OmarLopezCabrera/Tesis-SDR-LAPAC-Open-Source/Info Componentes/Power/ADP5054/PCB1.png

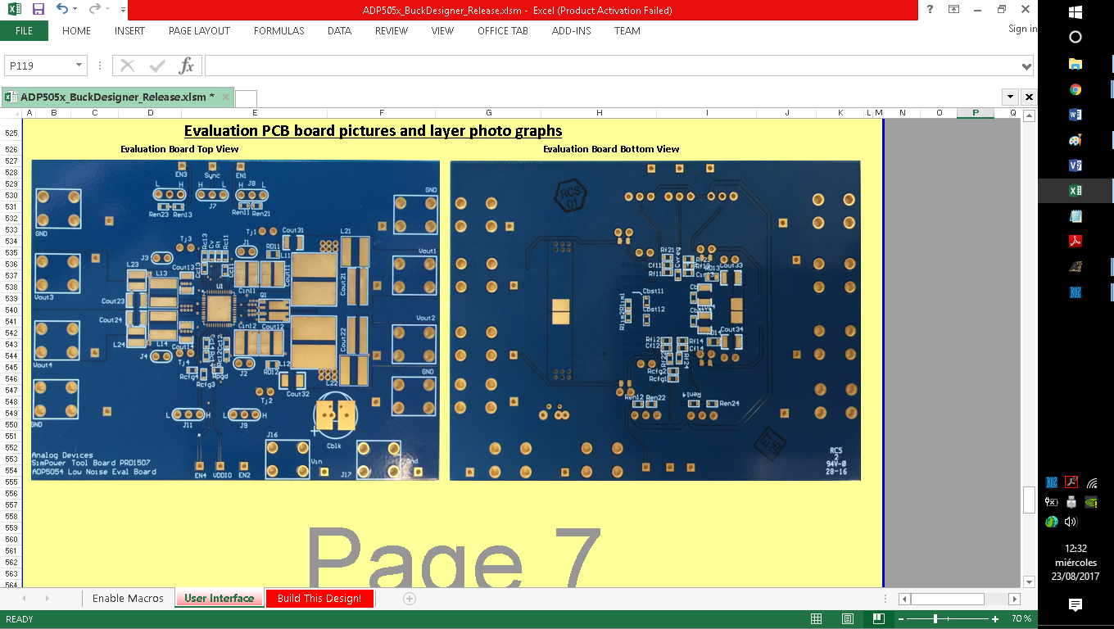
Info Componentes/Power/ADP5054/PCB1.png
