OmarLopezCabrera/Tesis-SDR-LAPAC-Open-Source/Info Componentes/Power/ADP5054/ADP505x_BuckDesigner_Release.pdf

and the security settings specified by you.

"User Interface" tab. A dialog box opens for you to enter your design

Excel 97-2003; Excel 2007

Disable all macros with notification), you will be prompted with a Security Warning: "Some

"Security Alert - Macros & ActiveX" or "Microsoft Office Excel Security Notice." or "Enable Macros", repsectively.

Microsoft Office button, Excel Options button, Trust Center category, Trust

Excel 2010
