OmarLopezCabrera/Tesis-SDR-LAPAC-Open-Source/Tesis(FaltaTerminar).pdf

## UNIVERSIDAD NACIONAL DE RÍO NEGRO

## PROYECTO FINAL INTEGRADOR

## Diseño e implementación de una

## Radio Definida por Software

Hecho por:

Omar López Cabrera

Director: Franco Alcaraz

Codirector: Federico Tula

Para el título de Ingeniería Electrónica

Índice

I

# Índice

Índice de figuras | IV
Índice de tablas | V
Lista de acrónimos | VI
Resumen | VIIII

## Tabla de contenido

Índice

II

Índice

III

Índice

IV

V

### Índice de Figuras

VI

### Índice de Tablas

VII

### Lista de Acrónimos

ADC: Analog to Digital Converter

ASICS: application specific integrated circuit

BB: Base Band

BBA: Base Band Amplifier

BBP: Base Band Processor

BGA: Ball Gate Array

BOM: Bill of Materials

CPU: Central Processing Unit.

CAD: Computer Assisted Design

DAC: Digital to Analog Converter

DDC: Digital Down Converter

DDR: Double Data Rate

DMA: Direct Memory Access

DUC: Digital Up Converter

DSP: Digital Signal Processor

EEPROM: Electrically Erasable Programmable Read-Only Memory

FAQ: Frequently Asked Questions

FDD: Frequency

FPGA: Field Programmable Gate Array

GPIO: General purpose input output

GPP: general purpose processor

IC: Integrated Circuit

JTAG: Joint Test Action Group

LPF: Low Pass Filter

LAPAC: Laboratorio de Procesamiento de Señales Aplicadas y Computación de Alto Rendimiento

MIMO: Multiple Input Multiple Output

VIII

PCB: Printed Circuit Board

RF: Radio Frequency

RFFE: Radio Frequency Front End

ROM: Read only memory

SDR Software Defined Radio

SPI: Serial Peripheral Interface

USB: Universal Serial Bus

XPE: Xilinx Power Estimator

IX

Resumen

Esta tesis describe el diseño del hardware para una Radio Definida por software (SDR). Partiendo de una arquitectura modular genérica, pasando a una arquitectura con componentes definidos, hasta el desarrollo del PCB de la misma.

Esta SDR cubre un rango de frecuencia de 70 MHz hasta 6 GHz, tiene una conexión USB 3.0 y una FPGA Artix-7. Dicha FPGA puede ser programable por USB; esta característica permite realizar experimentos en un rango de las siguientes señales: FM, TV brodcast, celular, Wi-Fi entre otros. El Front End de RF está compuesto por el transceiver AD9364 de Analog Devices el cual tiene 56 MHz de ancho de banda instantáneo. Este dispositivo puede ser alimentado por USB o por medio de un conector tipo Jack.

Esta placa puede utilizarse en los laboratorios de todos los cursos de comunicaciones de la carrera, además de los cursos de procesamiento de señales aleatorias y determinísticas. Solo requiere un par de antenas y contar con una computadora donde se programa el tipo de procesamiento que se desea hacer con los datos, utilizando software abierto (GNU Radio). Este tipo de equipos está presente en todas las carreras de Telecomunicaciones de las Universidades más prestigiosas del mundo, debido a la facilidad con que permiten realizar experimentos complejos y entender, rápidamente, el estado del arte. Al ser un desarrollo propio se pretende que el proyecto se pueda distribuir como hardware libre. De este modo, cualquier persona o institución que lo desee puede utilizarla si más que tener que mencionar el origen. Esto dará visibilidad a la UNRN y a la carrera de Ingeniería Electrónica en particular.

### 1. Introducción

## Capítulo 1

## 1. Introducción

1.1 Que es una radio definida por software

El termino radio definida por software fue utilizado por Joe Mitola en 1991 en referencia a las radios reprogramables o reconfigurables. En otras palabras, un mismo hardware puede realizar diferentes funciones en momentos diferentes. El foro de SDR las define como una radio en la cual se puede programar el tráfico y control de la información, soportando un amplio rango de frecuencias y aplicaciones de software. El usuario puede cambiar de un formato de comunicación a otro en cuestión de milisegundos, usar el GPS para localización o recibir una transmisión satelital.

1.2 Por qué utilizar radios definidas por software?

En el mundo de las comunicaciones inalámbricas, los estándares y protocolos avanzan a una velocidad tal que los equipos de comunicaciones quedan obsoletos poco después de su producción. Para remediar esto, las SDR representan un cambio en el paradigma comparado con las radios tradicionales, en donde gran parte de su funcionalidad es implementada mediante software en lugar de hardware. Este cambio, reduce la cantidad de componentes analógicos y de radio frecuencia (RF), haciendo énfasis en el procesamiento de señales y la programación, logrando una gran versatilidad en el receptor.

1.3 Aplicaciones y características de las SDR

Interoperabilidad: Una SDR puede operar como puente entre múltiples sistemas de radios incompatibles. Interoperabilidad es una de las principales razones por las cuales los militares estaban interesados en ellas. Diferentes ramas de los militares y los policías usan decenas de radios incompatibles, escondiendo comunicaciones durante operaciones conjuntas. Una SDR multicanal puede actuar como intérprete de las diferentes radios.

### 1. Introducción

Eficiencia en el uso de recursos ante condiciones variables: Una SDR puede adaptar la forma de onda para maximizar algún parámetro clave. Por ejemplo, una forma de onda de baja potencia puede ser seleccionada si la radio esta baja de batería. Una señal de alta tasa puede ser seleccionada si se requiere bajar un archivo rápido. Eligiendo la forma de onda más apropiada en cada escenario, las radios pueden proveer una mejor experiencia al usuario (por ejemplo, mayor durabilidad de la batería).

Uso conveniente de las frecuencias (Radio Cognitiva): Una SDR puede sacar ventaja del espectro de frecuencia que no está siendo utilizado. Si el dueño de la porción de espectro no está utilizando la misma, una SDR puede pedir prestado hasta que el dueño vuelva. Esta técnica tiene un gran potencial para incrementar la cantidad de espectro disponible.

Aumento de tiempo de vida útil: Una SDR puede actualizarse en el campo para soportar los últimos estándares de comunicaciones. Esta capacidad es de especial importancia para el ciclo de vida de las radios en aplicaciones militares, comunicaciones o aeroespaciales .Por ejemplo, un nuevo estándar de celular que sale al mercado puede ser cargado remotamente mediante un nuevo software en la estación base (SDR), ahorrando costos de un nuevo hardware y trabajo de instalación.

Bajo costo: Una SDR puede adaptarse para usarse en diferentes mercados y múltiples aplicaciones. Algunas radios pueden ser vendidas a compañías de celulares o automóviles, reduciendo costos de mantenimiento y entrenamiento.

Investigación y desarrollo: Las SDR puede ser utilizadas para implementar diferentes formas de ondas en tiempo real para análisis de performance.

1.4 Requerimientos/ objetivos de la tesis

La finalidad de este Proyecto Final integrador es el diseño e implementación de una Radio Definida por Software (SDR: Software Defined Radio). Además de este objetivo principal el plan de trabajo estipulaba los siguientes requerimientos:

- Poder escuchar las radios comerciales de FM mediante el hardware a desarrollar y una computadora utilizando el programa open source GNU-RADIO.

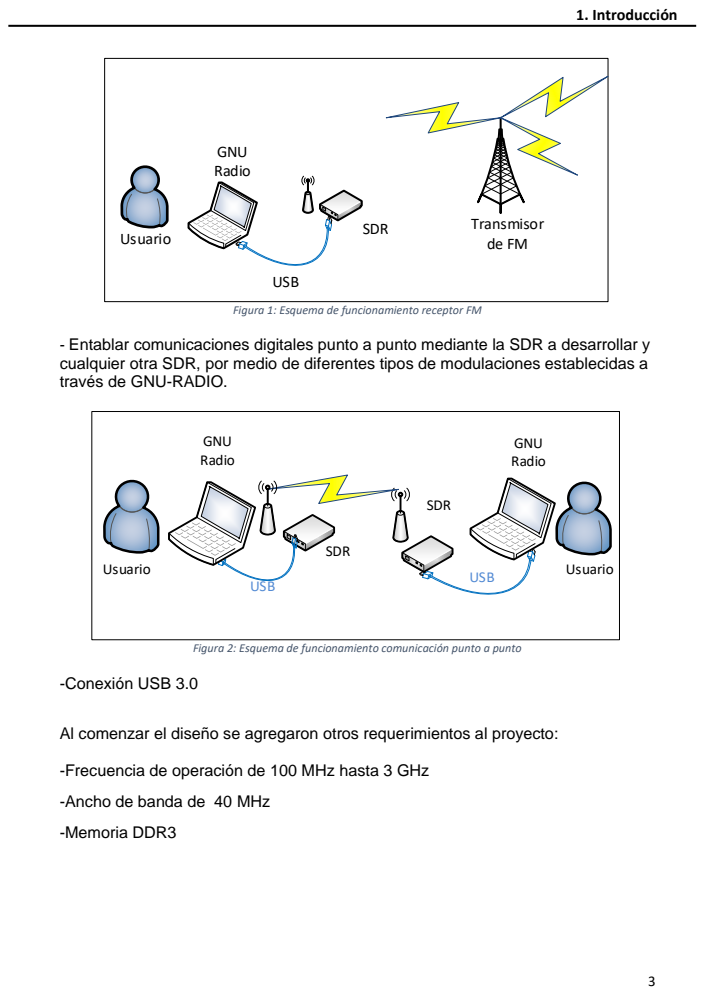
[picture p2: page 13]
1. Introducción; USB; SDR; Transmisor; Usuario; GNU Radio; USB USB; -Conexión USB 3.0; -Memoria DDR3

Figura 1: Esquema de funcionamiento receptor FM

- Entablar comunicaciones digitales punto a punto mediante la SDR a desarrollar y
cualquier otra SDR, por medio de diferentes tipos de modulaciones establecidas a
través de GNU-RADIO.

Figura 2: Esquema de funcionamiento comunicación punto a punto

Al comenzar el diseño se agregaron otros requerimientos al proyecto:

-Frecuencia de operación de 100 MHz hasta 3 GHz

-Ancho de banda de 40 MHz

### 1. Introducción

1.5 Metodología de diseño

Para realizar este proyecto se utilizó una metodología de diseño Top-Down. La cual consiste en capturar una idea con un alto nivel de abstracción, implementarla partiendo de la misma, e incrementar el nivel de detalle según sea necesario. El sistema inicial se va subdividiendo en módulos, estableciendo una jerarquía. Cada módulo se subdivide hasta llegar a los componentes primarios del diseño.

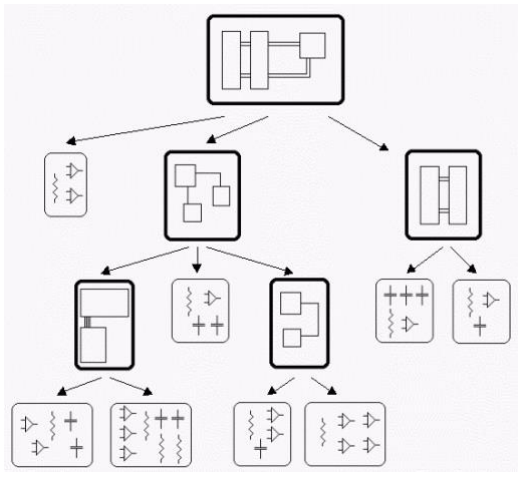
[picture p3: figure]

Figura 3: Diagrama metodología de diseño Top-Down

Utilizando la idea de este método se desarrolló el diseño de la SDR dividiendo al mismo en las siguientes etapas:

- Diseño Modular según funciones
- Diseño Modular especifico
- Selección de Componentes
- Diseño del esquemático
- Diseño del PCB
- Simulaciones
- Fabricación y ensamblado de la placa
- Puesta en marcha

### 1. Introducción

Debido a la envergadura del proyecto no se pudieron realizar las últimas tres etapas, quedando estas como trabajo a futuro.

### Agregar sección comparando radio tradicional con SDR. Gráficos de las dos y tabla de ventaja y desventaja ?

### 2. Diseño

## Capítulo 2

## 2. Diseño

2.1 Arquitectura general según funciones

La arquitectura de las SDR debe permitir que el funcionamiento del sistema sea definido por software, esto significa, que una porción del sistema se implementara mediante programación y/o reconfiguración del hardware. Permitiendo que el hardware del sistema pueda reutilizarse para distintas aplicaciones sin la necesidad de modificaciones físicas del mismo.

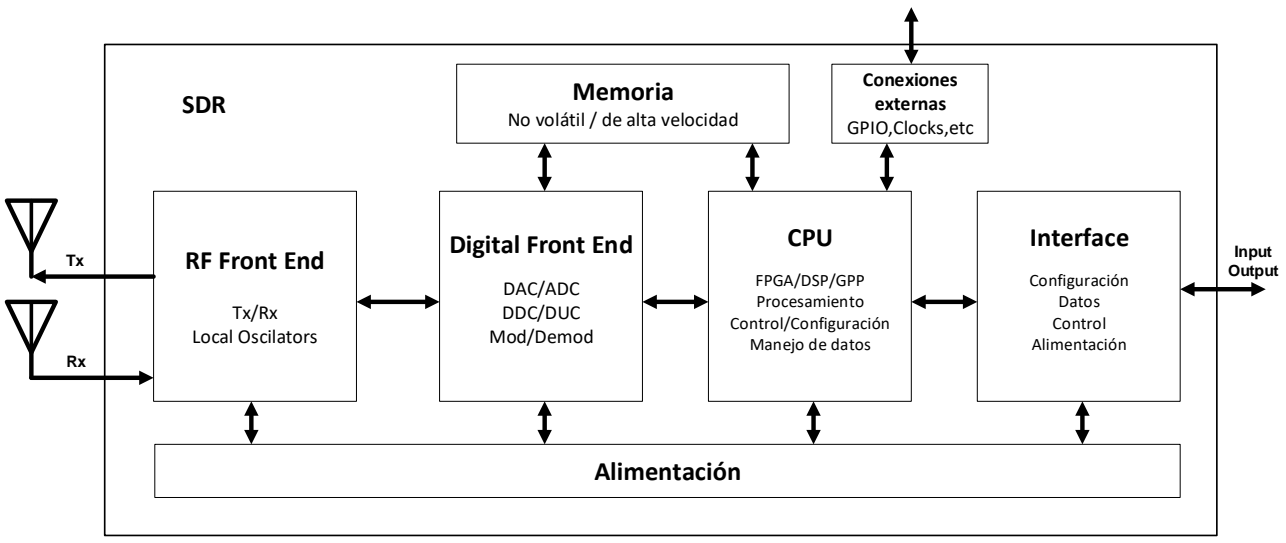
[picture p4: figure]
Digital Front End; DAC/ADC DDC/DUC Mod/Demod; RF Front End; Tx/Rx Local Oscilators; CPU; FPGA/DSP/GPP Procesamiento Control/Configuración Manejo de datos; Interface; Configuración Datos Control Alimentación; Memoria; No volátil / de alta velocidad; Alimentación; Conexiones externas GPIO,Clocks,etc; SDR; Input Output

Figura 4: Diagrama en bloques de la arquitectura general de la SDR

2.1.1 Antenas

Conjuntos de antenas de transmisión y recepción. Las mismas deben ser capaces de operar en el rango de frecuencia requerido.

2.1.2 RF Front-End

Su función es el acondicionamientos tanto de las señales recibidas como las transmitidas por las antenas correspondientes. En dicho acondicionamiento comprende: filtrado, amplificación, conversión de frecuencia etc.

### 2. Diseño

2.1.3 Digital Front-End

La función de este módulo es la conversión analógica-digital en la recepción y digital-analógica en la transmisión.

También es posible realizar procesamientos digitales sobre las señales como por ejemplo:

-Modulación

-Demodulación

-Diezmado

-Interpolación

2.1.4 CPU

Sus principales funciones son: control, configuración, manejo de datos e interconexión entre los diferentes módulos (memoria, gpio, external interface, digital front-end).

Además también se puede realizar procesamientos, algoritmos, encriptación/des encriptación etc.

2.1.5 Memoria

La memoria del sistema puede estar compuesta por memorias de alta velocidad y/o memorias no volátiles.

2.1.6 Conexiones externas

Este módulo contiene las conexiones físicas de la SDR con elementos externos, como por ejemplo: GPIO, alimentación, Clock externo, etc.

2.1.7 Interfaces

Es el bloque que encargado de las interconexiones de la SDR con el resto de sistema, para las líneas de datos, configuración, programación y control.

### 2. Diseño

2.1.8 Alimentación

Su función es proveer la alimentación a los módulos nombrados anteriormente. En el mismo se realizaran las diferentes conversiones de DC a DC que sean necesarias.

2.2 Arquitectura definida

En base a las funciones expuestas en la sección anterior, los requerimientos y los componentes disponibles en el mercado se decidió adoptar la siguiente arquitectura para la implementación de la SDR.

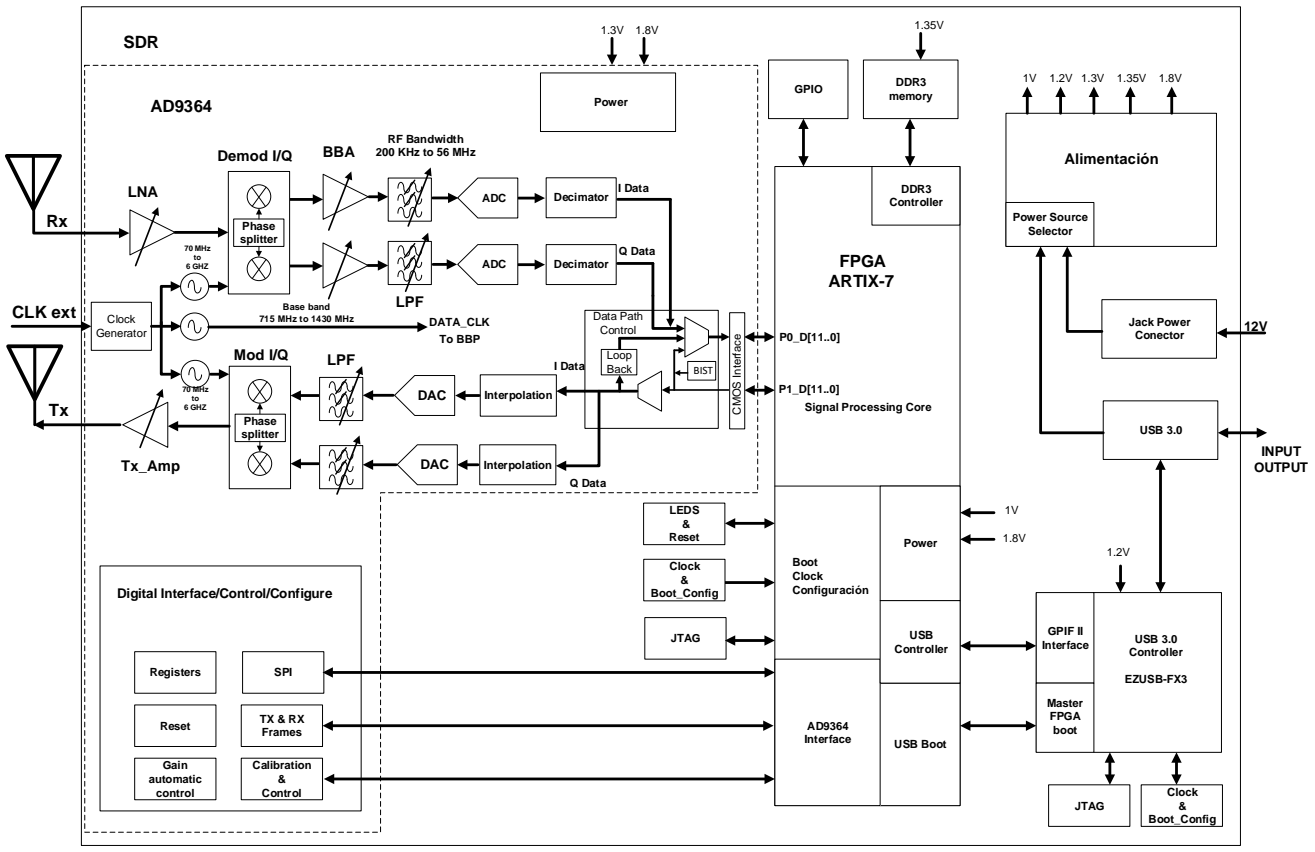
[picture p5: figure]
Digital Interface/Control/Configure; FPGA ARTIX-7; Signal Processing Core; Boot Clock Configuración; USB 3.0 Controller; EZUSB-FX3; USB 3.0; DDR3 memory GPIO; LEDS &; Reset; JTAG; USB Boot; Decimator; Interpolation; Phase splitter; DDR3 Controller; Alimentación; Jack Power Conector; Power Source Selector; Clock &; Boot_Config; Clock Generator; SPI; Calibration &; Control; Registers; Gain automatic control; Frames; Interface; Clock & Boot_Config; 70 MHz to 6 GHZ; Base band CLK ext; 715 MHz to 1430 MHz; GPIF II Interface USB Controller; Master FPGA; boot; I Data; Q Data; LNA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

Figura 5: Diagrama en bloques de la Arquitectura definida de la SDR

A continuación se detallara información sobre cada módulo de esta arquitectura.

### 2. Diseño

2.2.1 RF Front End & Digital Front End

Se decidió utilizar un transceiver integrando ambos Front End en un solo IC, lo que significa una menor cantidad de componentes y superficie. Este fue el primer componente seleccionado, ya que el mismo determinara las principales características de la SDR (ancho de banda, rango de frecuencia, etc.). Además el mismo fija requerimientos para las demás etapas del sistema (alimentación a utilizar, tasa de datos necesaria, etc.).

En base a los requerimientos estipulados los posibles transceiver encontrados en el mercado fueron los siguientes:

Tabla 1: Transceivers disponibles en mercado.

Se descartó el transceiver LMS6002 por los siguientes motivos:

- No cumple con el ancho de banda (requerimiento que podría ser flexible debido a su bajo precio).
- Ya existe una SDR open source que utiliza este transceiver (proporcionan: gerbers, esquemáticos y proyecto entero en Altium Designer).
- Escases de información en cuanto a funcionamiento y guías de diseño.

Se decidió utilizar el AD9364 y dejar al AD9361 para una posible mejora a futuro convirtiendo a la SDR en una MIMO. En particular ya existen SDRs open source con este transceiver (empresa Ettus) pero solo comparten información sobre el esquemático.

Este dispositivo combina un Front End de RF con un flexible mezclador de señales en banda base y un sintetizador de frecuencia integrado. Simplificando el diseño a una interface digital de configuración por medio de un procesador.

Por medio del bus SPI se tiene todo el control de toda la parte digital del AD9364.Cada registro SPI es de 8 bit de ancho y contienen: bits de control, monitores de estado y otras configuraciones que controla todas las funciones del dispositivo (filtrado, ganancia, etc.).
En la siguiente figura exponemos que porción de la arquitectura de la SDR será cubierta por este IC:
Integrado | fabricante | Ancho de banda | Rango de Frecuencia | Costo($USD)
AD9361 | Analog Devices | 56 MHz | 70 MHz-6GHz | 214.31
AD9364 | Analog Devices | 56 MHz | 70 MHz-6GHz | 159.20
LMS6002DFN | Lime MicroSystems | 28MHz | 0.3-3.8GHz | 35.00

### 2. Diseño

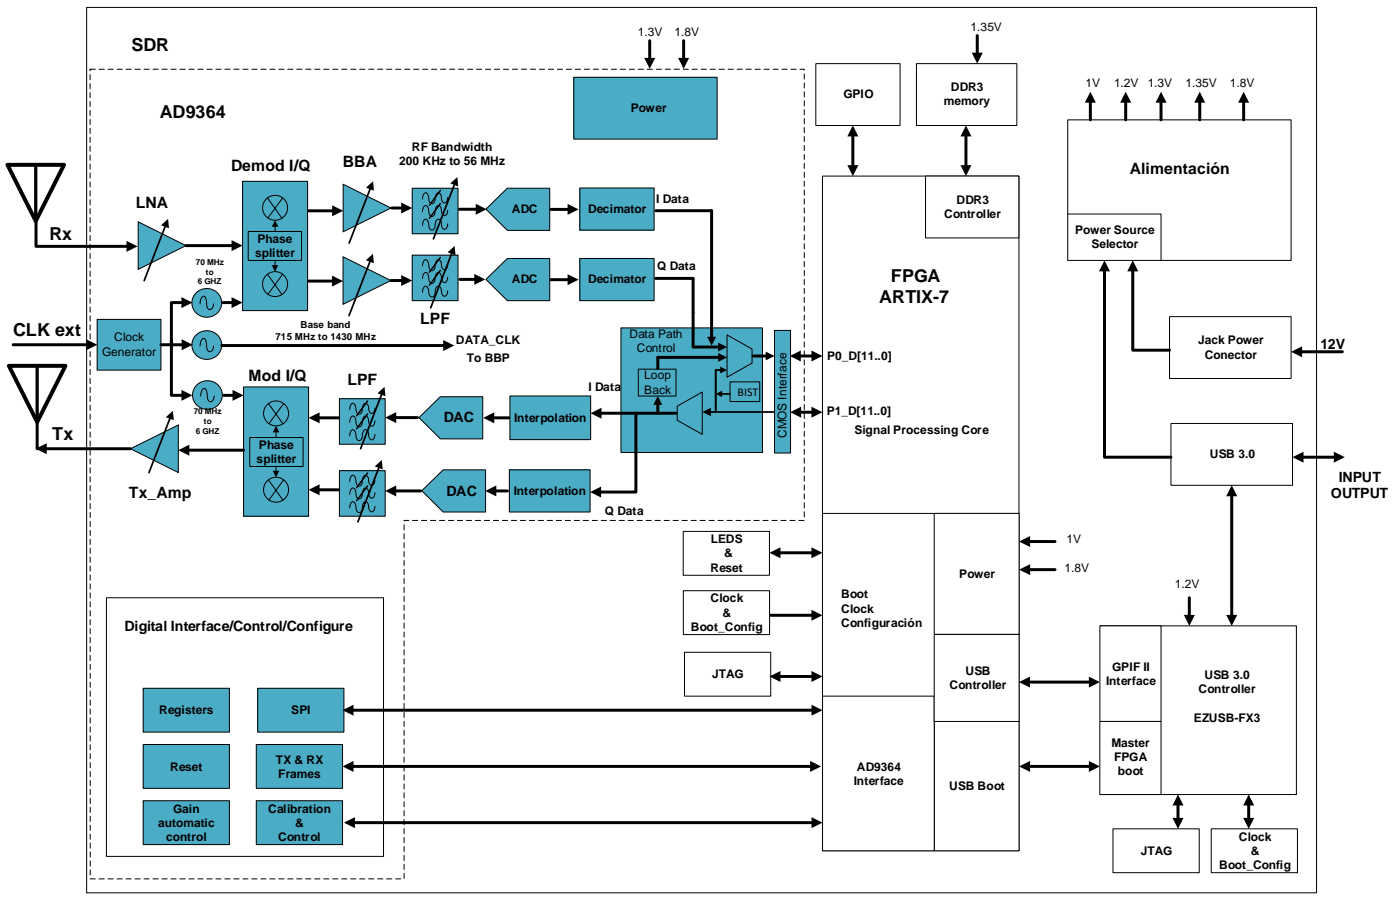
[picture p6: figure]
Digital Interface/Control/Configure; FPGA ARTIX-7; Signal Processing Core; Boot Clock Configuración; USB 3.0 Controller; EZUSB-FX3; USB 3.0; DDR3 memory GPIO; LEDS &; Reset; JTAG; USB Boot; Decimator; Interpolation; Phase splitter; DDR3 Controller; Alimentación; Jack Power Conector; Power Source Selector; Clock &; Boot_Config; Clock Generator; SPI; Calibration &; Control; Registers; Gain automatic control; Frames; Interface; Clock & Boot_Config; 70 MHz to 6 GHZ; Base band CLK ext; 715 MHz to 1430 MHz; GPIF II Interface USB Controller; Master FPGA boot; I Data; Q Data; LNA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

Figura 6: Diagrama de arquitectura definida, sección transceiver

Este conjunto de módulos tendrá las siguientes funciones:

- Convertir las señales de RF a BB para la recepción
- Convertir las señales BB a RF para la transmisión
- Acondicionamiento de las señales

A continuación se explicara la función que cumple cada uno de los módulos que componen al transceiver:

Analog to Digital conversión (ADC).

Convierte al dominio digital de las señales en banda base entregadas por todo el camino de recepción. El mismo es de 12 bits.

Digital to Analog conversión (DAC).

Conversión al dominio analógico de las señales en banda base a ser entregadas al camino de transmisión (up-conversión) por la antena de la SDR. El mismo es de 12 bits.

### 2. Diseño

Demod I/Q

Convierte la señal de RF que entrega la cadena de recepción del RFFE a banda base para su posterior digitalización y procesamiento.

Mod I/Q

Convierte la señal en banda base a transmitir a RF para ser luego amplificadas por el RFFE en su cadena de transmisión.

Diezmado

El proceso de diezmado consiste en quedarse con una de cada n muestras, siempre dentro de los límites de Nyquist. Este límite es determinado por el ancho de banda de los filtros pasa bajo.
Este proceso es útil ya que baja la tasa de datos hacia procesador y demanda menos almacenamiento.

Interpolación

El proceso de interpolación consiste en aumentar la tasa de muestreo en n. Este proceso no cambia la frecuencia de la señal solo su tasa de muestreo.

Low noise amplifier (LNA)

Los amplificadores de bajo ruido amplifican señales de bajo poder sin degradar su relación señal a ruido. Este es un componente clave en el Front-End de RF para reducir el ruido, ya que la figura de ruido es dominada por las primeras etapas del receptor.

Low Pass Filter (LPF)

Los filtros pasa bajo dejan pasar las señales con una frecuencia menor a la frecuencia corte y atenúa las señales mayores a la misma. En particular estos filtros son de tercer orden Butterworth y su frecuencia de corte es programable en el rango de 200 kHz a 39.2 Mhz.

Generador de señales BITS

### 2. Diseño

Este integrado dispone en un generador de señales interno con el cual se puede inyectar señales tanto en el puerto de salida de datos de Tx como en el de entrada de Rx. Este es útil como herramienta de debugging a la hora de probar la conectividad de los puertos de Tx y Rx.

Digital Interface

Por medio este módulo se realiza la interface con el BBP, pudiendo configurar completamente el transceiver. Cada uno de los módulos nombrados anteriormente (ADC, filtros, etc.) esta mapeado a una dirección memoria (registros), los cuales se van modificando por comandos a través de SPI. Mediante estas modificaciones se puede configurar entre otras cosas:

- Ganancia de los amplificadores.
- Frecuencia de corte filtros.
- Frecuencia de los osciladores locales.
- Modo de operación.
- Calibración.

2.2.1.1 Modos de funcionamiento del transceiver

Este transceiver puede ser utilizado en los siguientes modos de operación:

Dual port full duplex mode.

El modo de operación Dual Port Full Duplex es usado en aplicaciones que requieren operar en FDD (frequency-division duplex) y tasas de dato menores a 61.44 MHz. En este modo ambos puertos de datos son utilizados, P0 es asignado a los datos recibidos y P1 es asignado a los datos transmitidos. Cada bus de datos opera simultáneamente, permitiendo una transferencia full dúplex para los datos de transmisión y recepción entre el BBP y el AD9364.
La siguiente figura muestra las conexiones entre el transceiver AD9364 y el BBP (FPGA) para este modo de operación.

### 2. Diseño

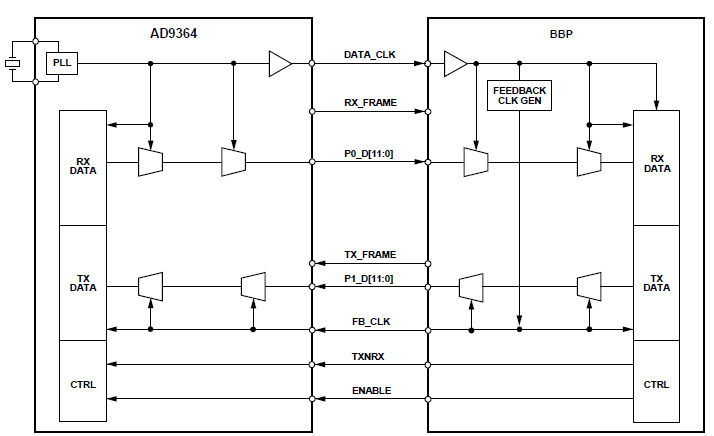
[picture p7: figure]

Figura 7: Diagrama de conexión transceiver-FPGA modo de operación full dúplex

Los datos transmitidos en P1_D[11:0] que van desde el BBP hacia el AD9364 son capturados por medio del FB_CLK. Mientras que los datos recibidos en P0_D[11:0] que van desde el AD9364 hacia el BPP son capturados por medio de DATA_CLK.

Un pulso en el pin de ENABLE (un flanco ascendente) dispara el comienzo de transferencia de datos y otro pulso (un flanco descendente) da fin a la transferencia de datos.

Las señales Rx_FRAME y Tx_FRAME (con un flanco ascendente) indican el comienzo de un conjunto de muestras (frames).

Para los datos de Tx, P1_D[11] es el bit más significativo y P1_D[0] es el bit menos significativo. Para los datos de Rx, P0_D[11] es el bit más significativo y P0_D[0] es el bit menos significativo.

Los datos I/Q son transportados en el mismo bus en cada dirección. Para un solo camino de RF en cada dirección los datos son transportados de la siguiente manera:

Datos de Tx o Rx : I, Q, I, Q, …..

A continuación se mostraran unos diagramas de tiempos de las distintas señales tanto para la transmisión como la recepción, en el modo de operación full dúplex.

Figura 8: Diagrama tiempo, recepción en modo full dúplex

### 2. Diseño

Falta comentar imagen

Figura 9: Diagrama de tiempo, transmisión en modo full dúplex

Falta comentar imagen

Dual port half duplex mode.

El modo de operación dual port half dúplex es utilizado en aplicaciones que requieren operaciones TDD (time-division dúplex) y una tasa de datos hasta 61.44 MHz. En este modo ambos puertos son utilizados, el puerto P0 es asignado a los datos I y el puerto P1 es asignado a los datos Q. En este modo los puertos operan de forma bidireccional, la dirección es determinado por el canal que está activo: transmisión o recepción. La siguiente figura ilustra las conexiones entre el AD9364 y el BBP en este modo de operación.

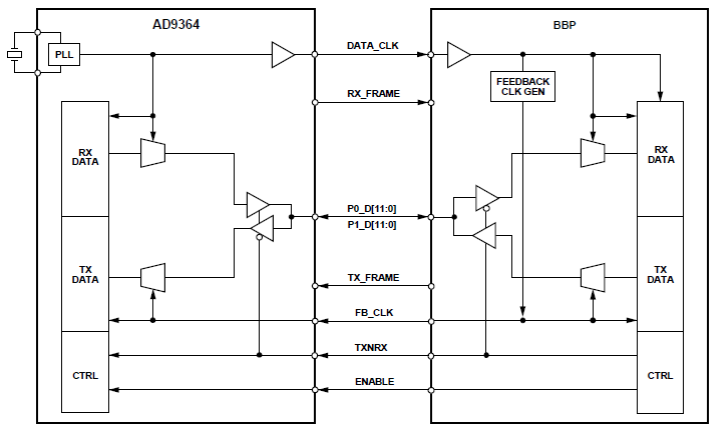
[picture p8: figure]

Figura 10: Diagrama de conexión transceiver-FPGA modo de operación half dúplex

Durante una ráfaga de recepción, los datos suministrados por el AD9364 hacia el BBP son capturados por medio del DATA_CLK. La transferencia de datos empieza cuando una señal de pulso alto aparece en el pin de ENABLE y la misma termina cuando el pulso vuelve a bajo.

La dirección de la transferencia de datos es determinada por la señal TXNRX. Cuando esta señal es baja el AD9364 está en modo de recepción, configurándose el bus en la dirección de recibir, los datos son transferidos desde el AD9364 hacia el BBP. Cuando la señal de TXNRX es alta, la dirección de transmisión del bus es cambiada, los datos son transferidos desde el BBP hacia el AD9364.Durante una ráfaga de transmisión los datos suministrados

### 2. Diseño

desde el BBP hacia el AD9364 son capturados por medio de FB_CLK. Las señales Rx_FRAME y Tx_FRAME indican el comienzo de un conjunto de muestras.

Para las líneas de datos D[11] es el bit más significativo mientras que D[0] es el bit menos significativo. Las muestras son separadas de la siguiente manera: los datos I en el puerto P0_D[11:0] y los datos Q en el puerto P1_D[11:0].

A continuación se mostraran unos diagramas de tiempos de las distintas señales tanto para la transmisión como la recepción para el modo de operación half dúplex.

Figura 11: Diagrama de tiempo, recepción en modo de operación half dúplex

Falta comentar imagen

Figura 12: Diagrama de tiempo, transmisión en modo de operación half dúplex

Falta comentar imagen

2.2.2 USB 3.0

La mayor tasa de datos del sistema está determinado por el transceiver, el cual tiene una tasa máxima de aproximadamente 188 MB/seg (66.44 Mhz de clock máximo y 24 líneas de dato).Para este proyecto una conexión USB 2.0 (60 MB/seg idealmente) no es suficiente para operar a la máxima tasa de datos por la tanto se decidió utilizar una conexión USB 3.0 (625 MB/seg).

2.2.2.1 Información general USB 3.0

Las especificaciones del USB 3.0 permite una tasa de transferencia máxima de 5 Gbps (SuperSpeed), la cual es 10 veces más que la tasa del USB 2.0

### 2. Diseño

(High Speed).La arquitectura del USB 3.0 contiene tres capas: physical layer, link layer y protocol layer.

Physical Layer

La capa física hace referencia al puerto de conexión y al cable de conexión, mediante el cual se realiza el upstream y downtream. Los cables diferenciales de transmisión y recepción de datos del USB 3.0 esta mallados y separados. Los cables USB 3.0 incluyen a los utilizados en el USB 2.0 como se muestra en la siguiente figura.

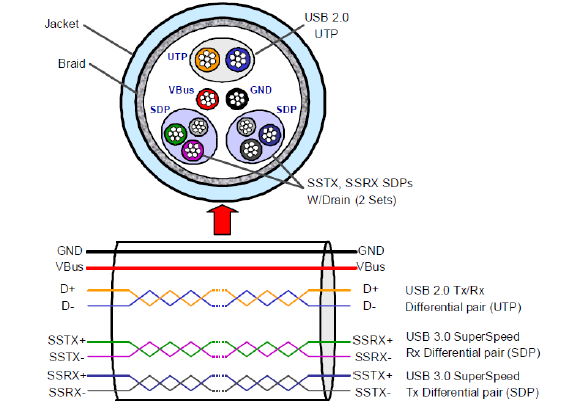
[picture p9: figure]

Figura 13: Cables USB 3.0

El bus SuperSpeed emplea un enfoque dual y simple, el cual permite transmitir y recibir paquetes simultáneamente. Por ejemplo durante una ráfaga de transacciones, el dispositivo puede recibir datos desde el host y devolver una confirmación asociada con los datos recibidos.

Link Layer

La link layer es la responsable de mantener una comunicación confiable y robusta entre el host y el dispositivo. Este mantenimiento lo realiza utilizando una máquina de estados llamada “Link Training and Status State Machine” (LTSSM).

Protocol Layer

La capa de protocolo maneja las reglas de comunicación entre el host y el dispositivo.

2.2.2.2 Controlador USB 3.0 CYUSB3014

### 2. Diseño

El dispositivo que se decidió utilizar como controlador del USB3.0 es el CYUSB3014 de la compañía Cypress. Este es un controlador de periféricos de SuperSpeed que provee características integradas y flexibles.

Este controlador es totalmente configurable, paralelo y posee una interface programable llamada GPIF II, mediante la cual se puede conectar a cualquier tipo de procesador, ASIC o FPGA.

A continuación se mostrara una vista general de este dispositivo:

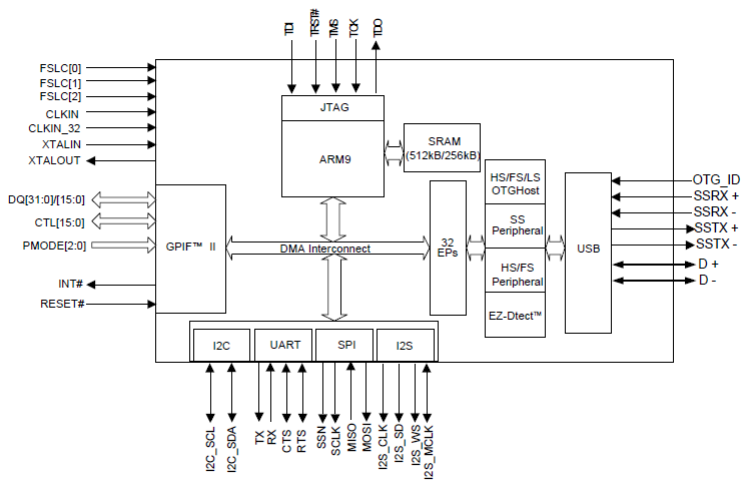
[picture p10: figure]

Figura 14: Diagrama en bloques controlador USB 3.0

CPU

El dispositivo cuenta con un CPU de 32 bits, un ARM92EJ-S de 200 MHz. Este core tiene acceso directo a una memoria de instrucciones de 16 KB y una de 8 KB para datos. Además tiene dos memorias cache (una para instrucciones y otra para datos) de 8KB cada una.
DMA

El dispositivo habilita eficientes y flexibles transferencias del DMA entre varios periféricos (USB, GPIF II, SPI, I2S y UART).

JTAG Interface

### 2. Diseño

Es una interface estándar de 5 pines para conectar el JTGA con el debug firmware a través del CPU. Cualquier herramienta estándar de debugging para ARM926EJ-S puede ser utilizada para este dispositivo.

Boot Options

El dispositivo tiene integrado una ROM de 32 KB, la cual contiene el bootloader, permitiendo que se baje la imagen desde diferentes fuentes. El modo de boot se selecciona mediante los pines PMODE, la siguiente tabla muestra las diferentes configuraciones de boot.

Tabla 2: Opciones de Booting USB 3.0
Z = Pin is floating; left unconnected.

En este caso se decidió que el boot sea por medio de una memoria EEPROM y en caso de fallo por medio del USB (PMODE [2:0] = 000).

CLOCKING

Este dispositivo permite conectar un cristal entre los pines XTALIN y XTALOUT o conectar un clock externo en pin CLKIN. Estos pines pueden dejarse sin conectar de no ser usados. La frecuencia de cristal soportada es de 19.2 MHz.

Mediante los pines FSLC [2:0] se determina que opción fue seleccionada: cristal o clock externo. La siguiente tabla muestra las diferentes opciones de cristal o clock externo:

FSLC[2] | FSLC[1] | FSLC[0] | Crystal/Clock Frequency
0 | 0 | 0 | 19.2-MHz Crystal
1 | 0 | 0 | 19.2-MHz Input CLK
1 | 0 | 1 | 26-MHz Input CLK
1 | 1 | 0 | 38.4-MHz Input CLK
1 | 1 | 1 | 52-MHz input CLK
Tabla 3: Selección de clock USB 3.0
PMODE[2:0] | Boot Option
PMODE[2] | PMODE[1] | PMODE[0]
Z | 0 | 0 | Sync ADMUX (16-bit)
Z | 0 | 1 | Async ADMUX (16-bit)
Z | 0 | Z | Async SRAM (16-bit)
Z | 1 | 1 | USB Boot
1 | Z | Z | I2C
Z | 1 | Z | I2C; on failure, USB Boot is enabled
0 | Z | 1 | SPI; on failure, USB Boot is enabled
0 | 0 | 0 | S0-port (eMMC); On Failure, USB Boot is enabled

### 2. Diseño

Como fuente de clock se utilizó un cristal de 19.2 MHz (FSCL[2:0] = 000).

GPIF II

La interface GPIF II es una máquina de estado programable la cual permite una interface flexible con la CPU, esta puede funcionar como master o slave.

GPIF II tiene las siguientes características:

-Funciona como master o slave.

-Ofrece 256 estados de firmware programables.

-Soporta 8-bit, 16-bit, and 32-bit de bus de datos paralelo

-Frecuencia de interface hasta 100 MHz

-Soporta 14 pines de control configurables cuando se utiliza un bus de datos de 32-bits; todos los pines de control pueden ser entrada, salida o bidireccionales

-Soporta 16 pines de control configurables cuando se utiliza un bus de datos de 16 o 8 bits; todos los pines de control pueden ser entrada, salida o bidireccionales

Una de las implementaciones más populares de GPIF II es la interface sincrónica: Slave FIFO. Esta interface es utilizada en aplicaciones en donde el dispositivo externo que está conectado a este controlador lee o escribí datos desde el.

Faltaria hablar sobre el modo de funcionamiento “FIFO SLAVE”??
2.2.3 Memoria DDR3 (Falta completar)

La inclusión de una memoria externa no estuvo en las consideraciones iniciales, se decidió agregarla ya que dota al sistema con la posibilidad de almacenar los datos, ya sean procesados por la FPGA o directamente los datos crudos capturados por el transceiver. El costo de esta inclusión fue de un incremento de en la complejidad del sistema en: una mayor densidad de ruteo de señales en la placa, una ramificación extra de tensión de alimentación y un pequeño coste económico extra.

Se utilizó una de memoria DDR3L con una capacidad total de 256MB .El modelo de la memoria es el MT41J128M16JT-125 fabricado por Micrón. El mismo cuenta con 14 líneas de dirección (A[13..0]), 3 líneas para selección de banco (BA[2..0]), 16 líneas de datos [15..0]. Al utilizar una sola memoria no es necesaria utilizar terminaciones (on die terminations).

### 2. Diseño

Además para esta memoria, la herramienta de programación Vivado, provee controladores para la misma. Disminuyendo el tiempo de programación en el futuro.

For proper operation of the memory, a memory controller and physical layer (PHY) interface needs to be included in the FPGA design. The easiest way to accomplish this on the Arty is to use the Xilinx 7-series memory interface solutions core generated by the MIG (Memory Interface Generator) Wizard. Depending on the tool used (ISE, EDK or Vivado), the MIG Wizard can generate a native FIFO-style or an AXI4 interface to connect to user logic.

Hablar sobre velocidad de clock máxima, mínima, código del modelo

Encapsulado y pines?

2.2.4 CPU

A la hora de elegir la CPU algunas de las opciones pueden ser las siguientes:

ASIC: Es un circuito integrado (https://es.wikipedia.org/wiki/Circuito_integrado) hecho a la medida para un uso en particular, en vez de ser concebido para propósitos de uso general. Son utilizados cuando se necesita una alta tasa de datos a un consumo de energía razonable.

FPGA: Son integrados capaces de ser reprogramados al contener una matriz de bloques lógicos reprogramables. Pueden soportar altas tasas y altos niveles de consumo de energía.

GPP: Son procesadores de propósito general los cuales pueden procesar tasas bajas/medias de señales en tiempo real. Estos son ideales cuando el consumo de energía no es de gran importancia.

DSP: Un procesador digital de señales, es un sistema basado en un procesador o microprocesador (https://es.wikipedia.org/wiki/Microprocesador) que posee un conjunto de instrucciones, (https://es.wikipedia.org/wiki/Conjunto_de_instrucciones) un hardware (https://es.wikipedia.org/wiki/Hardware) y un software (https://es.wikipedia.org/wiki/Software) optimizados para aplicaciones que requieran operaciones numéricas a muy alta velocidad. Por lo general no ofrecen suficiente tasa o bajo consumo como las demás opciones. Son utilizados cuando los GPP no son lo suficientemente rápidos, el consumo es demasiado o los desarrolladores no tienen experiencia en FPGA.

### 2. Diseño

En la siguiente figura se mostrara una comparativa entre las diferentes soluciones para la CPU:

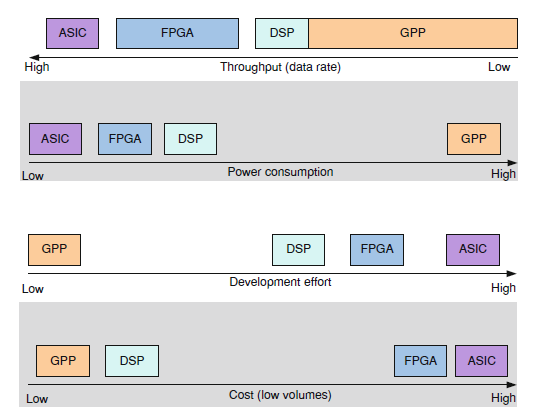
[picture p11: figure]

Figura 15: Comparativa entre los posibles CPUs

Se decidió utilizar una FPGA como CPU por las siguientes razones:

- Gran tasa de datos,
- Gran ancho de banda
- Flexibilidad.
- Paralelismo.
- Reconfigurable

2.2.4.1 Selección de FPGA (Falta completar)

Primero se debe seleccionar que proveedor utilizar, en el mercado de las FPGAs existen 2 grandes empresas Xilinx y Altera. Debido a previo conocimiento de las FPGAs de Xilinx se decidió utilizar este proveedor.

Una vez seleccionado el proveedor, se decidió utilizar la serie 7 de Xilinx ya que es la más actual y utilizan el entorno Vivado para ser programadas. Esta serie tiene las siguientes gamas:

- Spartan-7
- Artix-7
- Kintex-7
- Virtex-7

Se decidió utilizar la Artix-7 ya que su costo era mucho menor que las de gama alta (Kintex-7 y Virtex-7).La Spartan-7 se descartó debido a que la Artix-7

### 2. Diseño

poseía mayor número de DSP slices a un precio similar. Para ver las diferentes características de estas FPGAs ver [1].

Luego para seleccionar el modelo adecuado de FPGA Artix-7 se tuvo en cuenta las siguientes características:

Recursos FPGA: En principio, lo ideal es tener muy bien definido lo que se va a programar en ella, tener implementado todo el código en VHDL. Además, se debe disponer de recursos extras para darle la libertad al usuario de implementar otros procesamientos en la FPGA.

Sin embargo, en el contexto de este proyecto esto no es aplicable, principalmente por falta de: tiempo y dispositivos con características a fines a lo propuesto.

Por lo tanto, para estimar los recursos necesarios de la FPGA se realizó un estudio de las capacidades de las SDR comerciales:

Modelo | FPGA | Programmable Logic Gates
USRP B200mini | Xilinx Spartan-6 XC6SLX75 | 75k
LimeSDR | Altera Cyclone IV EP4CE40F23 | 40k
BladeRF xA4 | Altera Cyclone V | 49K
Tabla 4: Estimación de recursos FPGA

Temperatura de operación: Comercial industrial (0º a 85 ºC), extended (0º a 100 ºC), industrial (-40º a 100 ºC) o expanded (-40º a 125 ºC)

Cantidad de I/0: la cantidad de pines debe ser suficiente para poder interconectar todos los módulos.

Grado de velocidad: Representa el tiempo que tardan los circuitos lógicos en atravesar el dispositivo, es decir determina la frecuencia máxima que soporta la FPGA. Se seleccionó el grado -1 (gama baja, frecuencia máxima = 464 MHz), ya que a medida que se mejora este grado de velocidad el precio de la FPGA aumenta.

Pitch: El mismo determina la separación entre cada bola del encapsulado BGA, esta puede ser de; 1mm, 0.8mm y 0.5mm. Se decidió utilizar un pitch de 1.mm para tener más espacio entra las vías a la hora de realizar el ruteo del PCB y además es más sencilla de soldar en comparación a las de pitch más chico.

### 2. Diseño

Teniendo en cuenta todas estas características se decidió utilizar el modelo de FPGA XC7A100T-1FTG256C.La siguiente figura muestra el significado de cada letra y numero del modelo seleccionado.

## Xilinx XC7A100T-1FTG256C

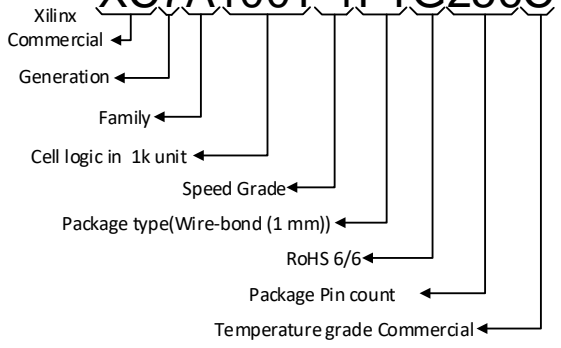
[picture p12: figure]
Commercial; Generation; Family; Cell logic in 1k unit; Speed Grade; Package type(Wire-bond (1 mm)); RoHS 6/6; Package Pin count; Temperature grade Commercial

Figura 16: Modelo de FPGA seleccionado

2.2.4.2 Pin Out y encapsulado

El modelo de FPGA seleccionado está compuesto por un encapsulado Wire-Bond Fine-Pitch thin BGA de alta densidad con un total de 256 pines, que se encuentran distribuidos en forma de rejilla cuadrada de 16 filas por 16 columnas. El pitch o separación entre los pines es de 1mm. Este tipo de encapsulado es apropiado cuando se dispone de un gran número de I/O, en este caso el modelo dispone de un total de 170. El total de pines de I/O está distribuido en bancos. La figura 8 muestra el mapa de pines de I/0 de la FPGA. Se pueden distinguir los diferentes bancos por su color y por su numeración.

### 2. Diseño

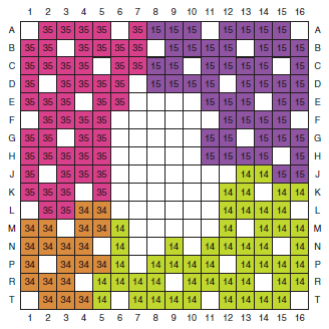
[picture p13: figure]

Figura 17: Pin Out I/O FPGA

2.2.4.3 Función

Procesamiento de aplicación.

Esta tarea se refiere a la implementación de la lógica y máquinas de estados necesarios que definen la o las aplicaciones de la SDR. Definiéndose como la unidad central de control que implementa los modos de operación de la SDR. A través de esta unidad, se brindaran las interfaces lógicas para el control, configuración y monitoreo externo de la SDR.

Procesamiento de señal

Compuesto principalmente por una FPGA con una gran capacidad para el procesamiento digital de señales, memoria rápida y de gran volumen, gran cantidad de pines, interfaces de alta velocidad y capacidad para ser reprogramada.
Estará orientado, como su nombre lo indica, al procesamiento digital que demande la aplicación que quiera embeberse en la SDR. Algunas de estas aplicaciones pueden ser:
- Procesamiento en banda base
- Manejo de datos
- Encriptar/Des encriptar
- Aplicar diferentes tipos de modulación a los datos I/Q

### 2. Diseño

2.2.4.4 Configuración FPGA

Las FPGA son configuradas cargando las aplicaciones en su memoria interna. En este caso la configuración de esta memoria puede ser cargada por medio de otro procesador (ubicado en el controlador del USB 3.0) de forma serial. Este modo de configuración se lo conoce como “Slave-serial configuration mode”.

También se dispone de un JTAG, el cual es una interfaz de 4 pines usada frecuentemente con finalidades de testeo y depuración. La conexión JTAG no sólo sirve para configurar la FPGA sino que es totalmente compatible con el protocolo de testeo de dispositivos definido en el estándar IEEE 1149.1.

Las configuraciones de las FPGA de Xilinx son almacenadas en “CMOS configuration latches “(CCLs).Por lo tanto deben ser reconfigurada después de cada apagado.

2.2.4.5 Alimentación FPGA

Para determinar la alimentación necesaria de la FPGA artix-7 se utilizó la herramienta “Xilinx Power Estimator”, de estimación de consumo que provee Xilinx (para más información ir al Anexo A-Alimentación). Otorgando como datos de salida la corriente necesaria en cada banco para su correcto funcionamiento.

También se debe tener en cuenta la secuencia de encendido recomendada:

VCCINT-> VCCBRAM ->VCCAUX ->VCCO

2.2.5 Alimentación SDR

La función que se define en este módulo es la de proveer las tensiones secundarias que serán utilizadas por los demás módulos de la SDR.
Dado que el principal elemento de la SDR, el transceiver AD9364, recomienda utilizar convertidores de DC a DC de Analog Devices, se decidió que la mayoría de los integrados de alimentación sean de la misma empresa. Permitiendo así una futura simulación casi completa de la sección de alimentación.
Para alimentar la mayor parte del sistema se utilizó una de las soluciones que ofrece Analog Devices para la alimentación de FPGAs. Dicha solución utiliza el integrado ADP5054, el cual combina 4 buck regulators en un solo integrado.

Además se estimaron los consumos de los principales integrados, como se indica en la siguiente tabla:

### 2. Diseño

Tabla 5: Estimación del consumo por etapa

En donde:

- La estimación de consumo de energía de la FPGA se realizó utilizando la herramienta XPE de Xilinx. Para esta estimación se consideraron casos extremos, como el 100% del uso de los recursos y alta tasa de cambio en las señales (Toggle rate).Para más información ir al Anexo A.
- Para la estimación del transceiver se utilizó el peor caso de consumo provisto por la hoja de datos del mismo. En este caso la trasferencia de datos entre el BBP y el transceiver se realizan con un clock de 30.72 MHz (1.8V@ 8mA).La transmisión/ recepción es en modo FDD a 5 Ghz, con un ancho de banda de 5 MHz y 7 dBm de potencia (1.3V@550 mA).
- Para el USB3.0 se utilizó una tabla de consumos típicos que provee cypress (ver referencia [2]).
- Para obtener el consumo de la memoria DDR3 se utilizó una hoja de cálculo que provee micrón y se tomaron las corrientes máximas de la misma (ver referencia [3]).

La siguiente tabla indica la corriente necesaria por cada tensión:

Tension | Corriente
1.0 V | 2.919 A
1.8 V | 0.2885 A
1.35 V | 0.734 A
1.3 V | 0.55 A
1.2 V | 0.127 A
Tabla 6: Corriente necesaria por tensión

A partir de todas las estimaciones y consideraciones enunciadas anteriormente se diseñó la siguiente distribución de tensiones:

Integrado | Tension | Corriente | Potencia
FPGA | 1.0 V | 2.919 A | 2.919 W
| 1.8 V | 0.274 A | 0.493 W
| 1.35 V | 0.125 A | 0.168 W
Transceiver | 1.8 V | 0.008 A | 0.014 W
| 1.3 V | 0.55 A | 0.715 W
USB 3.0 | 1.2 V | 0.127 A | 0.1524 W
| 1.8 V | 0.065 A | 0.117 W
DDR3 | 1.35 V | 0.609 A | 0.822 W

### 2. Diseño

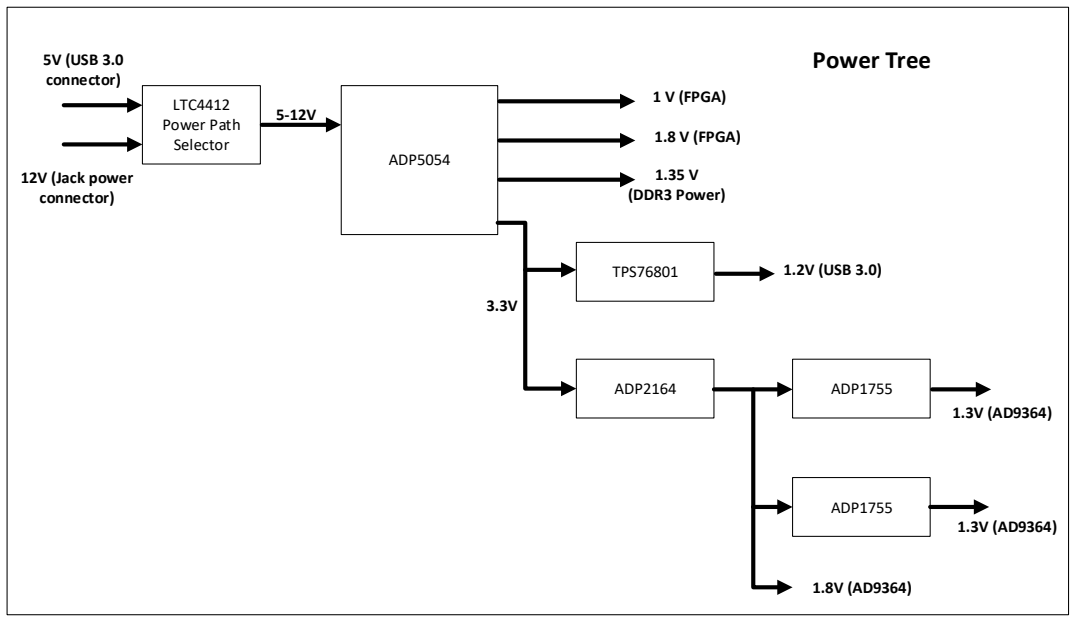
[picture p14: figure]
LTC4412 Power Path Selector; ADP5054; TPS76801; ADP2164; ADP1755; 5V (USB 3.0 connector); 12V (Jack power connector); 1 V (FPGA); 1.8 V (FPGA); 1.35 V (DDR3 Power); 1.2V (USB 3.0); Power Tree

Figura 18: Diagrama distribución de power

Como se puede apreciar en el diagrama, la SDR puede ser alimentada tanto por USB 3.0 como por medio un jack externo. La selección entre ambas tensiones es realizada automáticamente por el selector de camino LTC4412, el cual prioriza el de mayor tensión. Ante la presencia de ambas conexiones el sistema será alimentado por el Jack.

La potencia total del sistema, con consideraciones extremas, es de 5.4W con lo cual es posible que la potencia entregada por el USB3.0 (5W) no sea suficiente. Este posible problema con la potencia necesaria y la posibilidad de funcionamiento por medio de un puerto USB 2.0, son los principales motivos por los cuales se agregó la opción de alimentación por Jack.

2.2.6 GPIO y Leds

Para aprovechar los pines sin uso en la FPGA se utilizaron los mismos para armar un GPIO como muestra la siguiente figura:

### 2. Diseño

{

{1.8V 6 {

signals

GND

Figura 19: Pines de propósito general

Además también se agregaron 8 leds a la placa, los cuales van a ser de futura ayuda a la hora del debugging, para poder visualizar cualquier registró en forma de byte.

2.2.7 SDR Características

Resumiendo la SDR LAPAC tendrá las siguientes características:

Capacidades RF:

- 1xTX & 1xRX Half o Full Duplex
- 70 MHz a 6 GHz de rango de frecuencia
- Hasta 56 MHz de ancho de banda

Interface y alimentación:

- USB 3.0
- Alimentación por USB o Jack

Hardware:

- FPGA Artix-7 XC7A100T
- DDR3 Memory 256 MB
- GPIO
- JTAG & USB boot

Que tan lejos?:

Por lo general tanto en esta SDR como en la mayoría, no es posible determinar que tal lejos puede transmitir. Ya que la distancia depende de muchos factores:

### 2. Diseño

carrier frequency, tipo de modulación, ancho de banda, antenas, medio ambiente local (topografía, vegetación, clima), etc.

Por ejemplo la siguiente figura muestra como varia la potencia de salida del transceiver AD9364 en función de la frecuencia y la temperatura.

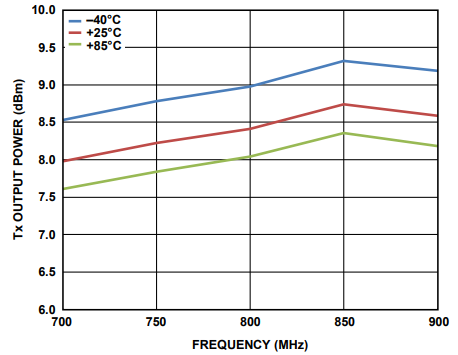
[picture p15: figure]

Figura 20: Potencia salida transceiver

Faltaría comentar algo sobre rango de frecuencias, como por ejemplo:

3. Implementación del Diseño

## Capítulo 3

## 3. Implementación del Diseño

3.1 Diseño herramienta CAD

La herramienta imprescindible para llevar a cabo un buen diseño electrónico es un programa informático CAD. Existen muchas alternativas a gusto del diseñador, aunque las mejores opciones son alguna de las desarrolladas por las principales compañías que llevan desarrollando este tipo de software: Cadence, Altium Designer, Eagle o MentorGraphics están entre las más usadas.

En este proyecto se decidió usar Altium Designer debido a previo conocimiento de esta herramienta.

3.1.1 Esquemático

Este programa permite realizar el diseño del esquemático en forma jerárquica, pudiendo dividir el proyecto en módulos funcionales. Cada uno de estos módulos será desarrollado en sheets (con sus correspondientes circuitos), logrando un mejor seguimiento, orden según funcionalidad y facilidad a la hora de diseñar.

Las conexiones entre estos sheets son indicadas en un primer archivo en el cual se muestran todas las conexiones entre las diferentes sheets. Estas conexiones se realizan por medio de puertos los cuales pueden ser unidireccionales o bidireccionales.

Por otra parte, tanto a los componentes como a las conexiones se les pueden asignar diferentes clases o directivas, las cuales pueden estar sujetas a determinadas reglas de diseño que el programa tendrá en cuenta en la etapa del ruteo del PCB y serán aplicadas automáticamente. Por ejemplo, se pueden seleccionar un conjunto de líneas de datos y asignarles una netclass para luego aplicarle reglas de ruteo a la misma (impedancia, separación entre líneas, largo máximo, .etc.)

3. Implementación del Diseño

3.1.2 Componentes (falta completar)

Para una mejor organización del proyecto a cada componente se le agrego información extra en sus propiedades dentro del esquemático. La siguiente figura muestras dichas propiedades:

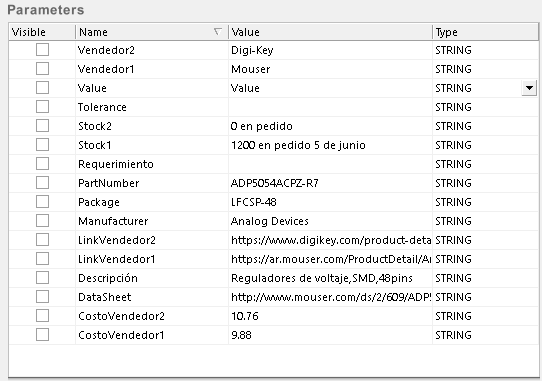
[picture p16: figure]

Figura 21: Información componentes del esquemático

Además este agregado de información ayuda a la futura construcción de la lista de materiales (BOM), el pedido y compra de los diferentes componentes.

Hablar sobre la unificación de librerías de todos los componentes en una sola

3.2 Conexiones

Las conexiones de cada dispositivo fue realizada según la indicación de diferentes data sheets y guías de diseño, las cuales se encuentran en el anexo [Conexiones componentes]

Además se tuvo en cuenta los “absolute máximum ratings” de todos los dispositivos, para no superar ninguna tensión máxima en los pines de cada integrado. Por ejemplo en un enabel del ADP5054 se agregó un divisor resistivo en su entrada para no superar su tensión máxima de entrada (+6.5V) cuando es alimentado por medio del Jack.

En las siguientes secciones se comentaran algunas otras particularidades que se tuvieron en cuenta a la hora de realizar las conexiones.

3. Implementación del Diseño

3.2.1 FPGA

3.2.1.1 Bancos I/O

Para realizar las conexiones entre los diferentes bancos del FPGA y los componentes principales (transceiver, controlador USB 3.0 y memoria), se tuvo en cuenta los niveles de tensión e impedancia en cada una de las interfaces. En la siguiente figura se indica la asignación de pines, tensión e impedancia de las diferentes conexiones:

BANK 34 20 I/O VCCO = 1.8V Z0=50 ohms | Bank 35 VCC0=1.35V { Z0=50 ohms 50 I/0 VCC0=1.8V Z0=50 ohms
BANK 14 50 I/O VCCO=1.8V Z0=50 ohms | BANK 15 50 I/O

DDR3
Memory

Tranceiver
AD9364

USB 3.0
Interface,
LEDS,
GPIO

Figura 22: Interface de los bancos de la FPGA

Además cada uno de estos bancos tiene pines que sirven para determinadas funciones, como por ejemplo los pines MRCC. En estos pines se conectaran la mayoría de las señales de clock, ya que por medio de estos pines se puede distribuir dichas señales a múltiples regiones de clock dentro de la FPGA.

La FPGA también tiene un banco 0, este es un banco especifico que contiene los pines necesarios para configuración, programación y reseteo. Además este banco puede ser alimentado con diferentes tensiones, en este caso 1.8V para tener los mismo niveles de tensión que su programador, el controlador de USB 3.0 (el JTAG tendrá la misma tensión también).

3. Implementación del Diseño

3.2.1.2 Booting

La configuración de la FPGA se realiza por medio controlador de USB 3.0, lo cual elimina la necesidad de una memoria para programar la FPGA. Actuando como master este controlador configura la FPGA en modo Slave Serial.

Para poder realizar esta configuración, es necesario realizar las siguientes conexiones entre el controlador de USB 3.0 y la FPGA:

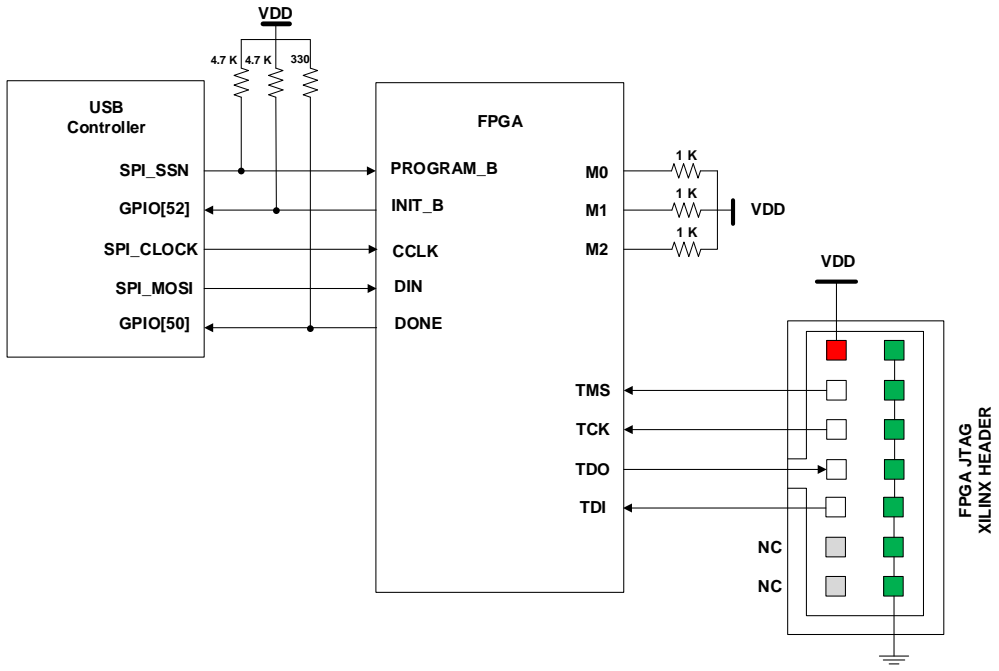
[picture p17: figure]
USB; Controller; FPGA; SPI_SSN; GPIO[52]; SPI_CLOCK; SPI_MOSI; GPIO[50]; INIT_B; PROGRAM_B; CCLK; DIN; DONE; VDD; FPGA JTAG XILINX HEADER; TMS; TCK; TDO; TDI

Figura 23: Diagrama en bloques configuración FPGA
En donde:
- Program_B: Cuando esta LOW por 500 ns o más, fuerza a la FPGA a reiniciar el proceso de configuración, limpiando la memoria de configuración.
- INIT_B: Low después de power on reset (POR) o cuando la FPGA está limpiando la memoria de configuración.
- CCLK: Clock de configuración.
- DIN: Entrada de datos serial para la configuración de la FPGA. Estos datos son capturados en los flancos ascendentes de CCLK
- DONE: Low durante la configuración y HIGH cuando la configuración es terminada exitosamente.
- M [2:0]: Determinan la forma de configuración que tendrá la FPGA, dependiendo de los pull-down / pull-up que se conecten a estos pines.

Tablita de los diferentes valores de M[2:0] y algo sobre el JTAG

3. Implementación del Diseño

Tabla 7: Selección del modo de booting FPGA

El controlador de USB comienza a configurar la FPGA pulsando PROGRAM_B (t1) y monitoreando el pin INIT_B. Cuando el pin INIT_B está en HIGH (t2) la FPGA está lista para recibir los datos de configuración. El master empieza a suministrar los datos de configuración y la señal de clock hasta (t3):

- Que el pin DONE este en HIGH indicando una configuración exitosa (t4).
- Que el pin INIT_B este en LOW indicando un error en la configuración.

La siguiente figura muestra un diagrama de tiempo de las señales involucradas en la configuración de la FPGA.

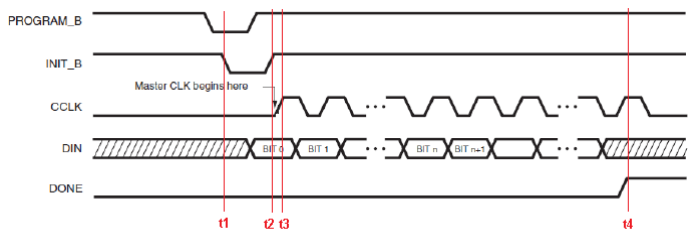
[picture p18: figure]

Figura 24: Diagrama de tiempos, configuración FPGA

3.2.2 Power

Para realizar las conexiones en la sección de alimentación se tuvieron en cuenta las siguientes consideraciones:

- Se agregaron headers para separar por la alimentación por etapas.
- Se realizaron cálculos de para obtener la tensión de salida de algunos reguladores.
Configuration Mode | M [2:0] | Bus Width | CCLK Direction
Master Serial | 000 | x1 | Output
Master SPI | 001 | x1,x2,x4 | Output
Master BPI | 010 | x8,x16 | Output
Master SelectMap | 100 | x8,x16 | Output
JTAG | 101 | x1 | Not Applicable
Slave SelectMAP | 110 | x8,x16,x32 | Input
Slave Serial | 111 | x1 | Input

3. Implementación del Diseño
- Se realizaron simulación del funcionamiento de la mayoría de los reguladores y el selector de camino de alimentación.
- Utilización de la aplicación “ADP505x BuckDesigner” tanto para las conexiones como para la selección de los componentes del regulador ADP5054.

La mayoría de estos ítems están detallados en el Anexo A- Alimentación.

3.2.3 Transceiver AD9364

Para realizar la mayoría de las conexiones del transceiver se utilizó: la placa de evaluación del AD9364 “AD-FMCOMMS4-EBZ” (por recomendación del fabricante) y la guía de diseño de hardware que provee el fabricante.

3.2.4 USB 3.0

Para realizar la mayoría de las conexiones del controlador de USB 3.0 se utilizó: la placa de desarrollo “SUPERSPEED EXPLORER KIT” (por recomendación del fabricante) y la guía de diseño de hardware que provee el fabricante.

3.3 PCB información básica

3.3.1 PCB definición

Un PCB es usado para crear conexiones entre componentes, tales como resistencias, circuitos integrados y conectores. Los mismos están compuesto de una capa de dieléctrico y delgadas hojas de cobre añadidas en ambos lados de una placa. Esta placa (dieléctrico) puede ser flexibles o rígidas.

Un PCB multicapa (una placa con dos o más capas de cobre) puede estar compuesto por:

- Core
- Prepreg
- Láminas de Cobre

El Prepreg es una placa dieléctrica con pegamento en ambas caras.

El Core es una placa de material dieléctrico con una lámina de cobre en cada cara.

3. Implementación del Diseño

El laminado de cobre (copper foil), es una delgada hoja de cobre la cual se coloca en/o entre el material de prepreg y es unido por el adhesivo que forma parte del prepreg. Los grosores más comunes de estas láminas son los siguientes:

- 1/2 oz (0.0007”[.01778mm])
- 1 oz (.0014”[0.03556mm])
- 2 oz(.0028”[0.07112mm])

La siguiente figura muestra cómo puede estar compuesto un PCB multicapa

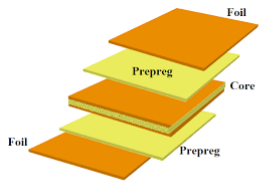
[picture p19: figure]

Figura 25: Capas de un PCB multicapa

3.3.2 Mascara de soldadura (Solder Mask)

La máscara de soldadura es un material que se utiliza para proteger a la placa de:

- Los alrededores del ambiente
- Aislar eléctricamente la misma
- Proteger los puntos de soldadura

3.3.3 Mascara de Leyendas (Silk Mask)

La silk mask es una capa de pintura que se utiliza para indicar referencias, como por ejemplo: polaridad, posición y datos de los componentes.Por lo general se utiliza el color blanco, amarillo, negro y rojo.

3.3.4 Pistas

3. Implementación del Diseño

La función de estas es conectar eléctricamente un punto con otro. Estas son formadas removiendo el cobre no necesario y dejando solamente los trazos y pads requeridos.

Las características que definen a una pista son el ancho, el largo y el grosor de la misma. Con estas características se pueden determinar la corriente que puede circular por la misma. Además el grosor y el ancho son parámetros que determinara la impedancia de la misma (también depende del stack-up y las constantes dieléctricas como se mostrara más adelante).

3.3.5 Pads

El pad es una región de cobre encargada de hacer contacto entre el PCB y el componente

3.3.6 Perforación Platinada (Plated Hole)

Una perforación platinada, como se muestra en la siguiente figura, consiste en un pad con una perforación en el centro. Las paredes de esta perforación son platinadas con cobre. El platinado del agujero comprende desde la superficie del pad y continúa a través de la perforación hasta llegar al otro extremo de la placa.

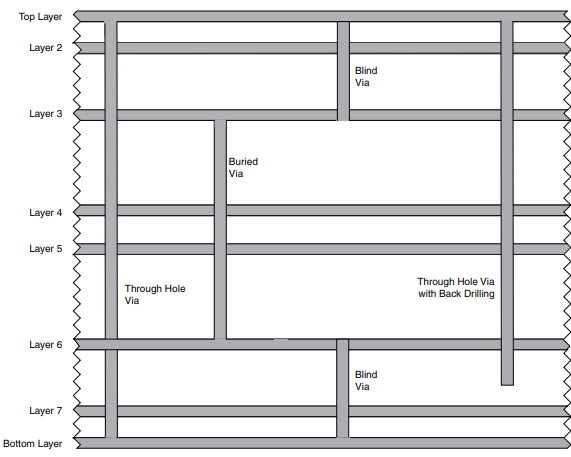
[picture p20: figure]

Figura 26: Tipo de vías en un PCB

Este tipo de agujeros son las vías más comunes ya que son simples de fabricar y tienen un costo bajo en comparación con las “Blind Via” o “Buried Via”. Son utilizadas para conectar las diferentes capas en un PCB multicapa.

3. Implementación del Diseño

3.4 Capacidades del fabricante PCB

El diseño del PCB se adecuo a las capacidades de fabricación de la compañía “PCB Prototype”. Estas capacidades establecen algunos requerimientos principales para el diseño PCB:

- Mínimo ancho de pista y espaciado

Estos requerimientos estipulan la distancia mínima entre dos pistas y el ancho de las mismas. Dicha distancia mínima es de 3 mil (0.076 mm) para ambos requerimientos.

Distancia min.

Min ancho
de pista

Figura 27: Restricción distancia mínima en PCB

- Mínimo tamaño de agujero y annular ring

El mínimo tamaño de agujero es de 0.15 mm, mientras que el annular ring es de 0.1 mm.

Min Hole
Size

Min annular
ring

Figura 28: Restricciones tamaño agujero en PCB

Estos requerimientos son esenciales para poder determinar si va ser posible realizar el “Fanout” (llevar cada uno de pines de un componente BGA hacia fuera del integrado) de los componentes BGA. Ya que a partir de estos

3. Implementación del Diseño

requerimientos se podrá determinar si el espacio entre las vías es suficiente para que pasen pistas a través del mismo.

La siguiente figura muestra cómo queda restringido el espacio entre los pad de los componentes BGA con un pitch de 0.8mm para el ruteo de las señales:

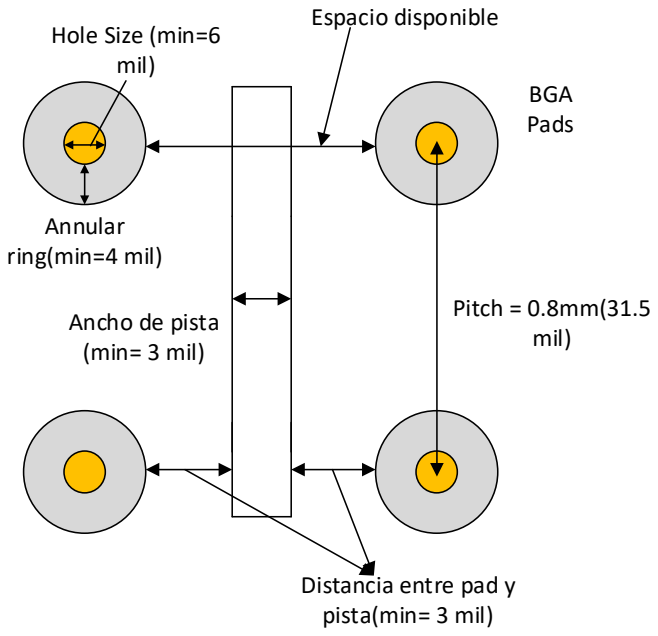
[picture p21: figure]
Pitch = 0.8mm(31.5 mil); Distancia entre pad y pista(min= 3 mil); Ancho de pista (min= 3 mil); BGA Pads; Hole Size (min=6 mil); Annular ring(min=4 mil); Espacio disponible

Figura 29: Espacio disponible en componentes BGA

En la siguiente figura se puede apreciar una parte del ruteo de uno de los componentes BGA con pitch 0.8mm (USB 3.0 controller):

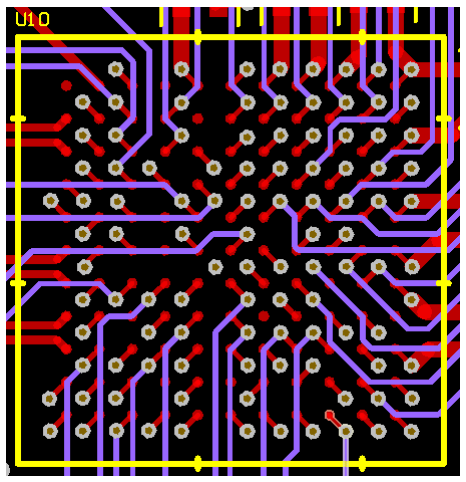
[picture p22: figure]

Figura 30: Ejemplo de ruteo, componente BGA

Para más información sobre todos las capacidades del fabricante ir al anexo..

3. Implementación del Diseño

3.5 Distribución de componentes y características físicas

Antes de comenzar con el ruteo de la placa, hay que estimar si las dimensiones de la misma son suficiente para dar cabida a todos los componentes y permitir su interconexión. Así como mantener a cierta distancia aquellos que tiendan a generar más calor.

La Figura Nº 30 muestra una de las capas mecánicas donde se puede distinguir la colocación de los diferentes componentes. La posición ideal para la FPGA es en el centro, ya que las líneas que salen de ella se distribuyen radialmente hacia los componentes que la rodean

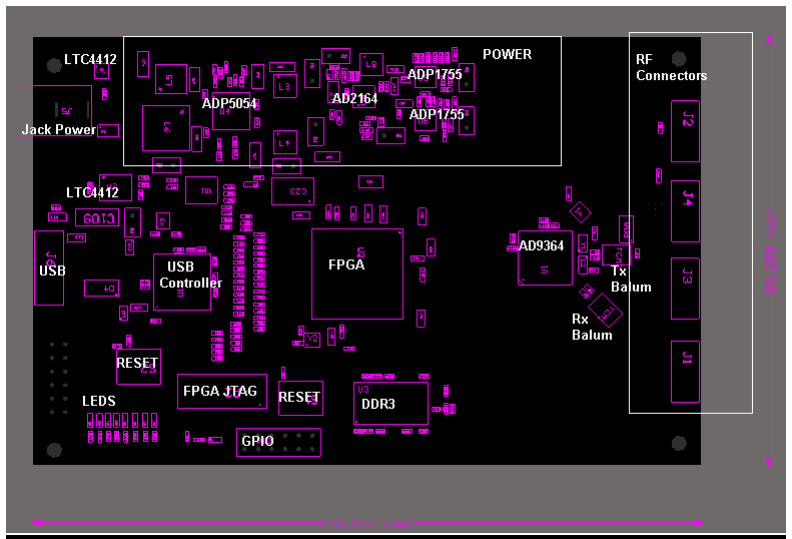
[picture p23: figure]

Figura 31: Distribución de los componentes en la placa

En el extremo izquierdo de la placa se encuentra la conexión USB y el conector Jack para alimentación externa. Mientras que en el extremo derecho se encuentran las conexiones de RF para transmisión y recepción.

Las interfaces de usuario se han colocado en lugares accesibles para tener buena operatividad y además lejos de la FPGA ya que las líneas no se consideran críticas.

Las dimensiones de la placa son de aproximadamente 12.5x8 centímetros y tiene un grosor de 1.6mm. Además tiene 4 agujeros de montaje los cuales están conectados a GND.

3. Implementación del Diseño

3.6 Stackup

Como se mencionó en la sección 3.3.1, la estructura de una PCB está constituida por un conjunto de láminas de cobre apiladas y separadas por un material aislante. La manera en la que se distribuyen estas capas, junto con sus respectivos grosores y materiales utilizados se conoce como el stack-up de la placa.

Cuando se va a diseñar una placa con varias capas y con líneas de alta velocidad el primer paso a dar es definir el stack-up o una buena aproximación de él. Para ello se deben tener en cuenta factores como presupuesto, integridad de la señal, impedancias y distribución de la energía.

Para definir el stackup se tuvo en cuenta:

- Por recomendación del transceiver AD9364 la segunda capa y la ante ultima deben ser GND (plano de cobre sin ninguna división) .Esto es crucial para mantener integridad de señal de RF y performance del AD9364.Ademas también estipula que las señales digitales deben ser ruteadas por las capas internas.
- Debido a la cantidad de tensiones diferentes, un solo plano no basta para distribuir todas las tensiones a los módulos pertinentes, por lo que se decidió utilizar 2 planos de tensión.
- La cantidad de capas de señal deben ser las suficientes para poder realizar el ruteo de todos los componentes .En este caso el componente con mayor densidad de señales es la FPGA, por lo tanto esta determinara la cantidad de capas necesarias para el ruteo de todas las señales.
Para determinar la cantidad de capas necesarias Xilinx provee una fórmula para estimar la misma:

Layers =

Signals
Routing Cℎannels × Routes per Cℎannel

En donde:

Routing Channels: son el número de caminos de salida disponibles hacia fuera del BGA. Es decir el número de pines de un lado del BGA menos uno, cuatro veces (debido a los cuatro lados del componente). En este caso el encapsulado es de 16x16, obteniendo un total de 60 Routing Channels (15x4).

Router per Channel: Puede ser uno o dos dependiendo si uno o dos señales son ruteadas entre los pads del BGA. En este caso solo se realizara el ruteo de una señal entre los pads.

3. Implementación del Diseño

Señales: La siguiente tabla indica la cantidad de señales que corresponden a la FPGA:

Sección | Nº Señales
FPGA-USB | 53
FPGA-AD9364 | 48
FPGA-DDR3 | 46
FPGA-GPIO | 16
FPGA Misc. | 13
Total | 176

Tabla 8: Cantidad de señales por sección

Layers =

176
60 × 1

= 3 (redondeado)

Debido a que el número de capas de un PCB deben ser par se decidió utilizar 4 capaz de señales.

- Las impedancias necesarias para cada sección:

Tabla 9: Impedancias de cada sección

Sección | Tipo | Impedancia | Layer | Medidas
AD9364 | Diferencial | 100 Ω | Top | W=0.229mm,S=0.152mm
| | | Bot | W=0.229mm,S=0.152mm
| Individual | 50 Ω | Top | W=0.236mm
| | | Bot | W=0.128mm
| | | Signal 1 | W=0.14mm
| | | Signal2 | W=0.236mm
USB 3.0 | Diferencial | 90 Ω | Top | W=0.203mm, S=0.152mm
| Individual | 50 Ω | Top | W=0.236mm
| | | Bot | W=0.128mm
| | | Signal 1 | W=0.14mm
| | | Signal 2 | W=0.236mm
FPGA | Diferencial | 100 Ω | Top | W=0.229mm,S=0.152mm
| | | Bot | W=0.229mm,S=0.152mm
| Individual | 50 Ω | Top | W=0.236mm
| | | Bot | W=0.128mm
| | | Signal 1 | W=0.14mm
| | | Signal 2 | W=0.236mm
Memory | Diferencial | 100 Ω | Top | W=0.229mm,S=0.152mm
| | | Bot | W=0.229mm,S=0.152mm
| Individual | 50 Ω | Top | W=0.236mm
| | | Bot | W=0.128mm
| | | Signal 1 | W=0.14mm
| | | Signal 2 | W=0.236mm

3. Implementación del Diseño

Teniendo en cuanta toda las cuestiones mencionadas anterior mente se diseñó el siguiente stackup:

TOP (1 OZ)

GND(1 OZ)

Signal 1(1 OZ)

Power 1(1 OZ)

Power 2(1 OZ)

Signal 2(1 OZ)

GND(1 OZ)

BOT(1 OZ)

### 14 mils

### 6.7 mils

### 6.7 mils

### 5 mils

### 6.7 mils

### 6.7 mils

### 6 mils

Er=3.6

Er=3.6

Er=3.6

Er=3.6

Er=3.6

Er=3.6

Er=3.6

Espesor total = 1.62 mm

{

Stackup | Impedancias

50
100 Diff

### 90 Diff

{
50

100 Diff

{50

{⁵⁰

FR-4

FR-4

FR-4

FR-4

FR-4

FR-4

FR-4

Prepreg

Prepreg

Prepreg

Prepreg

Core

Core

Core

Figura 32: Stack up del PCB

Para obtener la constante dieléctrica del material se contactó vía mail con el fabricante del PCB “PCB Prototypes”, los cuales suministraron la información necesaria para realizar el stackup.

3.7 Líneas de transmisión

Cuando las señales son del orden de las decenas de los MHz estas pueden ser tratadas como señales de alta velocidad.

Una señal puede ser considerad a de alta velocidad cuando la relación entre su frecuencia o longitud de onda y la distancia que esta señal recorre son de magnitudes similares. Cuando en una pista de cobre o cable por donde viaje una señal si cumple con dicha relación se consideran como una línea de transmisión.

3. Implementación del Diseño

3.8 Impedancia característica, reflexión y terminación

Una de las propiedades de una línea de transmisión es su impedancia característica, Z0. Cuando se diseña una línea de transmisión entre un emisor y un receptor, las impedancias: de salida del receptor, de la línea y de entrada del receptor deben estar adaptadas. Si no se ajusta bien esta adaptación de impedancias se producen reflexiones y oscilaciones dentro de la misma línea provocando una degradación de la señal o incluso el fallo completo de la comunicación.

La impedancia característica es una propiedad de la línea de transmisión que depende únicamente de su geometría (alto, ancho y forma) y de las propiedades del material dieléctrico que la componen (aire, FR4, etc.) siendo independiente de la longitud de la línea. Por tanto es importante que la línea de transmisión preserve su forma y geometría durante todo el recorrido de la señal para mantener una continuidad en su impedancia característica.

En un PCB los parámetros de fabricación como el grosor del laminado de cobre, el tamaño del material dieléctrico (distancia al próximo plano solido) y constante dieléctrica, son los parámetros que van a permitir calcular la geometría de la línea para conseguir la impedancia característica deseada.

A continuación se muestran los dos casos que podemos encontrar en el diseño de esta SDR.

Figura 33: Microstrip

Fórmula utilizada por Altium Designer para el cálculo de impedancia en Microstrip:

Z0 =

87
√er + 1.41

× ln(

5.98 × H
0.8 × W + T

)

En donde:

H = Distancia entre pista y plano

W = Ancho de pista

3. Implementación del Diseño

T= Grosor de pista

Er= Constante dieléctrica del material dieléctrico.

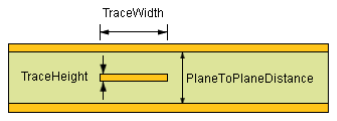
[picture p24: figure]

Figura 34: Strip line

Fórmula utilizada por Altium Designer para el cálculo de impedancia en Stripline:

Z0 =

60
√er

× ln(

1.9 × B
0.8 × W + T

)

En donde:

B = Distancia entre planos

3.9 Líneas diferenciales

Las señales que se transmiten de modo diferencial viajan a través de dos líneas acopladas, presentando la misma magnitud en ambas y signo opuesto.

Una de las principales ventajas de las señales diferenciales es su superior inmunidad al ruido frente a las señales individuales. Cuando una interferencia electromagnética afecta a la señal diferencial, afecta a las dos líneas por igual y, puesto que en el receptor se mide la diferencia entre ambas, se suprime el efecto del ruido y se puede recuperar fácilmente la señal original

3. Implementación del Diseño

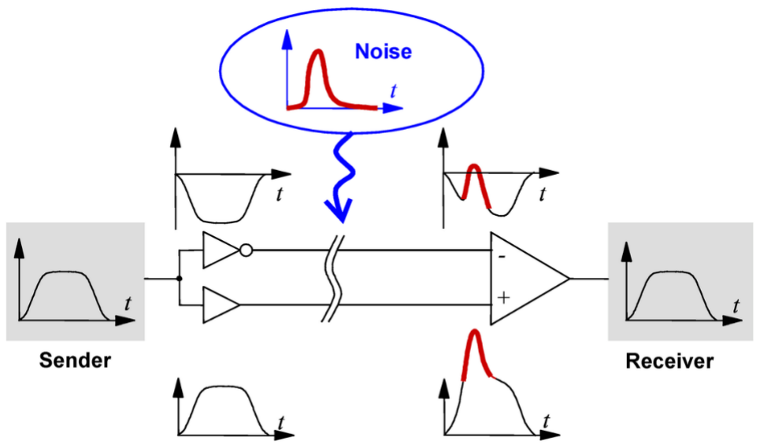
[picture p25: figure]

Figura 35: Propiedad de las líneas diferenciales

En la SDR la mayoría de las señales de alta velocidad se transmiten en modo diferencial. Al igual que las líneas individuales, las líneas diferenciales también presentan una impedancia característica, Z0. En este caso también se calcula en función de la geometría del par diferencial y de las propiedades del stackup, interviniendo además la separación entre las líneas como muestra la siguiente figura:

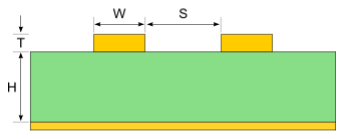
[picture p26: figure]

Figura 36: Líneas diferenciales en PCB

La herramienta Altium Designer no hace cálculos de impedancias diferenciales, por lo que se utilizó un programa realizar dicho calculo. Los cálculos realizados con este programa auxiliar se encuentran en el anexo [tatatata]

3.10 Ajuste de longitudes

Cuando varias señales de alta velocidad pertenecen a un mismo grupo o bus de datos que funcionan de forma síncrona, es importante que todas tengan la misma distancia eléctrica, es decir, que todas las señales eléctricas lleguen

3. Implementación del Diseño

dentro de un pequeño intervalo de tiempo que garantice el correcto funcionamiento circuito (lo ideal sería que todas lleguen al mismo tiempo).

A menudo, estas señales se encuentran, en línea recta, a diferentes distancias cada una de su destino. Por ello es preciso forzar a que las líneas más cortas realicen un recorrido extra para igualar al recorrido de la línea más larga del grupo.

Este criterio se tuvo en cuenta en varias secciones del diseño de la SDR:

- Interface GPIF II entre el controlador de USB3.0 y la FPGA
- Líneas de dato, addres y control en la memoria DD3
- Líneas de datos y clocks entre la FPGA y el transceiver AD9364

La siguiente figura muestra como mediante la utilización de serpentinas o ruteo en forma de laberinto se equiparan los largos de las líneas de interface entre la memoria DDR3 y la FPGA.

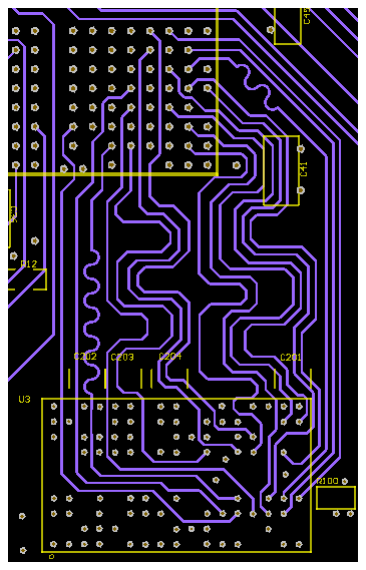
[picture p27: figure]
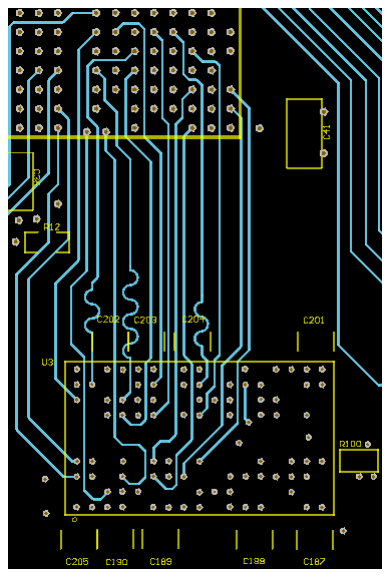
[picture p28: figure]

Figura 37: Ejemplo ruteo memoria DDR3

Tabla 10: Longitud de líneas en la interfaz DDR3

Nombre | Largo (mil) | Nombre | Largo (mil)
DDR3_DQ0 | 894,669 | DDR3_A1 | 1310,066
DDR3_DQ15 | 898,977 | DDR3_A0 | 1312,581
DDR3_DQ8 | 899,062 | DDR3_A6 | 1318,087
DDR3_DQ6 | 901,442 | DDR3_A7 | 1320,843
DDR3_DQ5 | 901,852 | DDR3_A10 | 1321,725
DDR3_DQ9 | 902,812 | DDR3_A9 | 1321,832
DDR3_DQ1 | 903,108 | DDR3_A2 | 1323,624
DDR3_DQ10 | 903,831 | DDR3_A11 | 1323,735
DDR3_DQ13 | 904,941 | DDR3_A12 | 1324,045
DDR3_DQ2 | 907,448 | DDR3_A5 | 1333,306
DDR3_DQ4 | 908,487 | DDR3_A4 | 1343,608
DDR3_DQ11 | 909,391 | DDR3_A8 | 1344,844
DDR3_DQ3 | 913,043 | DDR3_A13 | 1353,309
DDR3_DQ14 | 916,676 | DDR3_A3 | 1361,219
DDR3_DQ12 | 919,22
DDR3_DQ7 | 939,541

3. Implementación del Diseño

Comentar los requerimientos por parte del fabricante de la memoria Micro en cuanto long etc

3.11 Algunas Consideraciones

3.11.1 FPGA

- Todas las pistas tienen impedancia de 50 Ω.
- El plano de power de mayor necesidad se encuentra más cerca de la FPGA (1V FPGA)
- Cristal lo más cercano a la FPGA posible

3.11.2 Power

- Se calculó de tamaño de vías para determinar si pueden suministrar la corriente necesaria.
- Uso de vías de escape térmico

3.11.3 USB 3.0

- Ajuste de largo de pista utilizando la herramienta xSignals.
- Utilización de protección ESD
- Calculo impedancia Diferenciales

3.11.4 AD9364

- Criterio de cero diferencia de longitud entre las líneas de interface digital con la FPGA.
- Coplanar Waveguide y ajuste de impedancia 50 Ω para lograr un ancho similar al conector de RF y no tener desadaptación de impedancia
- Conexiones de Tx y Rx
- Pista en el top para posible shielding

3.12 Planos de alimentación y tierra

Como se ha explicado en la Sección 3.6, de las 8 capas con que cuenta el PCB, 2 son planos de tierra y 2 son para planos de alimentación. Las siguientes figuras mostraran como están distribuidas las diferentes tensiones y la solidez de los planos de GND.

3. Implementación del Diseño

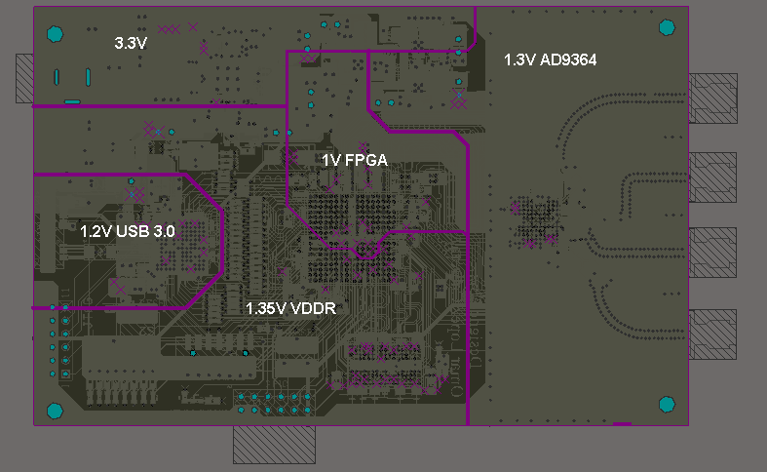
[picture p29: figure]

Figura 38: Plano1 de power

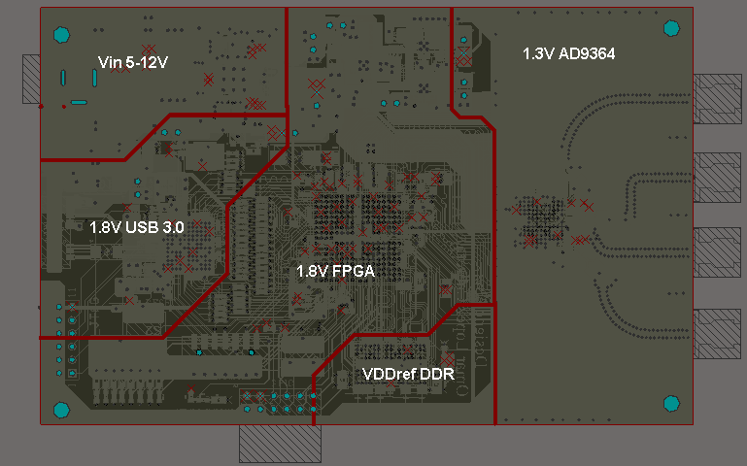
[picture p30: figure]

Figura 39: Plano2 de power

Una de las recomendaciones principales para los planos de tierra es que sean superficies de cobre ininterrumpidas que cubran toda la placa. En las siguientes figuras se muestran dichos planos sólidos.

Falta figura planos solidos GND

3.13 Capacitores desacople

Los capacitores de desacople funciona como un fuente de poder local muy chica para los circuitos integrados. Si el suministro de poder cae

3. Implementación del Diseño

temporalmente en voltaje, estos capacitores pueden entregar voltaje durante un breve periodo de tiempo. Es por esto que estos capacitores también son llamados capacitores de bypass, ya que pueden temporalmente actuar como fuente de poder haciendo un bypass la fuente suministradora.

Todos los componentes cuentan con sus condensadores de desacoplo. En particular tanto en el controlador del USB 3.0 y el transceiver AD9364 los capacitores de desacople fueron seleccionados y colocado como en sus placas de desarrollo (por recomendación del fabricante).

Por otra parte, en el caso de la FPGA, Xilinx directamente recomienda la cantidad de condensadores de desacoplo que se deben proveer, incluso sugiere los fabricantes y modelos, ya que cumplen con requisitos de calidad en cuanto a ESR, ESL y degradación de la capacidad con el tiempo y la temperatura.

Lo más importante es que cada uno rango de valores de capacitancia son útiles en unos márgenes de frecuencia, influyendo a la distancia a la que se deben colocar de la FPGA. Por ejemplo los capacitores grandes actúan cuando el regulador de voltaje deja de funcionar en el rango de frecuencia baja.

Los capacitores grandes pueden ser ubicados en cualquier parte en los alrededores de la FPGA en cambio los pequeños deben ser colocados lo más cerca posible de los pines de alimentación. Esto es complicado para los integrados que tienen capsulado BGA pues hay una gran cantidad de vías justo debajo del chip y cuesta mucho ubicar todos los condensadores en sus lugares óptimos.

En la siguiente figura se muestra la parte posterior de la FPGA en donde se puede observar que los capacitores más pequeños ocupan el centro mientras que los más grandes los alrededores.

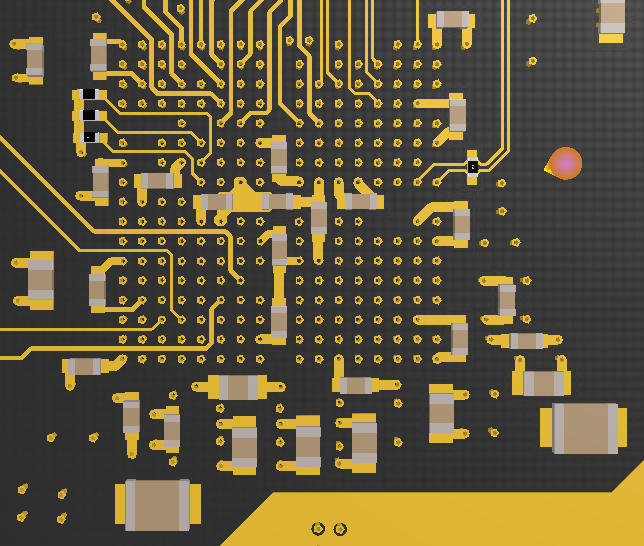
[picture p31: figure]

Figura 40: Ubicación capacitores desacople FPGA

3. Implementación del Diseño

3.14 Modelo 3d

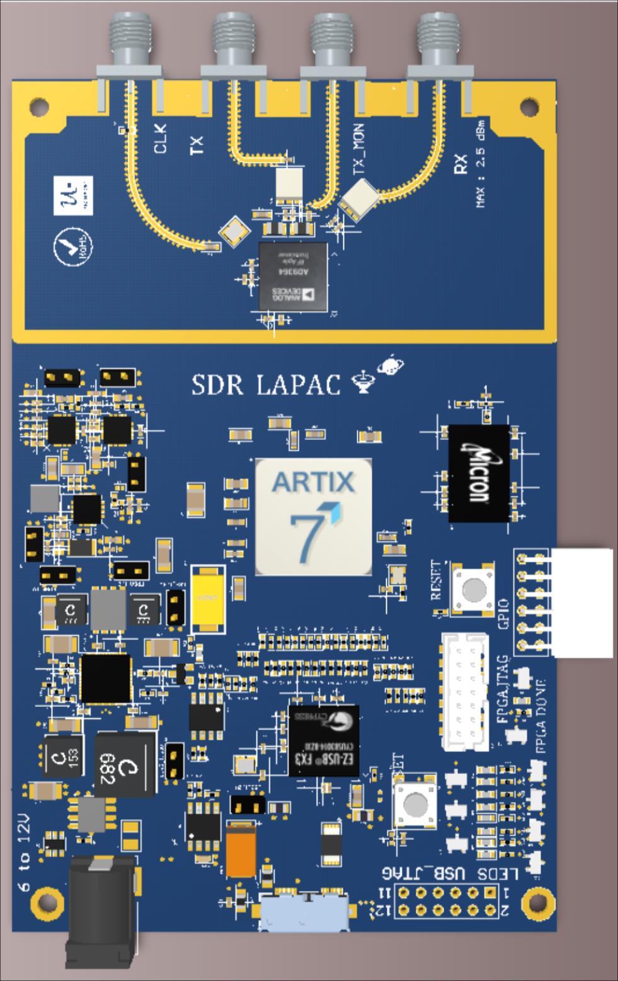
[picture p32: figure]

Figura 41: Modelo 3D placa, vista superior

3. Implementación del Diseño

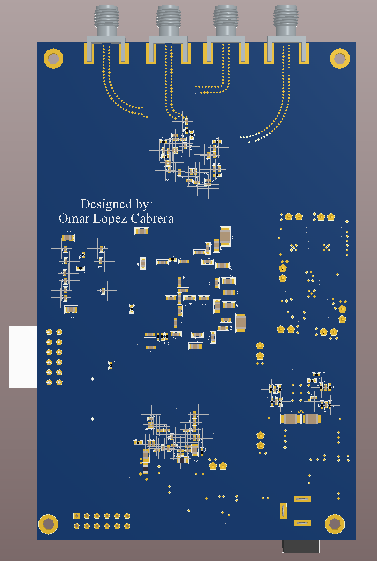
[picture p33: figure]

Figura 42: Modelo 3D placa, vista inferior

4. Sumario

## Capítulo 4

## 4. Sumario (Falta completar)

4.1 Simulación de integridad de la señal

Por otra parte, también sería muy interesante realizar simulaciones de integridad de la señal. Este tipo de simulaciones no son de carácter funcional sino de carácter físico. Actualmente los fabricantes proporcionan modelos de simulación de sus circuitos integrados en unos archivos llamados IBIS. Estos archivos contienen información de niveles de tensión y corriente en los pines de entrada y salida del chip, obtenidas de mediciones o de simulaciones del circuito.

Para realizar este tipo de simulaciones se pueden utilizar los siguientes programas:

- Mentor Graphics
- HyperLynx
- Cadence Design System

Dichos simuladores con estos archivos son capaz de simular cómo aparece un impulso eléctrico en un pin de salida, qué alteraciones sufre durante su recorrido por la placa y cómo es recibido en el pin del receptor.

4.2 Fabricación y ensamblado del PCB

Una vez que terminado las simulación y los requerimientos por parte del fabricante son cumplidos es momento de enviar el diseño a fabricación. Al tratarse de un primer prototipo por lo general se realizan una tirada pequeña de placas, lo cual aumenta el costo por placa.

Durante el desarrollo del proyecto se contactó con el fabricante “PCB Prototype” para pedir los datos necesarios para el diseño (datos sobre el stack up, costos y requerimientos de fabricación), por lo cual es recomendable realizar la fabricación con dicho proveedor.

La segunda operación a realizar es la compra de componentes. Si bien todos los componentes discretos y la mayoría de circuitos integrados están en permanente disponibilidad, algunos componentes más exclusivos como la

4. Sumario

FPGA o el transceiver pueden estar sujetos a fabricación bajo pedido o sin stock por lo tanto puede llevar a una demora en la recepción de varias semanas. Al tratarse de una gran cantidad de componentes se debió utilizar tres proveedores (Digikey, Mouser y Mini-Circuits) para cubrir la totalidad de los mismos.

La última operación es el ensamblado de la placa. El cual consiste en montar y soldar todos los componentes de la placa. El proceso más común consiste en utilizar un stensil (plantilla de metal con perforaciones, provisto por PCB Prototype) como mascara sobre el PCB para depositar la pasta de soldado. Luego los componentes se sueltan en su sitio de la placa donde quedan sujetos por esta pasta aún semilíquida. Finalmente, el PCB se introduce en un horno especial con curvas de temperaturas controladas, produciéndose la soldadura dentro del mismo.

Debido a la gran cantidad de componentes y el uso de circuitos integrados en encapsulados BGA es recomendable que se contrate un servicio de ensamblado.

4.3 Implementación en VHDL y drivers

Un primer paso importante sería poder contar con algunos de los algoritmos implementados en VHDL, para así poder estimar con más precisión los requisitos que la FPGA debe cumplir en cuanto a recursos lógicos.

Falta comentar drivers, librerías , gnu radio etc

4.4 Posibles Mejoras

- Transceiver 2x2: Para transformar esta SDR a una Multi Input Multi Output (MIMO), solo hay que cambiar el transceiver AD9364 por el AD9361. El AD9361 tiene el mismo encapsulado, pin out e interface digital que el AD9364 por lo que solo habría que modificar la parte de RF. Los sistemas MIMO son una parte importante de los estándares de comunicación Wireless modernos como por ejemplo: IEEE 802.11(Wi-Fi), 4G, 3GPP Long Term Evolution, WiMAX and HSPA+.
- Posibilidad de boot dual de la FPGA: Se puede agregar el hardware necesario para poder seleccionar el modo de boot de la FPGA (memoria Flash o via USB) y selección del camino de datos adecuado. Realizando esta mejora la SDR puede llegar a operar de forma autónoma sin la necesidad de una PC para ciertas aplicaciones.
- Amplificador en la parte de tx rf

4. Sumario
- Baluns según rango de frecuencia: La impedancia de los puertos de RF del transceiver varían según la frecuencia. Por este motivo es difícil obtener un ajuste óptimo de impedancia y performance para un amplio rango de frecuencia (70Mhz to 6Ghz).En particular el transceiver utilizado en este proyecto tienen 3 pares de puertos diferenciales para Rx (Rxa, Rxb, Rxc) y 2 pares para Tx (Txa, Txb).Se puede aprovechar esta cantidad de puertos para dividir el rango de frecuencia en varios más acotados, utilizando un mejor balun para cada rango de frecuencia. Luego la salida de cada balun iría conectada a un selector de camino de RF, el cual a su vez se conectaría a la antena.

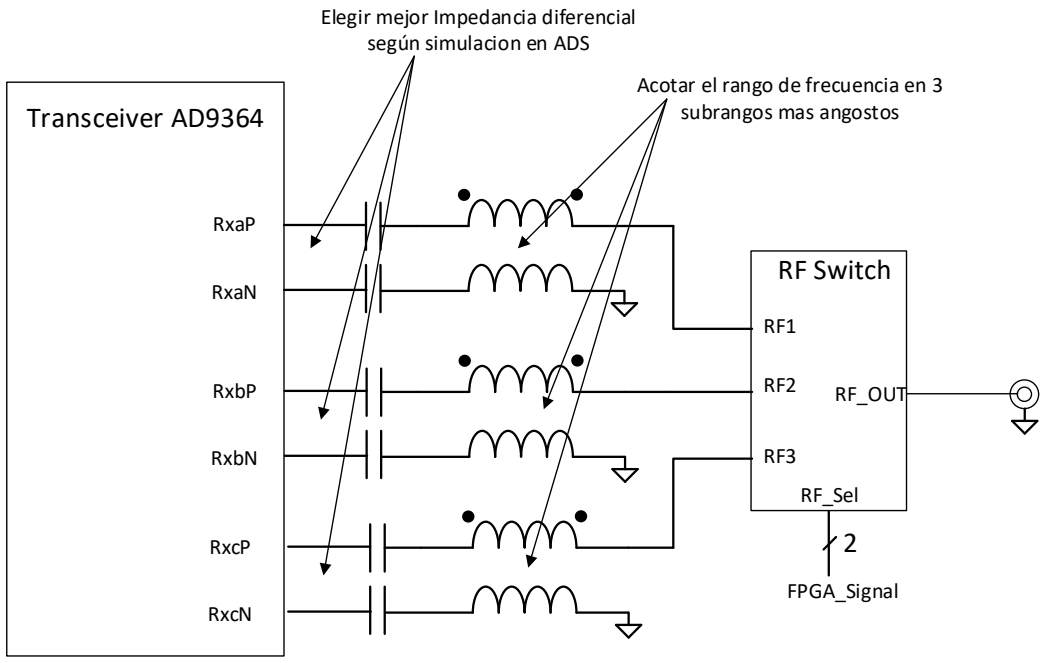
[picture p34: figure]
Transceiver AD9364; RxaP; RxaN; RxbP; RxbN; RxcP; RxcN; RF Switch; RF_OUT; RF_Sel; FPGA_Signal; Elegir mejor Impedancia diferencial según simulacion en ADS; Acotar el rango de frecuencia en 3 subrangos mas angostos

Figura 43: Diagrama de conexión, mejora etapa RF

4.5 Conclusiones

4. Sumario

Anexos

## Anexos

A-Cuestiones generales del diseño

Alimentación

Estimación Consumo FPGA

Para estimar el consumo de la FPGA se utilizó la herramienta “Xilinx® Power Estimator (XPE)”. Esta herramienta considera los recursos utilizados en el diseño, como por ejemplo: toggle rates, I/0 loading y otros factores que combinados son utilizados para estimar la distribución de power.

La estimación de power para dispositivos programables es un proceso complejo porque depende en gran medida de la cantidad de lógica en el diseño y la configuración de la misma.
Para estimar este consumo, esta herramienta pide como mínimo los siguientes parámetros de entrada:
- Dispositivo, encapsulado y grado de velocidad.
- Cantidad de recursos utilizados (flip-flops, look-up tables. Block RAM, etc).
- Frecuencia de clock.
- Una estimación del data toggle rate.
- Uso de memoria externa.
- Temperatura del medio en el que va a operar

Toggle rate

Obtener un toggle rate preciso es esencial para que la estimación de power sea correcta. Esta información no está disponible en esta etapa del diseño ya que depende de la lógica programada y el funcionamiento de la misma. Para estimar este valor Xilinx da como guía los siguientes puntos a tener en cuenta:

- Para un camino sincrónico, el toggle rate refleja que tan seguidas las salidas cambian con respecto al clock de entrada. Este cambio es modelado de forma porcentual entre 0-100% (200% para DDR).Un máximo de toggle rate en los datos significa que la salida cambia en cada flanco ascendente de clock.
- Para señales no periódicas, el toggle rates no es fácil de predecir. Un método efectivo para estimar el promedio de tasa de cambio para un determinado diseño, consiste en dividir al mismo en secciones por

Anexos

funcionalidad. Luego calcular el toggle rate en cada sección y obtener un promedio de todos. En general la mayoría de los diseños con una gran cantidad de lógica tienen un 12.5% de promedio de toggle rate (este porcentaje es el que trae por default la herramienta).

Teniendo en cuenta esta guía y sobredimensionando, se decidió utilizar los siguientes parámetros para obtener una estimación del consumo de la FPGA:

- 100% de uso de recursos de la FPGA (peor caso).
- 40% de toggle rate (a una frecuencia de 150 Mhz y 50% de uso)
- DDR3l external memory de 16 bits de datos (memoria usada).
- Temperatura ambiente de 25 °C (enviroment still air).
- Modelo de la FPGA: Artix-7-XC7A100T-1FTG256C.

Con estos parámetros la herramienta nos da los siguientes datos de salida:

- Consumo y temperatura de la FPGA:

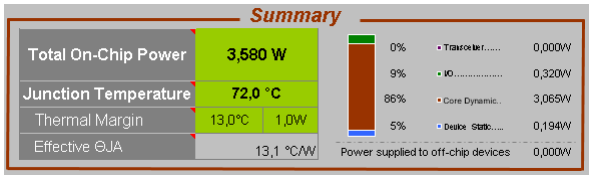
[picture p35: figure]

- Corriente necesaria por cada tensión de alimentación de la FPGA:

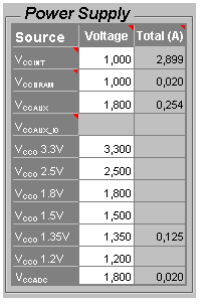
[picture p36: figure]

Esta última tabla ayudara a determinar las corrientes necesarias para cada buck regulator del integrado ADP5054.

Anexos

Programa ADP5054 criterio más eficiente

Las conexiones y componentes de este integrados se obtienen mediante el programa “505x BuckDesigner” brindado por Analog Devices. Este programa requiere como datos de entrada:

- Modelo del Regulador
- Temperatura máxima del ambiente.
- Criterio de diseño (más eficiente, menor espacio, menor costo): en este caso se decidió priorizar la eficiencia.
- Tensión de alimentación de cada buck.
- Tensión y corriente de salida de cada buck.

La siguiente figura muestra el menú en donde ingresar dichos parámetros de entrada.

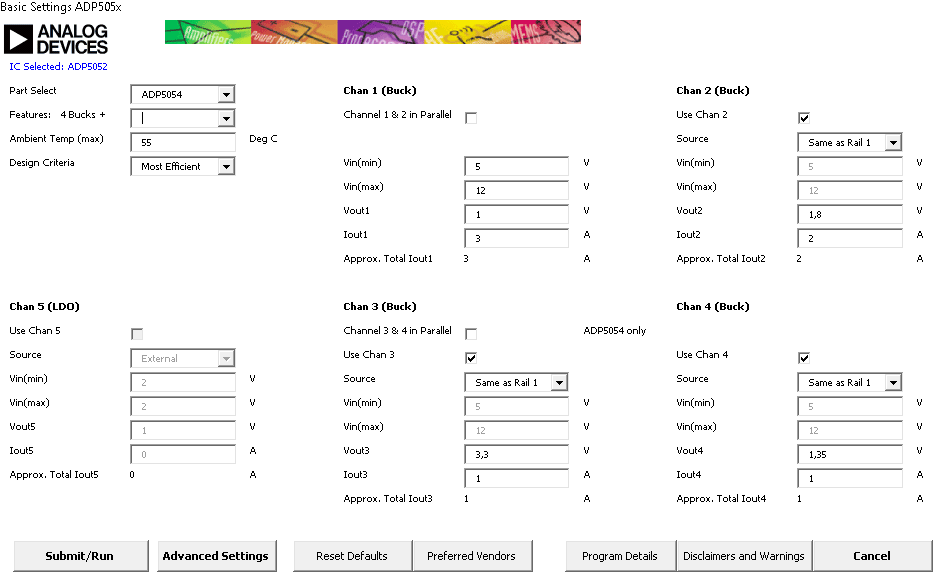
[picture p37: figure]

A partir de estos parámetros se obtiene:

- Conexiones del circuito
- Componentes a utilizar
- Diagramas de eficiencia, perdida de potencia y ganancia

Agregar imagen de circuito componentes y diagramas?

Vías para escape térmico

Las vías térmicas son agujeros mecánicos que atraviesan toda la placa. Estás vías son idealmente colocadas directamente bajo los componentes de montaje superficial que disipan mucho calor. Este método hace que el calor que fluye a través de las vías sea disipado en los planos solidos de GND.

Anexos

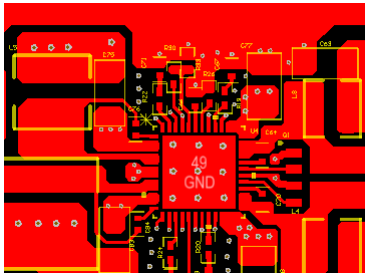
[picture p38: figure]

Header test por etapa

La alimentación de cada sección está separada por un header, de esta manera se puede ir probando cada sección por separado. Una vez probada el correcto funcionamiento de todas las etapas, estos headers pueden ser reemplazados por resistencias de 0 ohms

En la siguiente figura se puede ver dichos headers tanto en el modelo 3D como en el esquemático.

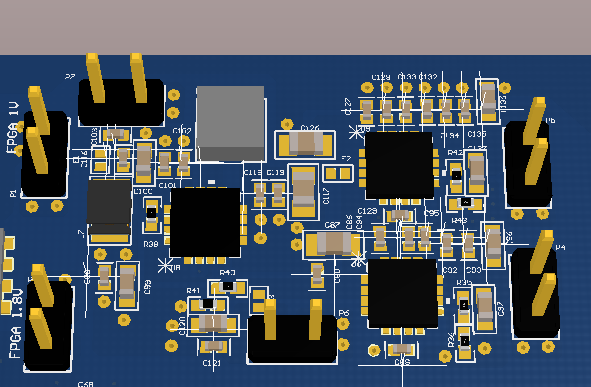
[picture p39: figure]

Calculo de corriente por vías.

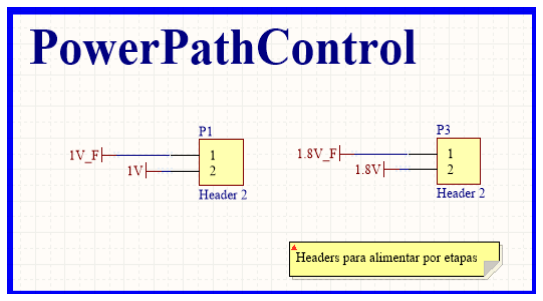
[picture p40: figure]

Se corroboro que el tamaño de vías de los header va a ser suficientes para soportar la corriente máxima de cada fuente de alimentación (peor caso 3 A para la tensión de 1V FPGA).

Utilizando la herramienta: Saturn PCB Design, se calculó la corriente máxima que soportan las vías.

Anexos

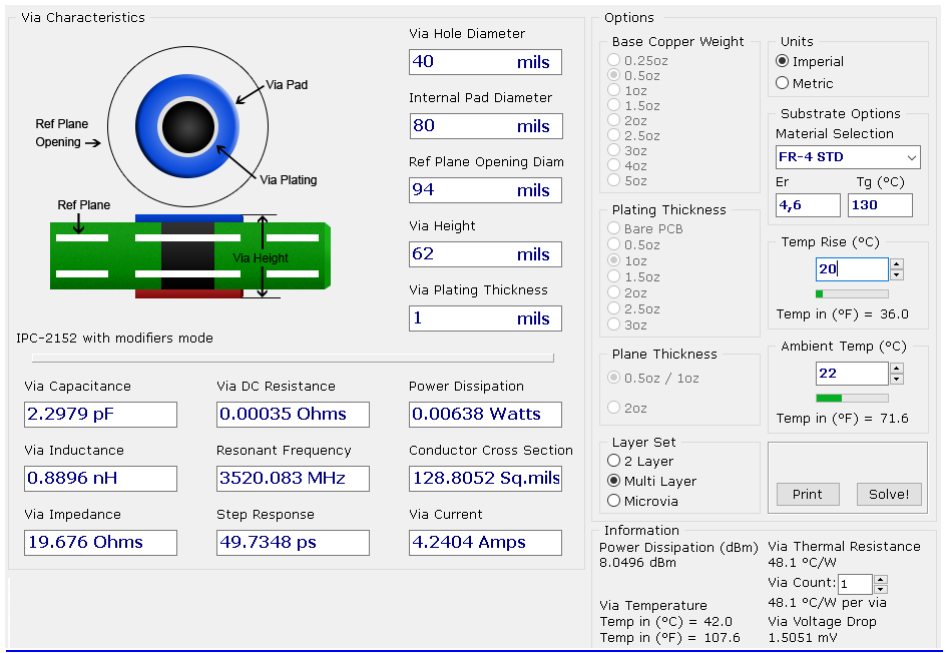
[picture p41: figure]

Se estimó que los headers (tamaño de agujero = 40 mils y largo =62 mils) soportan 4.2 A de corriente máxima.

Simulaciones Power

Se simulo una gran parte de la sección de alimentación utilizando la herramienta LTspice. En esta simulación se pudo observar: el correcto funcionamiento del selector de alimentación LTC4412, como la de los convertidores DC-DC: ADP5054, ADP2164.

Las siguientes figuras muestran el circuito y los resultados obtenidos durante la simulación

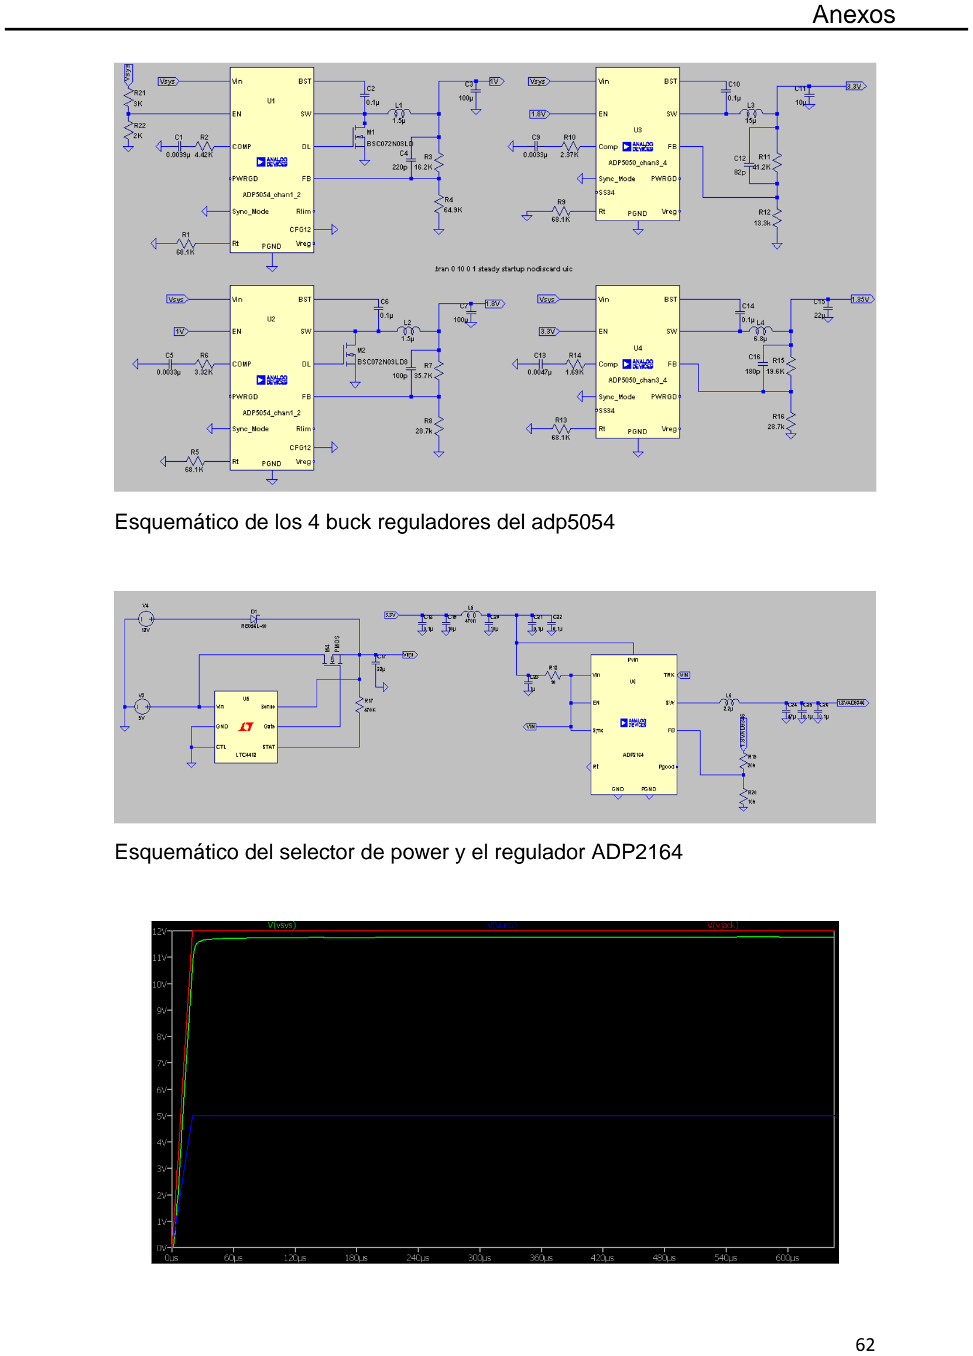
[picture p42: page 72]

Anexos

Esquemático de los 4 buck reguladores del adp5054

Esquemático del selector de power y el regulador ADP2164

Anexos

En esta imagen se puede apreciar el correcto funcionamiento del selector de power LTC4412, ya que ante la presencia de ambas tensiones de alimentación (USB y Jack), la tensión de salida es la provista por el Jack.

Imagen de tensiones:

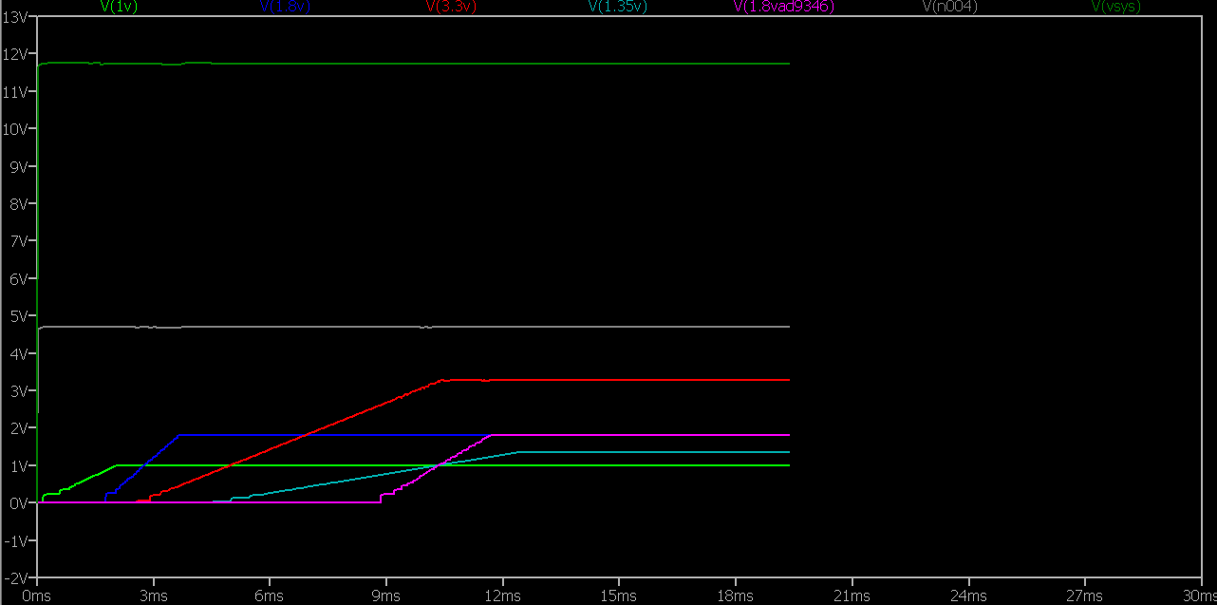
[picture p43: figure]

En esta figura se puede apreciar que los niveles de tensión y la secuencia de encendido de la FPGA son los correctos.

USB 3.0

Calculo Impedancia diferencial

Para calcular las impedancias diferenciales se utilizó el programa “Microstrip & Stripline calculator” desarrollado por Jean Nicolle.

El mismo solo necesita como datos de ingreso la información del stack-up y variando el ancho pista y la separación entre las mismas se puede obtener la impedancia deseada.

Resultados para la impedancia de 90 Ohms +/- 10% requerida por el controlador USB 3.0

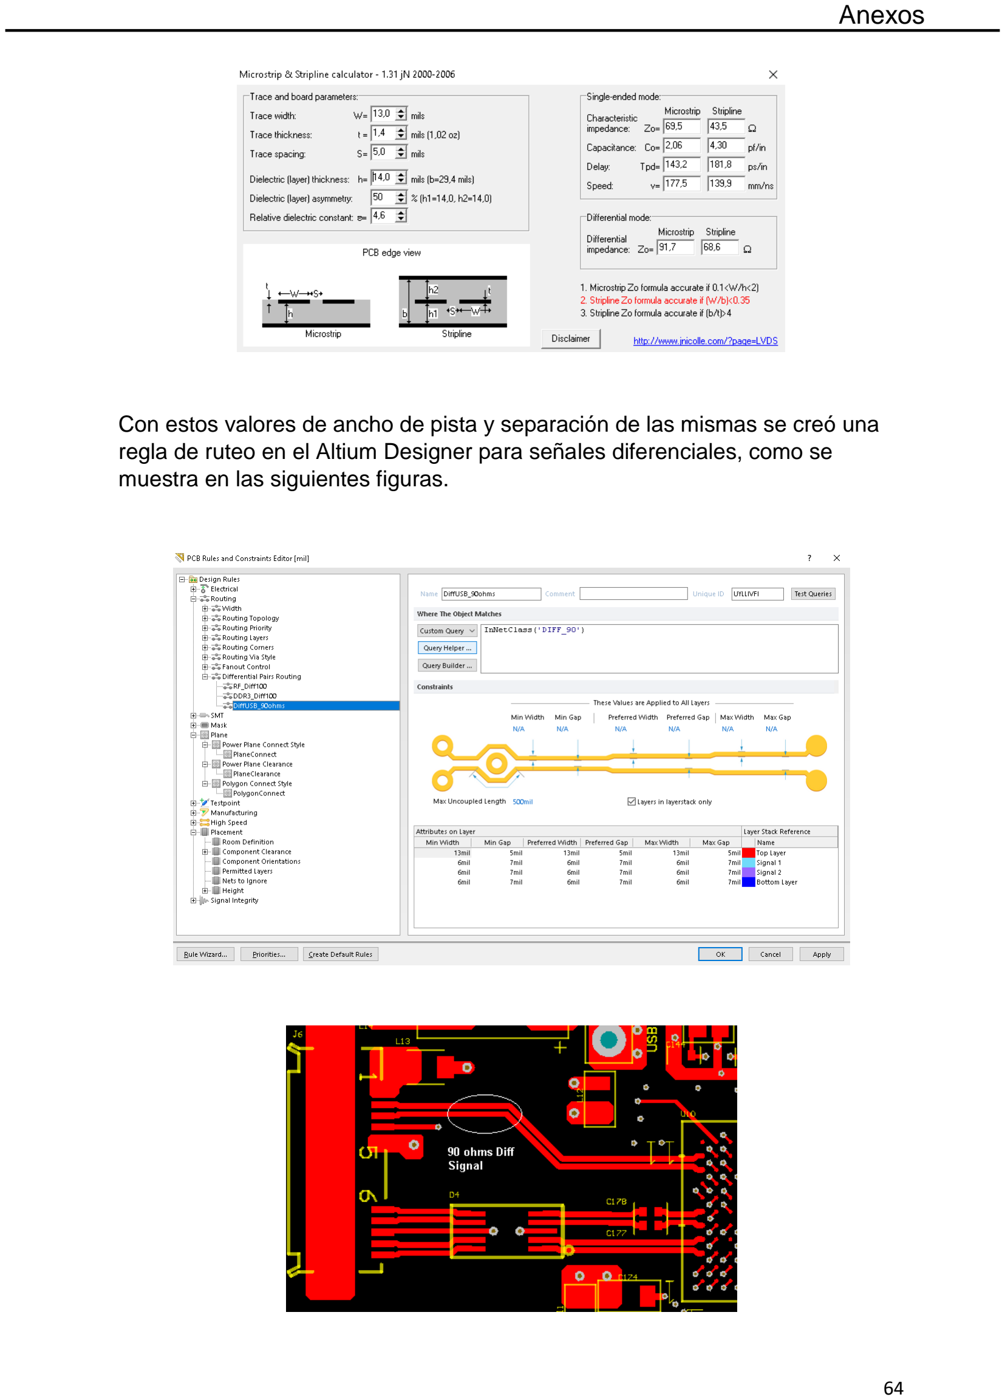
[picture p44: page 74]

Anexos

Con estos valores de ancho de pista y separación de las mismas se creó una regla de ruteo en el Altium Designer para señales diferenciales, como se muestra en las siguientes figuras.

Anexos

Del mismo modo se calculó las demás impedancias diferenciales.

Protección ESD

Uso de herramienta xSignals

Algunos de los requerimientos de las conexiones entre el controlador del USB 3.0 y la FPGA son los siguientes:

- Utilización de resistencia de 22 ohm para evitar reflexiones
- Largo máximo de cada línea 5 pulgadas (5000 mil).
- Max diferencia de largo entre las líneas 500 mil.

El principal problema es llevar un seguimiento del largo de cada línea, ya que el ruteo de las mismas se lleva a cabo en diferentes capas y tramos (del controlador a la resistencia y de la resistencia a la FPGA). Por ejemplo las siguientes figuras muestras dos posibles escenarios de conexión entre la FPGA y el controlador.

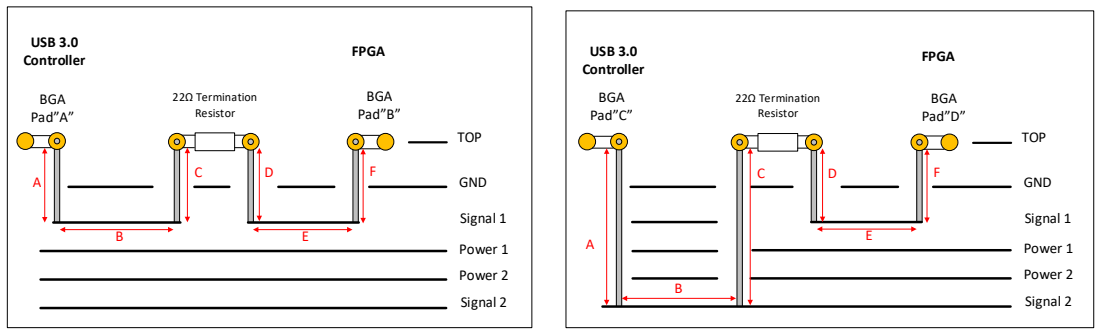
[picture p45: figure]
USB 3.0; Controller; FPGA; BGA Pad A; BGA Pad B; TOP; GND; Signal 1; Signal 2; Power 1; Power 2; 22 Termination Resistor; USB 3.0 Controller; BGA Pad C; BGA Pad D

Para cumplir los requerimientos de máxima diferencia entre líneas, la distancia A+B+C+D+E+F de ambas figuras deben ser iguales o menor a 500 mils. Para poder controlar estas distancias se utilizó la herramienta xSignals del Altium Designer, la cual lleva un control de las distancias totales de conexiones entre ambos componentes (el controlador y la FPGA). Esta herramienta en particular está disponible a partir de la versión de Altium Designer 16.0. Si se dispone de una versión anterior hay que sumar manualmente (con una tabla en Excel) cada tramo.

Mediante la utilización de la misma se genera una regla de ruteo, con la cual se controla el largo de las interconexiones entre ambos integrados. La siguiente figura muestra una de estas reglas:

Anexos

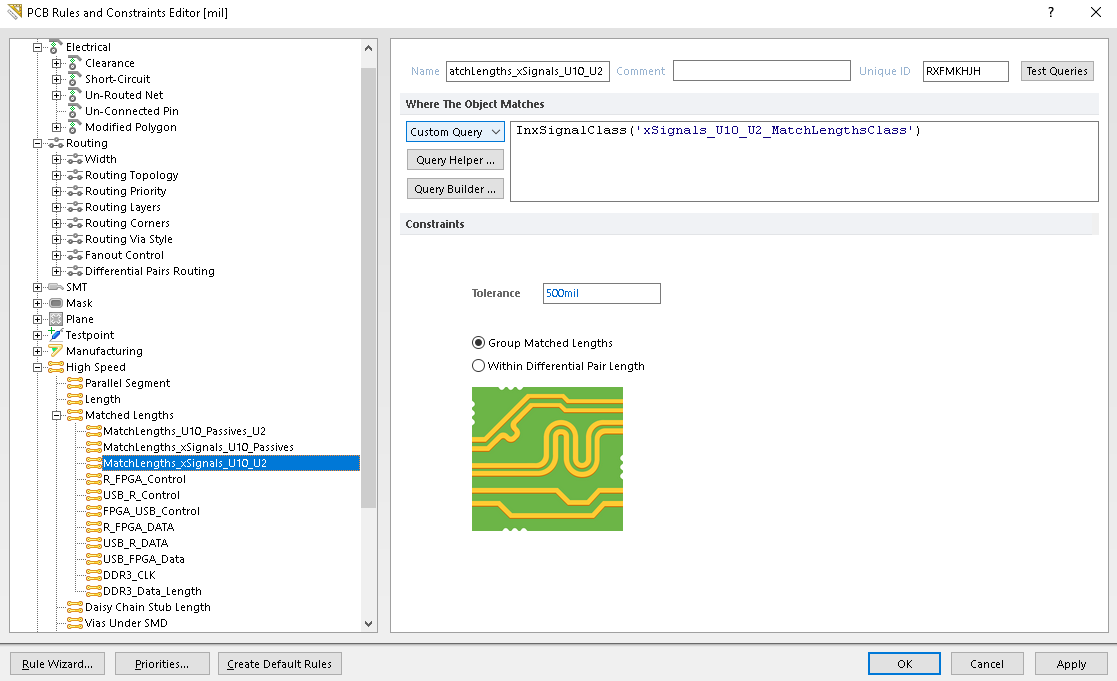
[picture p46: figure]

En donde U10 es el controlador del USB 3.0, U2 es la FPGA y la tolerancia de 500 mil es el requerimiento.

En las siguientes tablas muestran las distancias de las conexiones entre el controlador de USB 3.0 y la FPGA:

Name | Routed Length (mil) | Name | Routed Length (mil)
DQ22 | 1464 | DQ30 | 1570
DQ4 | 1480 | DQ26 | 1576
DQ5 | 1487 | DQ12 | 1579
DQ8 | 1488 | DQ25 | 1579
DQ21 | 1491 | DQ23 | 1580
DQ20 | 1494 | DQ19 | 1581
DQ7 | 1499 | DQ27 | 1585
DQ16 | 1515 | DQ3 | 1590
DQ15 | 1517 | DQ28 | 1593
DQ13 | 1524 | DQ14 | 1608
DQ1 | 1527 | DQ17 | 1624
DQ2 | 1534 | DQ31 | 1635
DQ18 | 1538 | DQ6 | 1637
DQ11 | 1550 | DQ10 | 1653
DQ29 | 1568 | DQ0 | 1671
DQ9 | 1569 | DQ24 | 1676

Anexos

Como se puede apreciar en las tablas, la máxima diferencia de longitud entre las líneas de interface USB-FPGA es de 260 mil (1724-1464), cumpliendo con el requerimiento de 500 mil de máxima diferencia de longitud.

AD9364

Shielding sección RF

Se añadió la opción de poder aislar la sección de RF del transceiver AD9364 mediante la utilización de una jaula. La misma iría soldada sobre la parte expuesta de cobre, la cual tiene vías a GND.

La siguiente figura muestra dicha sección:

Name | Routed Length (mil)
CTL0 | 1476
CTL1 | 1483
CTL2 | 1470
CTL3 | 1552
CTL4 | 1486
CTL5 | 1569
CTL6 | 1559
CTL7 | 1472
CTL8 | 1542
CTL9 | 1599
CTL10 | 1509
CTL11 | 1537
CTL12 | 1557
PCLK | 1724

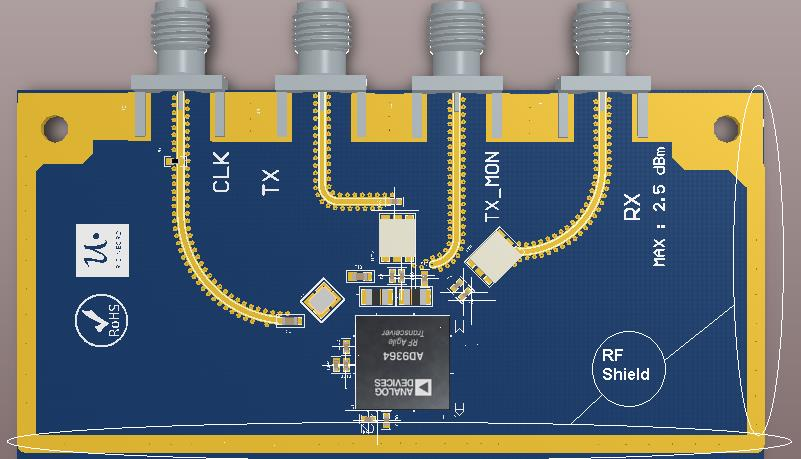
[picture p47: figure]

Anexos

Coplanar waveguide y ajuste de impedancia

Para calcular la impedancia de las coplanar waveguide se utilizó la herramienta: Saturn PCB Design, la misma pide como datos de entrada: el ancho de la pista (W), separación entre GNDs adyacentes (G), distancia al plano de GND más cercano (H) y la constante dieléctrica del material (Er). Obteniendo como resultado la impedancia de la coplanar waveguide, la siguiente figura muestra el resultado obtenido con esta herramienta:

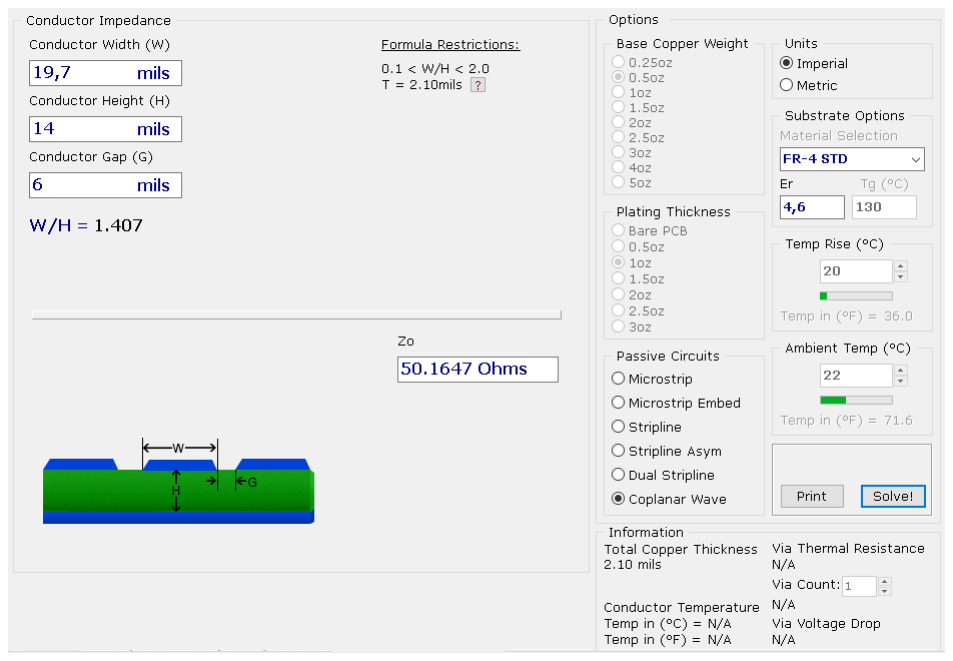
[picture p48: figure]

Las coplanar waveguide tienen las siguientes cualidades en comparación a las microstrip line:

- Más simples de fabricar(menos cobre a eliminar cuando se realiza el printed circuit)
- Reducción de perdida por radiación
- Reducción de cross talk (campos eléctricos y magnéticos confinados)

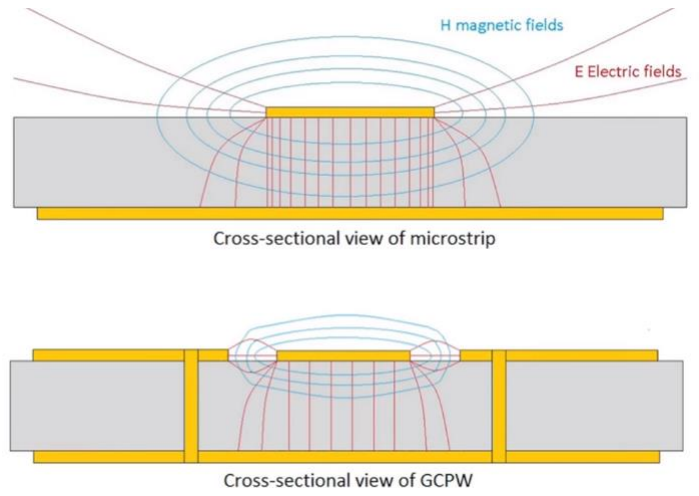
[picture p49: figure]

Anexos

Para más información ver [ https://www.rogerscorp.cn/documents/2311/acs/articles/Comparing-Microstrip-and-CPW-Performance.pdf (https://www.rogerscorp.cn/documents/2311/acs/articles/Comparing-Microstrip-and-CPW-Performance.pdf) ]

Ajusto de stackup y ancho de pista 50 ohms rf para tener mismo ancho que conector sma y reducir la desadaptación de impedancia al pasar del pcb al conector

Conexiones Tx y Rx

Los amplificadores de bajo ruido en los puertos de Rx (Rxa, Rxb, Rxc) son funcionales en el rango de frecuencia de 70 MHz – 6 GHz. Cuando estos operan por debajo de los 3 GHz, todos los puertos de entrada de los LNA proveen una performance óptima. Cuando la frecuencia de operación está por encima de los 3GHz es conveniente utilizar los puertos de entrada Rxa y Rxb para una performance óptima. Estos tres puertos son diferenciales pero también pueden ser configurados como single ended. La recomendación por parte del fabricante es utilizarlos en modo diferencial para lograr la mejor performance en: figura de ruido y orden par de distorsión (IP2). El máximo nivel de entrada es de +2.5 dBm de pico (single ended, ideal match, 50 ohm source).La siguiente figura muestra las posibles configuraciones single ended y diferenciales para la interface:

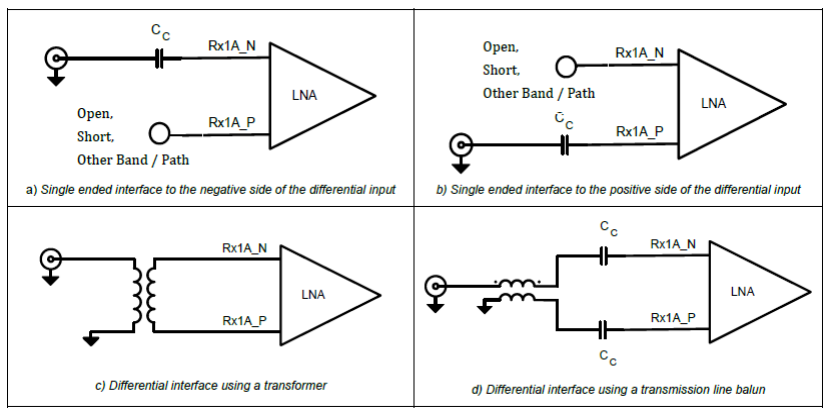
[picture p50: figure]

De los dos opciones con interface diferencial se decidió implementar la opción “D”, la cual es utilizada en la placa de desarrollo de analog devices (modelo a seguir).

Anexos

(Ver y terminar de completar, Faltaría hacer alguna simulación con el ADS como muestra el FAQ )

(FAQ Link : https://ez.analog.com/cfs-file/__key/telligent-evolution-components-attachments/00-441-00-00-00-07-90-49/AD9361RFPortInterface_5F00_v2.1.pdf (https://ez.analog.com/cfs-file/__key/telligent-evolution-components-attachments/00-441-00-00-00-07-90-49/AD9361RFPortInterface_5F00_v2.1.pdf) )

La impedancia de los puertos de RF (Tx y Rx) del transceiver varía según la frecuencia. Por este motivo la interconexión entre estos puertos y el balun debe ser adaptada para su óptimo funcionamiento, estas conexiones se realizaron según el FAQ “AD9361 RF Port Interface”. Esta guía establece las siguientes recomendaciones:

- Pistas lo más cortas posibles
- Impedancia diferencial Rx de 100 ohms
- Impedancia diferencial de Tx de 50 ohms (Problema con ancho sugerido por el FAQ de 35 mil width, la placa de desarrollo utiliza 100 ohm diff.Ante esta duda en el foro dice que al tratarse de un wideband es muy difícil encontrar la impedancia optima, por lo que indica que la conexión entre el AD9364 y el balun sea lo más corto posible)

Criterio de interface digital transceiver

En particular este dispositivo no impone explícitamente requerimientos en cuanto a la máxima diferencia de largo entre cada línea de su interface digital con el BBP. En su lugar da restricciones en cuanto a tiempos en el camino de datos y la interface SPI como muestran las siguientes figuras:

Constrains al camino de datos:

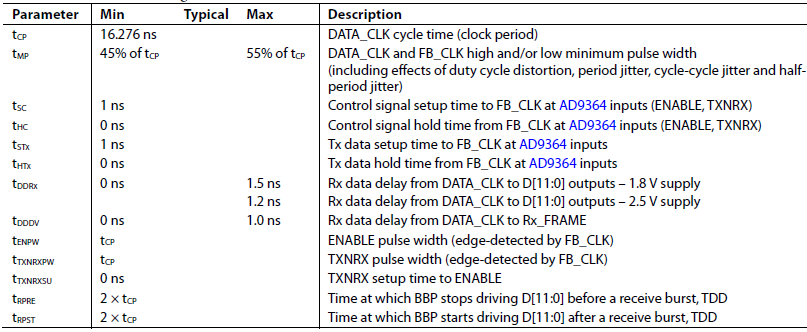
[picture p51: figure]
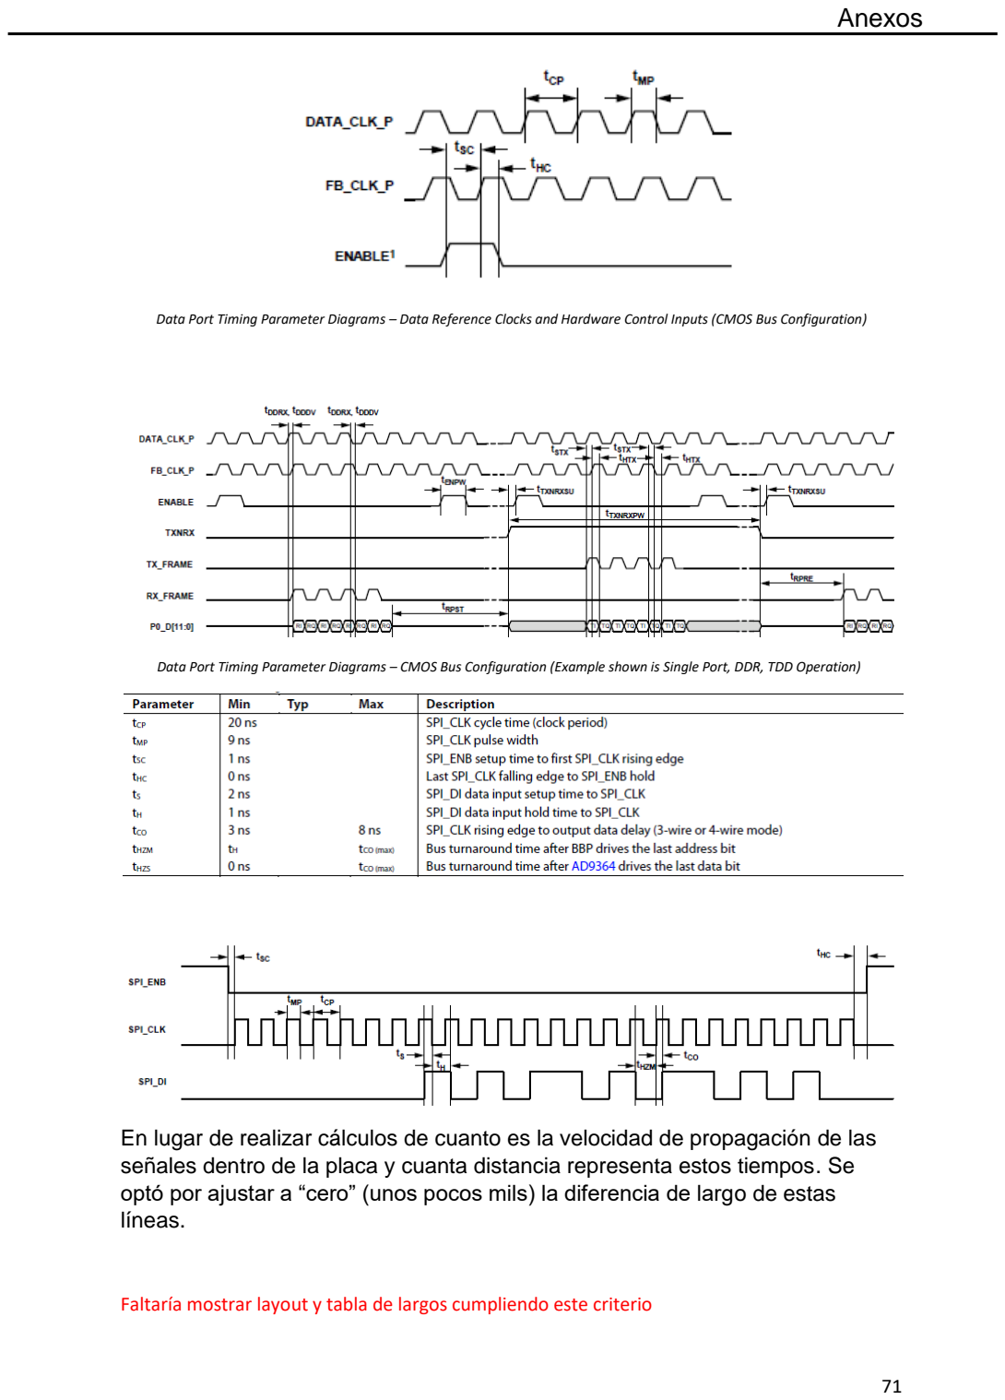
[picture p52: page 81]

Anexos

Data Port Timing Parameter Diagrams – Data Reference Clocks and Hardware Control Inputs (CMOS Bus Configuration)

Data Port Timing Parameter Diagrams – CMOS Bus Configuration (Example shown is Single Port, DDR, TDD Operation)

En lugar de realizar cálculos de cuanto es la velocidad de propagación de las señales dentro de la placa y cuanta distancia representa estos tiempos. Se optó por ajustar a “cero” (unos pocos mils) la diferencia de largo de estas líneas.

Faltaría mostrar layout y tabla de largos cumpliendo este criterio

Anexos

B- Información general y hoja de datos

Recomendaciones por parte de los principales IC

Integrado | Nombre | Comentarios
FPGA | Recommended Design Rules and Strategies for BGA Devices-UG1099 | • Fan out del BGA
| 7 Series FPGAs PCB Design Guide -UG483 | • Capacitores a usar y sus posiciones. • Orden power layer en stackup. • Impedancia de pistas.
AD9364 | AD9364 Reference Manual UG-673 | • PCB material y selección del stack • RF layout • Fan-out and trace-space layout guidelines • Colocación de componentes y guía de ruteo • Power management y consideraciones de ruido
USB 3.0 | Hardware Design Guidelines and Schematic Checklist-AN70707 | • Recomendaciones a seguir tanto en hardware como en el esquemático.
DDR3 Memory | Hardware Tips for Point-to-Point System Design: Termination, Layout, and Routing | • Recomendaciones a seguir tanto en hardware como en el esquemático.

Capacidades Fabricante PCB Prototype

Toda la información en cuanto a las capacidades de fabricación de PCB Prototypes se encuentra en el siguiente link:

https://www.pcbprototype.com/en/pcb-capabilities

La mayoría de estas capacidades fueron impuestas como requerimientos del PCB en forma de reglas de ruteo.

Anexos

Información sobre conexiones de cada sección

Integrado | Sección | Guía de usuario
FPGA | Slave Serial Configuration. JTAG | 7 Series FPGAs Configuration-UG470
| DDR3 Memory | 7 Series FPGAs Memory Interface Solutions-UG586
| I/0 | 7 Series FPGAs SelectIO Resources-UG471
| Clock | 7 Series FPGAs Clocking Resources-UG472
USB 3.0 | Interface GPIF FPGA | Designing with the EZ-USB® FX3™ Slave FIFO Interface AN65974
| Boot FPGA | Configuring an FPGA Over USB Using Cypress EZ-USB® FX3™ AN84868
| Interface USB | EZ-USB® FX3™/FX3S™ Hardware Design Guidelines and Schematic Checklist AN70707
| Boot USB 3.0 | EZ-USB® FX3™/FX3S™ Boot Options-AN76405
AD9364 | Interface | AD9364 Reference Manual UG-673

Esquematico, Gerbers, BOM

Todos los archivos del Proyecto fueron almacenados en el siguiente repositorio de Github: https://github.com/OmarLopezCabrera/Tesis-SDR-LAPAC-Open-Source

Referencias

## Referencias

[1]. All Programmable 7 Series Product Selection Guide.

Link: https://www.xilinx.com/support/documentation/selection-guides/7-series-product-selection-guide.pdf (https://www.xilinx.com/support/documentation/selection-guides/7-series-product-selection-guide.pdf)

[2]. USB 3.0 Core IO Power.

Link: https://www.cypress.com/file/145131/download

[3].DDR3 Power Calculation.

Link: https://www.micron.com/-/media/client/global/documents/products/power-calculator/ddr3_ddr3l_power_calc.xlsm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 (https://www.micron.com/-/media/client/global/documents/products/power-calculator/ddr3_ddr3l_power_calc.xlsm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)

Application Note on Transformers (AN-20-002) Minicircuits

Bibliografia

## Bibliografia

Eugene Grayver-Implementing Software Defined Radio

Software Defined Radio Evolution with MIMO (Multi Input Multi Output) Technique:

https://www.ijser.org/paper/Software-Defined-Radio-Evolution-with-MIMO-Multi-Input-Multi-Output-Technique.html (https://www.ijser.org/paper/Software-Defined-Radio-Evolution-with-MIMO-Multi-Input-Multi-Output-Technique.html)

Microwave Engineering- David M.Pozar
