OmarLopezCabrera/Tesis-SDR-LAPAC-Open-Source/Info Componentes/Artix-7/7_Series_XPE_2016_3.xlsm

Sheet: Summary
 |  |  | Xilinx Power Estimator (XPE) - 2016.3 |  |  |  |  |  |  |  |  |  |  |  |  |  |  |  |  |  |  |  |  |  |  |  |  | 1 |  | Pkgs | 1 | CLKROW | CLKCOL | LUT | FF | BRAM | MMCM | PLL | DSP | GT | PCIE |  | 3.3 Pins | Pins | Banks | ThetaJA | ThetaJB
 |  | Artix®-7, Kintex®-7, Virtex®-7, Zynq®-7000 |  |  |  |  |  |  |  |  |  |  | Release: 5-Oct-2016 |  |  |  |  |  |  |  |  |  |  |  |  |  |  |  |  | FBG676 | 14 | 7 | 92 | 203800 | 407600 | 445 | 10 | 10 | 840 | 16 | 1 | 0 | 350 | 500 | 17 | 12.0 | 4.3
 |  |  |  |  |  |  |  |  |  |  |  |  |  |  |  |  |  |  |  |  |  |  |  |  |  |  |  |  |  | FBG900 | 3 | 1 |  | 128000 |  |  |  |  |  | 0
 |  |  |  |  |  |  |  |  |  |  |  |  |  |  |  |  |  |  |  |  |  |  |  |  |  |  |  |  |  | FFG676 |  | 1
Project |  |  |  |  |  |  |  |  |  |  |  |  |  |  |  |  |  |  |  |  |  |  |  |  |  |  |  |  |  | FFG900 |  |  |  |  |  |  |  |  |  | 0
Settings |  |  |  |  | Summary |  |  |  |  |  |  |  |  |  |  |  |  |  |  |  |  |  |  |  |  |  |  |  |  | FBV676
Device |  |  |  |  | Total On-Chip Power |  |  | 0.156 W |  |  | 0% | Transceiver…… |  | 0.000W |  |  |  |  |  |  |  |  |  |  |  |  |  |  |  | FBV900
Family | Kintex-7 |  |  |  |  |  |  |  |  |  | 0% | I/O……………… |  | 0.000W |  |  |  |  |  |  |  |  |  |  |  |  |  |  |  | FFV676
Device | XC7K325T |  |  |  | Junction Temperature |  |  | 25.3 °C |  |  | 0% | Core Dynamic.. |  | 0.000W |  |  |  |  |  |  |  |  |  |  |  |  |  |  |  | FFV900
Package | FBG900 |  |  |  | Thermal Margin |  |  | 74.7°C | 39.8W |  | 100% | Device Static….. |  | 0.156W |  |  |  |  |  |  |  |  |  |  |  |  |  | 10 | 0.12 | 0.12
Speed Grade | -2L |  |  |  | Effective ΘJA |  |  | 1.8 °C/W |  | Power supplied to off-chip devices… |  |  |  | 0.000W |  |  |  |  |  |  |  |  |  |  |  |  |  | 25 | 0.16 | 0.16
Temp Grade | Extended |  |  |  |  |  |  |  |  |  |  |  |  |  |  |  |  |  |  |  |  |  |  |  |  |  |  | 40 | 0.22 | 0.22
Process | Typical |  |  |  | On-Chip Power |  |  |  |  |  | Power Supply |  |  |  |  |  |  |  |  |  |  |  |  |  |  |  |  | 55 | 0.35 | 0.35
Voltage ID Used | No |  |  |  | Resource |  |  | Power |  |  | Source |  | Voltage | Total (A) | Static | Active |  |  |  |  |  |  |  |  |  |  |  | 70 | 0.59 | 0.59 |  |  |  |  |  | static | 0
Characterization | Production, v1.0, 2012-07-11 |  |  |  |  |  | (Jump to sheet) | (W) | (%) |  | VCCINT |  | 1.000 | 0.068 | 0.068 | 0.000 |  |  |  |  |  |  |  |  |  |  |  | 85 | 0.99 | 0.99 |  |  |  |  |  |  | 1
 |  |  |  |  | Core Dynamic |  |  | 0.000 | 0 |  | VCCBRAM |  | 1.000 | 0.001 | 0.001 | 0.000 |  |  |  |  |  |  |  |  |  |  |  | 100 | 1.63 | 1.63 |  |  |  |  |  |  | 1
Environment |  |  |  |  |  |  |  | 0.000 | 0 |  | VCCAUX |  | 1.800 | 0.028 | 0.028 | 0.000 |  |  |  |  |  |  |  |  |  |  |  |  |  |  |  |  |  |  |  |  | 1
Junction Temperature |  |  | 25.3 °C |  |  |  |  | 0.000 | 0 |  | VCCAUX_IO |  | 2.000 | 0.000 | 0.000 | 0.000 |  |  |  |  |  |  |  |  |  |  |  | 0.97 | 0.15 |  |  |  |  |  |  |  | 1
Ambient Temp | 25.0 °C |  |  |  |  |  |  | 0.000 | 0 |  | VCCO 3.3V |  | 3.300 | 0.000 | 0.000 | 0.000 |  |  |  |  |  |  |  |  |  |  |  | 0.985 | 0.15 |  |  |  |  |  |  | 0 | 1
Effective ΘJA |  |  | 1.8 °C/W |  |  |  |  | 0.000 | 0 |  | VCCO 2.5V |  | 2.500 | 0.000 | 0.000 | 0.000 |  |  |  |  |  |  |  |  |  |  |  | 1 | 0.16 |  |  |  |  |  |  | 0 | 1
Airflow | 250 LFM |  |  |  |  |  |  | 0.000 | 0 |  | VCCO 1.8V |  | 1.800 | 0.000 | 0.000 | 0.000 |  |  |  |  |  |  |  |  |  |  |  | 1.015 | 0.16 |  |  |  |  |  |  | 0 | 1
Heat Sink | Medium Profile |  |  |  |  |  |  | 0.000 | 0 |  | VCCO 1.5V |  | 1.500 | 0.000 | 0.000 | 0.000 |  |  |  |  |  |  |  |  |  |  |  | 1.03 | 0.16 |  |  |  |  |  |  | 0 | 1
ΘSA | 3.3 °C/W |  |  |  |  |  |  | 0.000 | 0 |  | VCCO 1.35V |  | 1.350 | 0.000 | 0.000 | 0.000 |  |  |  |  |  |  |  |  |  |  |  |  |  |  |  |  |  |  |  | 0 | 1
Board Selection | Medium (10"x10") |  |  |  | I/O |  |  | 0.000 | 0 |  | VCCO 1.2V |  | 1.200 | 0.000 | 0.000 | 0.000 |  |  |  |  |  |  |  |  |  |  |  |  |  |  |  |  |  |  |  | 0 | 1
# of Board Layers | 12 to 15 |  |  |  | Transceiver |  |  | 0.000 | 0 |  | MGTVCCAUX |  | 1.800 | 0.000 | 0.000 | 0.000 |  |  |  |  |  |  |  |  |  |  |  |  |  |  |  |  |  |  |  |  | 1
ΘJB | 2.6 °C/W |  |  |  |  |  |  | 0.000 | 0 |  | MGTAVCC |  | 1.000 | 0.000 | 0.000 | 0.000 |  |  |  |  |  |  |  |  |  |  |  |  |  |  |  |  |  |  |  |  | 1
Board Temperature | 25.0 °C |  |  |  |  |  |  | 0.000 | 0 |  | MGTAVTT |  | 1.200 | 0.000 | 0.000 | 0.000 |  |  |  |  |  |  |  |  |  |  |  | Temp | 50 | 85 | 100 |  |  |  |  |  | 1
 |  |  |  |  |  |  |  | 0.000 | 0 |  | - |  | 1.800 | 0.000 | 0.000 | 0.000 |  |  |  |  |  |  |  |  |  |  |  | Typical (1.0V) | 0.30 | 0.99 | 1.632003614 |  |  |  |  | 0 | 1
Implementation |  |  |  |  | Device Static | 0.156 |  | 0.156 | 100 |  | - |  | 1.075 | 0.000 | 0.000 | 0.000 |  |  |  |  |  |  |  |  |  |  |  | Maximum (1.03V) | 0.50 | 1.53 | 2.428447891 |  |  |  |  | 0 | 1
Optimization | Power Optimization |  |  | 2 |  |  |  |  |  |  | - |  | 1.075 | 0.000 | 0.000 | 0.000 |  |  |  |  |  |  |  |  |  |  |  |  |  |  |  |  |  |  |  | 0 | 1
 |  |  |  |  |  |  |  |  |  |  | - |  | 1.500 | 0.000 | 0.000 | 0.000 |  |  |  |  |  |  |  |  |  |  |  |  |  |  |  |  |  |  |  |  | 1
Messages |  |  |  |  |  |  |  |  |  |  | - |  | 1.800 | 0.000 | 0.000 | 0.000 |  |  |  |  |  |  |  |  |  |  |  |  |  |  |  |  |  |  |  |  | 1
 |  |  |  |  |  |  |  |  |  |  | - |  | 1.800 | 0.000 | 0.000 | 0.000 |  |  |  |  |  |  |  |  |  |  |  |  |  |  |  |  |  |  |  |  | 1
 |  |  |  |  |  |  |  |  |  |  | VCCADC |  | 1.800 | 0.020 | 0.020 | 0.000 |  |  |  |  |  |  |  |  |  |  |  |  |  |  |  |  |  |  |  | 0.02 | 1
XILINX Power Advantage (check for updates) (http://www.xilinx.com/products/technology/power/index.htm) |  |  |  | File Support Request (WebCase) (http://www.xilinx.com/support/clearexpress/websupport.htm) |  |  |  |  |  |  | Xilinx Power Estimator User Guide (http://www.xilinx.com/cgi-bin/docs/rdoc?l=en;v=latest;d=ug440-xilinx-power-estimator.pdf)
© Copyright 1994-2016 Xilinx, Inc. All Rights Reserved |  |  |  | Introduction to XPE (video) (http://www.xilinx.com/training/vivado/using-the-xilinx-power-estimator.htm) |  |  |  | Whitepaper - 7 Steps for Worst Case Power Estimation (http://www.xilinx.com/support/documentation/white_papers/wp353.pdf)
Legend |  | User Entry |  |  | Calculated Value |  | Summary Value |  |  | User Override |  | Warning |  | Error
 |  |  |  |  |  |  |  |  |  |  |  |  |  |  |  |  |  |  | JEDEC | 8.9
 |  |  |  |  | Piccq | Iccauxq | Tj | Iccq |  |  |  |  |  |  |  |  |  |  | BoardType | 2 |  | Airflow | Opt | Leakage | 0.156 | 67.99232034 | Utilization
 |  |  |  | 0.001272965596 | 0 | 0.028370062 | 25.25217688 | 0.0680994829 | Non-int Leakage | 0.0510 |  |  |  |  |  |  |  |  | BoardLyr | 2 |  | N/A | Default | CLOCK | 0 | 1.272965596
 |  |  | Temp | 25.25217688 | 0 | 0.02836623187 | 25.21611878 | 0.06799293138 | Scaled ICCQ_D | 0.0674 |  |  |  | Max Adj | Typ Adj |  |  |  | Airflow | 1 |  | 0 | Power Optimization | LOGIC | 0 | 28.36620991
 |  |  | Initial | 25.21468619 | 0 | 0.02836621004 | 25.21591304 | 0.06799232383 | Non-aux Leakage | 0.0689 |  |  | MMF Factor | 1 | 1 |  |  |  | Heatsink | 2 |  | 250 | Powered Off | BRAM | 0 | 0
 |  |  |  |  | 0 | 0.02836620992 | 25.21591186 | 0.06799232036 | Scaled ICCAUXQ_D | 0.2342 |  |  | MMF Aux | 1 | 1 |  |  |  | Pkg size | 961 |  | 500 | Y44:Y45 | DSP | 0 | 0
 |  |  |  |  | 0 | 0.02836620991 | 25.21591186 | 0.06799232034 | Iccint_c1 | 4.599625945e-05 |  |  | MMF Bram | 1 | 1 |  |  |  | Air | 173.4304544 |  | 750 |  | PLL | 0 | 0
 |  |  |  |  | 0 | 0.02836620991 | 25.21591186 | 0.06799232034 | Iccint_c2 | 0.0145 |  |  | VID Factor | 1 |  |  |  |  | ThetaSA | 3.300 |  | X46:X47 |  | MMCM | 0 | 0
 |  |  |  |  | 0 | 0.02836620991 | 25.21591186 | 0.06799232034 | Iccintq_d | 0.0674 |  |  | Bali Factor | 1 |  |  |  |  | ThetaCS | 0.100 |  |  |  | PHASER | 0 | 0
 |  |  |  |  |  |  |  |  | Iccintq_des | 0.0674 |  |  | Vccint | 1.024681888e-05 | 4.599625945e-05 | 0.01453966058 | 1.476393859 | 16.67643458 | ThetaJB | 4.300 |  |  |  | PCIE | 0 | 0
 |  |  |  |  |  |  |  |  | Iccaux_c1 | -4.934776639e-06 |  |  | Vccaux | 6.086615496e-07 | -4.934776639e-06 | 0.001934333736 | -0.02109488095 | 27.50124748 | ThetaJA | 3.729 |  |  |  | IO | 0 | 0
 |  |  |  |  |  |  |  |  | Iccaux_c2 | 0.0019 |  |  | Vccbram | 3.812886664e-07 | -7.677678239e-06 | 5.087784668e-05 | 0.04053298597 | 0.1882586949 | ThetaJX | 3.811 |  |  |  | GTX | 0 | 0
 |  |  |  |  |  |  |  |  | Iccauxq_d | 0.0283 |  |  |  |  |  |  |  |  | eThetaJA | 1.814 |  |  |  |  | 0 | 0
 |  |  |  |  |  |  |  |  | Iccoq | 0.0010 |  |  |  |  |  |  |  |  | TJA-Top | 3.360 |  |  |  |  |  | 0
 |  |  |  |  |  |  |  |  | Iccbram_c1 | -7.677678239e-06 |  |  |  |  |  |  |  |  | TJ | 25.295 |  |  |  |  |  | 0
 |  |  |  |  |  |  |  |  | Iccbram_c2 | 0.0001 |  |  |  |  |  |  |  |  | eThetaJA | 1.886 |  |  |  |  |  | 0
 |  |  |  |  |  |  |  |  | Iccbramq | 0.0000 | 0 | 0 |  |  |  |  |  |  | Power | 0.120 |  |  |  |  |  | 0
 |  |  |  |  |  |  |  |  | Process | 1.0000 |  |  |  |  |  |  |  |  | Power2 |  |  |  |  |  |  | 0
 |  |  |  |  |  |  |  |  | I-Grade | 1.4764 |  |  |  |  |  |  |  |  | Temp | 25.402 |  |  |  |  |  | 0
 |  |  |  |  |  |  |  |  | Q-Grade | 16.6764 |  |  |  |  |  |  |  |  | Temp | 25.226 |  |  |  |  |  | 0
 |  |  |  |  |  |  |  |  | I-Grade | -0.0211 |  |  |  |  |  |  |  |  | Temp | 25.40 |  |  |  |  |  | 20
 |  |  |  |  |  |  |  |  | Q-Grade | 27.5012
 |  |  |  |  |  |  |  |  | I-Grade | 0.0405 |  |  |  | PowerUp | Int | Aux | I/O | Aux_io | Bram | Avcc | Avtt | GTVccaux
 |  |  |  |  |  |  |  |  | Q-Grade | 0.1883 |  |  |  | Adder | 0.6 | 0.08 | 0.04 | 0.04 | 0.04 | 0.4 | 0.15 | 0.04
 |  |  |  |  |  |  |  |  | Vcc_c1 | 0.0794 |  |  |  | Min | 0 | 0 | 0 | 0 | 0 | 0 | 0 | 0
 |  |  |  |  |  |  |  |  | Vcc_c2 | 2.5327
 |  |  |  |  |  |  |  |  | VccScale | 0.9994
 |  |  |  |  |  |  |  |  | VccAuxScale | 1
 |  |  |  |  |  |  |  |  | VccBramScale | 0.9994
 |  |  |  |  |  |  |  |  | AVccScale | 0.9994
 |  |  |  |  |  |  |  |  | Max bram | 0
 |  |  |  |  |  |  |  |  | Max PS | 0
 |  |  |  |  |  |  |  |  | Max Aux | 0.1811996551
 |  |  |  |  |  |  |  |  | Max Int | 1.380390573
 |  |  |  |  |  |  |  |  | Max Ambient | 97.16789917
 |  |  |  |  |  |  |  |  | AuxSpecialFact | 1
 |  |  |  |  |  |  |  |  | Oly | 0

Sheet: Snapshot
 | Power Comparison Snapshots
Settings
Part
Ambient Temperature
Process
Implementation
Summary
Total On-Chip Power
Junction Temperature
Effective ΘJA
On-Chip Power
Clocking
Logic
I/O
BRAM
DSP
Transceiver
PS
Device Static
Supply Summary
VCCINT
VCCBRAM
VCCAUX
VCCAUX_IO
VCCO 3.3V
VCCO 2.5V
VCCO 1.8V
VCCO 1.5V
VCCO 1.35V
VCCO 1.2V
MGTVCCAUX
MGTAVCC
MGTAVTT
MGTZVCCH
MGTZAVCC
MGTZVCCL
VCCPINT
VCCPAUX
VCCPLL
VCCO_DDR
VCCO_MIO0
VCCO_MIO1
VCCADC

Sheet: Graphs
On-Chip Power over Vccint - (Typical, 25C)
On-Chip Power - (Typical, 1V)
On-Chip Power by Function - (Typical, 1V, 25C)

Sheet: IP_Manager
IP Manager |  |  |  |  |  |  |  |  |  | IP Catalog
 |  |  |  |  |  |  |  |  |  | Block Memory
Device |  |  | On-Chip Summary |  |  |  |  |  |  | Distributed Memory
Part | XC7K325TFBG900-2LE |  | Junction Temp |  | 25.3 °C |  |  |  |  | Memory Interface
Process | Typical |  | Static Power |  | 0.156 W |  |  |  |  | Transceiver Interface
Effective ΘJA | 1.8 °C/W |  | Total Power |  | 0.156 W
Implementation | Power Optimization
IP Modules |  | Power (W) | Clocking* | Logic | I/O* | BRAM | DSP | Transceiver* | Source | Clock | PLL | MMCM | Logic | I/O | Phaser | BRAM | DSP | PCIE | GTP/X/H | GTZ
29

Sheet: Clock
Clock Tree Power |  |  |  |  |  |  |  |  |  |  |  |  | 1288 | 32 | 30 | 20
Power |  |  |  | Utilization |  |  |  | Clocking Resources User Guide (http://www.xilinx.com/support/documentation/user_guides/ug472_7Series_Clocking.pdf)
VCCINT | 1.000V | 0.000W |  | Global | 0 | 0%
0% of total on-chip power 0.000W |  |  |  | Regional | 0 | 0% |  | XPE User Guide (http://www.xilinx.com/cgi-bin/docs/rdoc?l=en;v=latest;d=ug440-xilinx-power-estimator.pdf)
 |  |  |  | I/O | 0 | 0%
 |  |  |  | Other | 0 | - |  | Introduction to XPE (video) (http://www.xilinx.com/training/vivado/using-the-xilinx-power-estimator.htm)
Name |  |  | Frequency (MHz) | Type | Fanout | Clock Buffer Enable | Slice Clock Enable | Power (W) |  | HROW | LEAF | Local | HROW Utilization | LEAF Utilization | Slices
 |  |  |  | Global |  | 100% | 50% | 0.000 | 0 | 0 | 0 | 0 | 0 | 0 | 0
 |  |  |  | Global |  | 100% | 50% | 0.000 | 0 | 0 | 0 | 0 | 0 | 0 | 0
 |  |  |  | Global |  | 100% | 50% | 0.000 | 0 | 0 | 0 | 0 | 0 | 0 | 0
 |  |  |  | Global |  | 100% | 50% | 0.000 | 0 | 0 | 0 | 0 | 0 | 0 | 0
 |  |  |  | Global |  | 100% | 50% | 0.000 | 0 | 0 | 0 | 0 | 0 | 0 | 0
 |  |  |  | Global |  | 100% | 50% | 0.000 | 0 | 0 | 0 | 0 | 0 | 0 | 0
 |  |  |  | Global |  | 100% | 50% | 0.000 | 0 | 0 | 0 | 0 | 0 | 0 | 0
 |  |  |  | Global |  | 100% | 50% | 0.000 | 0 | 0 | 0 | 0 | 0 | 0 | 0
 |  |  |  | Global |  | 100% | 50% | 0.000 | 0 | 0 | 0 | 0 | 0 | 0 | 0
 |  |  |  | Global |  | 100% | 50% | 0.000 | 0 | 0 | 0 | 0 | 0 | 0 | 0
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
 |  |  |  | Global |  | 100% | 50% | 0.000 | 0 | 0 | 0 | 0 | 0 | 0 | 0
 |  |  |  | Global |  | 100% | 50% | 0.000 | 0 | 0 | 0 | 0 | 0 | 0 | 0
 |  |  |  | Global |  | 100% | 50% | 0.000 | 0 | 0 | 0 | 0 | 0 | 0 | 0
 |  |  |  | Global |  | 100% | 50% | 0.000 | 0 | 0 | 0 | 0 | 0 | 0 | 0
191

Sheet: Logic
Logic Power
Power |  |  |  | Utilization |  |  |  |  | CLB User Guide (http://www.xilinx.com/support/documentation/user_guides/ug474_7Series_CLB.pdf)
VCCINT | 1.000V | 0.000W |  | Registers |  | 0 | 0%
0% of total on-chip power 0.000W |  |  |  | LUTs |  | 0 | 0% |  | XPE User Guide (http://www.xilinx.com/cgi-bin/docs/rdoc?l=en;v=latest;d=ug440-xilinx-power-estimator.pdf)
 |  |  |  | Combinatorial |  | 0 | 0%
 |  |  |  | Shift Registers |  | 0 | 0% |  | Introduction to XPE (video) (http://www.xilinx.com/training/vivado/using-the-xilinx-power-estimator.htm)
 |  |  |  | Distributed RAMs |  | 0
Name |  |  | Clock (MHz) | LUTs as |  |  | Registers | Toggle Rate | Average Fanout | Signal Rate (Mtr/s) | Power (W) | Routing
 |  |  |  | Logic | Shift Registers | Distributed RAMs
 |  |  |  |  |  |  |  | 12.5% | 3.00 | 0.0 | 0.000 | 0.0003987701
 |  |  |  |  |  |  |  | 12.5% | 3.00 | 0.0 | 0.000 | 0.0003987701
 |  |  |  |  |  |  |  | 12.5% | 3.00 | 0.0 | 0.000 | 0.0003987701
 |  |  |  |  |  |  |  | 12.5% | 3.00 | 0.0 | 0.000 | 0.0003987701
 |  |  |  |  |  |  |  | 12.5% | 3.00 | 0.0 | 0.000 | 0.0003987701
 |  |  |  |  |  |  |  | 12.5% | 3.00 | 0.0 | 0.000 | 0.0003987701
 |  |  |  |  |  |  |  | 12.5% | 3.00 | 0.0 | 0.000 | 0.0003987701
 |  |  |  |  |  |  |  | 12.5% | 3.00 | 0.0 | 0.000 | 0.0003987701
 |  |  |  |  |  |  |  | 12.5% | 3.00 | 0.0 | 0.000 | 0.0003987701
 |  |  |  |  |  |  |  | 12.5% | 3.00 | 0.0 | 0.000 | 0.0003987701
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
 |  |  |  |  |  |  |  | 12.5% | 3.00 | 0.0 | 0.000 | 0.0003987701
 |  |  |  |  |  |  |  | 12.5% | 3.00 | 0.0 | 0.000 | 0.0003987701
 |  |  |  |  |  |  |  | 12.5% | 3.00 | 0.0 | 0.000 | 0.0003987701
 |  |  |  |  |  |  |  | 12.5% | 3.00 | 0.0 | 0.000 | 0.0003987701
 |  |  |  |  |  |  |  | 12.5% | 3.00 | 0.0 | 0.000 | 0.0003987701
 |  |  |  |  |  |  |  | 12.5% | 3.00 | 0.0 | 0.000 | 0.0003987701
 |  |  |  |  |  |  |  | 12.5% | 3.00 | 0.0 | 0.000 | 0.0003987701
 |  |  |  |  |  |  |  | 12.5% | 3.00 | 0.0 | 0.000 | 0.0003987701
 |  |  |  |  |  |  |  | 12.5% | 3.00 | 0.0 | 0.000 | 0.0003987701
 |  |  |  |  |  |  |  | 12.5% | 3.00 | 0.0 | 0.000 | 0.0003987701
 |  |  |  |  |  |  |  | 12.5% | 3.00 | 0.0 | 0.000 | 0.0003987701
 |  |  |  |  |  |  |  | 12.5% | 3.00 | 0.0 | 0.000 | 0.0003987701
 |  |  |  |  |  |  |  | 12.5% | 3.00 | 0.0 | 0.000 | 0.0003987701
 |  |  |  |  |  |  |  | 12.5% | 3.00 | 0.0 | 0.000 | 0.0003987701

Sheet: GTX
GTX Transceiver Power |  |  |  |  |  |  |  |  |  |  |  |  |  |  |  |  |  |  |  |  |  |  |  |  | 1 | 6.6 |  | CPLL VCO range (MHz) | LC VCO range (MHz) |  |  | Raised Voltage |  |  |  |  |  |  |  |  |  |  |  | AV2:AV17
 |  |  |  |  |  |  |  |  |  |  |  |  |  |  |  |  |  |  |  |  |  |  |  |  |  |  |  | 1.2 | 5.93 | 9.8 |  | 0 |  |  |  |  |  |  |  |  |  |  | PCIe |  | 250 | 269
Active Current |  |  |  | Power |  |  |  |  | 0.000W |  | Utilization |  |  |  |  |  |  | Transceivers User Guide (http://www.xilinx.com/support/documentation/user_guides/ug476_7Series_Transceivers.pdf) |  |  |  |  |  |  | Iccq | 0 |  | 3.3 | 8 | 12.5 |  |  |  |  |  |  |  |  |  |  |  |  |  |  | 300 | 336
Source |  | Active |  |  |  |  |  |  |  |  | GTX Channels |  | 0 | 0% |  |  |  |  |  |  |  |  |  |  |  |  |  |  |  |  |  |  |  |  |  |  |  |  |  |  |  |  |  |  | 350 | 407
VCCINT | 1.000V | 0.000A |  | Source | Power |  | PCIe | PCS | PMA |  | PCIe Blocks |  | 0 | 0% |  |  |  | XPE User Guide (http://www.xilinx.com/cgi-bin/docs/rdoc?l=en;v=latest;d=ug440-xilinx-power-estimator.pdf) |  |  |  |  |  |  |  |  |  |  |  |  |  |  |  |  |  |  |  |  |  |  |  |  |  |  | 400 | 474
MGTVCCAUX | 1.800V | 0.000A |  | VCCINT | 0.000W |  | 0.000W | 0.000W | 0.000W |  |  |  |  |  |  |  |  |  |  |  |  |  |  |  |  |  |  |  |  |  |  |  |  |  |  |  |  |  |  |  |  |  |  |  | 450 | 543
MGTAVCC | 1.000V | 0.000A |  | MGTVCCAUX | 0.000W |  |  |  |  |  | Power Planes |  | 0 |  |  |  |  | Introduction to XPE (video) (http://www.xilinx.com/training/vivado/using-the-xilinx-power-estimator.htm) |  |  |  |  |  |  |  |  |  |  |  |  |  |  |  |  |  |  |  |  |  |  |  |  |  |  | 500 | 609
MGTAVTT | 1.200V | 0.000A |  | MGTAVCC | 0.000W |  |  |  |  |  |  |  |  |  |  |  |  |  |  |  |  |  |  |  |  |  |  |  |  |  |  |  |  |  |  |  |  |  |  |  |  |  |  |  | 550 | 677
 |  |  |  | MGTAVTT | 0.000W | 0% of total on-chip power 0.000W |  |  |  |  |  |  |  |  |  |  |  |  |  |  |  |  |  |  |  |  |  |  |  |  |  |  |  |  |  |  |  |  |  |  |  |  |  |  | 600 | 741
 |  |  |  |  |  |  |  |  |  |  |  |  |  |  |  |  |  |  |  |  |  |  |  |  |  |  |  |  |  |  |  |  |  |  |  |  |  |  |  |  |  |  |  |  | 650 | 807
 |  |  |  |  |  |  |  | RX |  |  |  | TX |  |  |  |  |  |  |  |  |  |  |  |  |  |  |  |  |  |  |  |  |  |  |  |  |  |  |  |  |  |  |  |  | 700 | 866
Name |  |  | GTX Channels | Operational Mode | EyeScan | Power Mode | Channels Sharing QPLL | Clock Source | Data Rate (Gb/s) | Data Path | Data Mode | Clock Source | Data Rate (Gb/s) | Data Path | Data Mode | O/P (mV) | OOB Used | Hard PCIe | VCCINT Power (W) | MGTVCCAUX Power (W) | MGTAVCC Power (W) | MGTAVTT Power (W) |  | Operate Mode | Quads | RX VCO LC (MHz) | TX VCO LC (MHz) | RX VCO CPLL (MHz) | TX VCO CPLL (MHz) | RX USERCLK | TX USERCLK | RX Power Mode | TX Voltage Swing Current | AVTT Current (CPLL) | AVTT Current (LC) | AVCC Current (RX) | AVCC Current (TX) | AVCC Current (CPLL) | AVCC Current (LC) | AVCC CLK | AVTT CLK |  |  | PCIe | 750 | 924
 |  |  |  | Transceiver | Off | Low Power | 4 | QPLL | 5.0000 | 32 | 8b/10b | QPLL | 5.0000 | 32 | 8b/10b | 269 | No |  | 0.000 | 0.000 | 0.000 | 0.000 |  | 3 | 0 | 10000 | 10000 | 2500 | 2500 | 125 | 125 | 0 | 5.575 | 0 | 7.579332025 | 53.875 | 43.53733333 | 0 | 16.46694215 | 25.6 | 1.55 | 10 | 10 | 0 | 800 | 973
 |  |  |  | Transceiver | Off | Low Power | 4 | QPLL | 5.0000 | 32 | 8b/10b | QPLL | 5.0000 | 32 | 8b/10b | 269 | No |  | 0.000 | 0.000 | 0.000 | 0.000 |  | 3 | 0 | 10000 | 10000 | 2500 | 2500 | 125 | 125 | 0 | 5.575 | 0 | 7.579332025 | 53.875 | 43.53733333 | 0 | 16.46694215 | 25.6 | 1.55 | 10 | 10 | 0 | 850 | 1018
 |  |  |  | Transceiver | Off | Low Power | 4 | QPLL | 5.0000 | 32 | 8b/10b | QPLL | 5.0000 | 32 | 8b/10b | 269 | No |  | 0.000 | 0.000 | 0.000 | 0.000 |  | 3 | 0 | 10000 | 10000 | 2500 | 2500 | 125 | 125 | 0 | 5.575 | 0 | 7.579332025 | 53.875 | 43.53733333 | 0 | 16.46694215 | 25.6 | 1.55 | 10 | 10 | 0 | 900 | 1056
 |  |  |  | Transceiver | Off | Low Power | 4 | QPLL | 5.0000 | 32 | 8b/10b | QPLL | 5.0000 | 32 | 8b/10b | 269 | No |  | 0.000 | 0.000 | 0.000 | 0.000 |  | 3 | 0 | 10000 | 10000 | 2500 | 2500 | 125 | 125 | 0 | 5.575 | 0 | 7.579332025 | 53.875 | 43.53733333 | 0 | 16.46694215 | 25.6 | 1.55 | 10 | 10 | 0 | 950 | 1092
 |  |  |  | Transceiver | Off | Low Power | 4 | QPLL | 5.0000 | 32 | 8b/10b | QPLL | 5.0000 | 32 | 8b/10b | 269 | No |  | 0.000 | 0.000 | 0.000 | 0.000 |  | 3 | 0 | 10000 | 10000 | 2500 | 2500 | 125 | 125 | 0 | 5.575 | 0 | 7.579332025 | 53.875 | 43.53733333 | 0 | 16.46694215 | 25.6 | 1.55 | 10 | 10 | 0 | 1000 | 1119
 |  |  |  | Transceiver | Off | Low Power | 4 | QPLL | 5.0000 | 32 | 8b/10b | QPLL | 5.0000 | 32 | 8b/10b | 269 | No |  | 0.000 | 0.000 | 0.000 | 0.000 |  | 3 | 0 | 10000 | 10000 | 2500 | 2500 | 125 | 125 | 0 | 5.575 | 0 | 7.579332025 | 53.875 | 43.53733333 | 0 | 16.46694215 | 25.6 | 1.55 | 10 | 10 | 0
 |  |  |  | Transceiver | Off | Low Power | 4 | QPLL | 5.0000 | 32 | 8b/10b | QPLL | 5.0000 | 32 | 8b/10b | 269 | No |  | 0.000 | 0.000 | 0.000 | 0.000 |  | 3 | 0 | 10000 | 10000 | 2500 | 2500 | 125 | 125 | 0 | 5.575 | 0 | 7.579332025 | 53.875 | 43.53733333 | 0 | 16.46694215 | 25.6 | 1.55 | 10 | 10 | 0
 |  |  |  | Transceiver | Off | Low Power | 4 | QPLL | 5.0000 | 32 | 8b/10b | QPLL | 5.0000 | 32 | 8b/10b | 269 | No |  | 0.000 | 0.000 | 0.000 | 0.000 |  | 3 | 0 | 10000 | 10000 | 2500 | 2500 | 125 | 125 | 0 | 5.575 | 0 | 7.579332025 | 53.875 | 43.53733333 | 0 | 16.46694215 | 25.6 | 1.55 | 10 | 10 | 0
 |  |  |  | Transceiver | Off | Low Power | 4 | QPLL | 5.0000 | 32 | 8b/10b | QPLL | 5.0000 | 32 | 8b/10b | 269 | No |  | 0.000 | 0.000 | 0.000 | 0.000 |  | 3 | 0 | 10000 | 10000 | 2500 | 2500 | 125 | 125 | 0 | 5.575 | 0 | 7.579332025 | 53.875 | 43.53733333 | 0 | 16.46694215 | 25.6 | 1.55 | 10 | 10 | 0
 |  |  |  | Transceiver | Off | Low Power | 4 | QPLL | 5.0000 | 32 | 8b/10b | QPLL | 5.0000 | 32 | 8b/10b | 269 | No |  | 0.000 | 0.000 | 0.000 | 0.000 |  | 3 | 0 | 10000 | 10000 | 2500 | 2500 | 125 | 125 | 0 | 5.575 | 0 | 7.579332025 | 53.875 | 43.53733333 | 0 | 16.46694215 | 25.6 | 1.55 | 10 | 10 | 0
 |  |  |  | Transceiver | Off | Low Power | 4 | QPLL | 5.0000 | 32 | 8b/10b | QPLL | 5.0000 | 32 | 8b/10b | 269 | No |  | 0.000 | 0.000 | 0.000 | 0.000 |  | 3 | 0 | 10000 | 10000 | 2500 | 2500 | 125 | 125 | 0 | 5.575 | 0 | 7.579332025 | 53.875 | 43.53733333 | 0 | 16.46694215 | 25.6 | 1.55 | 10 | 10 | 0
 |  |  |  | Transceiver | Off | Low Power | 4 | QPLL | 5.0000 | 32 | 8b/10b | QPLL | 5.0000 | 32 | 8b/10b | 269 | No |  | 0.000 | 0.000 | 0.000 | 0.000 |  | 3 | 0 | 10000 | 10000 | 2500 | 2500 | 125 | 125 | 0 | 5.575 | 0 | 7.579332025 | 53.875 | 43.53733333 | 0 | 16.46694215 | 25.6 | 1.55 | 10 | 10 | 0
 |  |  |  | Transceiver | Off | Low Power | 4 | QPLL | 5.0000 | 32 | 8b/10b | QPLL | 5.0000 | 32 | 8b/10b | 269 | No |  | 0.000 | 0.000 | 0.000 | 0.000 |  | 3 | 0 | 10000 | 10000 | 2500 | 2500 | 125 | 125 | 0 | 5.575 | 0 | 7.579332025 | 53.875 | 43.53733333 | 0 | 16.46694215 | 25.6 | 1.55 | 10 | 10 | 0
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
 |  |  |  |  |  |  |  |  |  |  | Quads |  | 0 | MMF |  | x^4 | x^3 | x^2 | x | c
 |  |  |  |  |  |  |  |  |  |  | AVCCQ | 0 | 0 | 1.505 |  | 7.55266329e-08 | 5.467265515e-06 | 0.0004180628965 | 0.02142175782 | 0.3702050912 | 0.215 | 4.8939 | 1
 |  |  |  |  |  |  |  |  |  |  | AVTTQ | 0 | 0 | 1 |  | 1.018212675e-08 | -1.672192001e-08 | 4.392168573e-06 | 0.0008287392698 | 2.499111411 | 2.0991 | -1.5161 | 1.00282
 |  |  |  |  |  |  |  |  |  |  | AUXQ | 0 | 0 | 1 |  | 6.486095011e-09 | -2.849264878e-07 | -3.2614894e-06 | 0.0006093395067 | -0.004597126203
 |  |  |  |  |  |  |  |  |  |  |  |  | 0 | 0
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
