OmarLopezCabrera/Tesis-SDR-LAPAC-Open-Source/Info Componentes/AD9364/AD9361_BlockDiagram.png

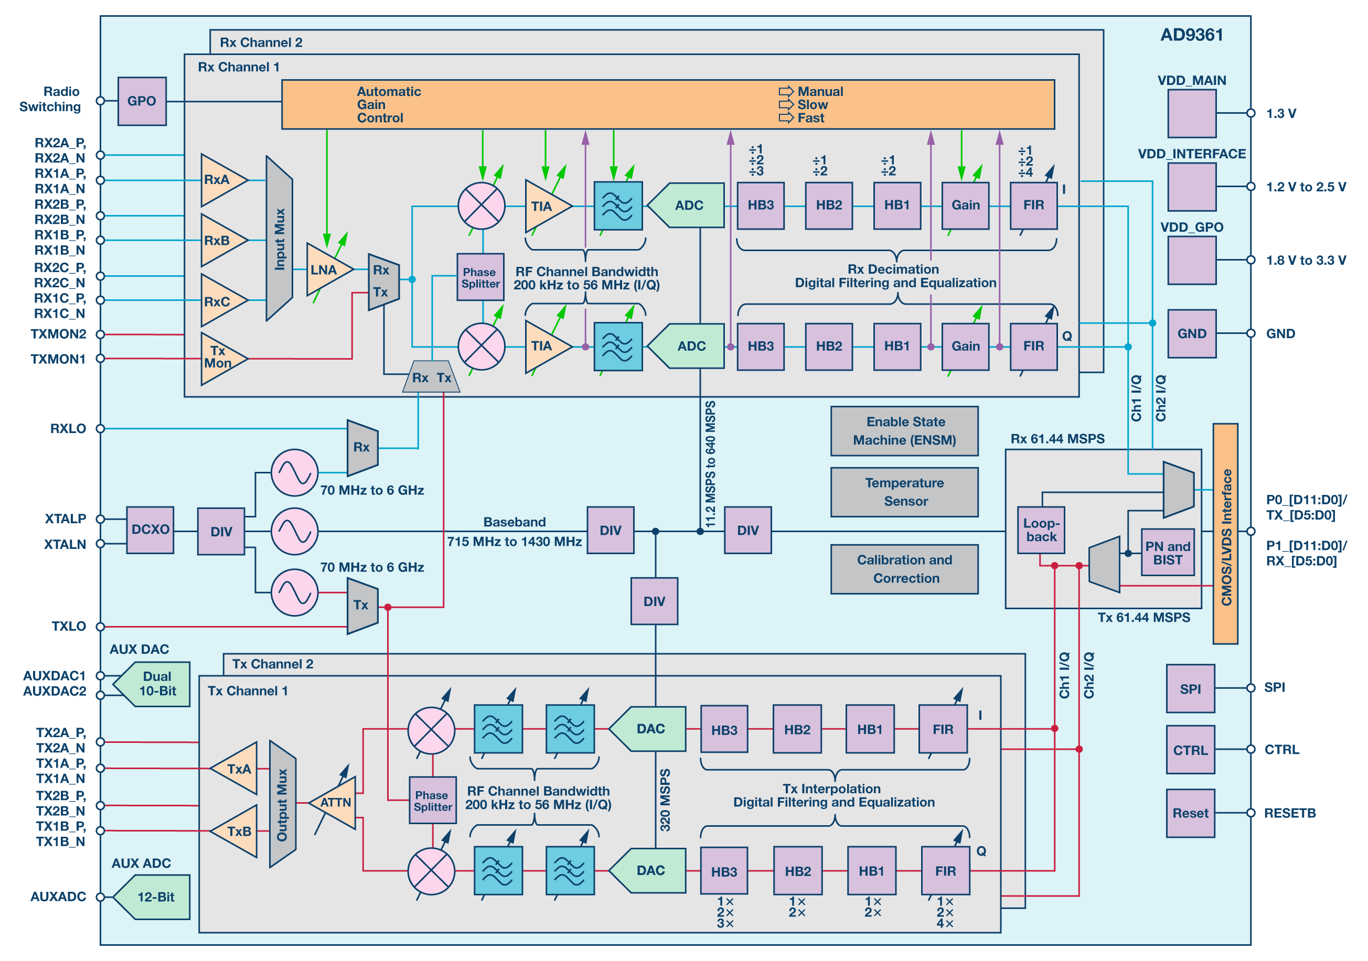
Info Componentes/AD9364/AD9361_BlockDiagram.png
