OmarLopezCabrera/Tesis-SDR-LAPAC-Open-Source/Info Componentes/Power/ADP5054/BOM.png

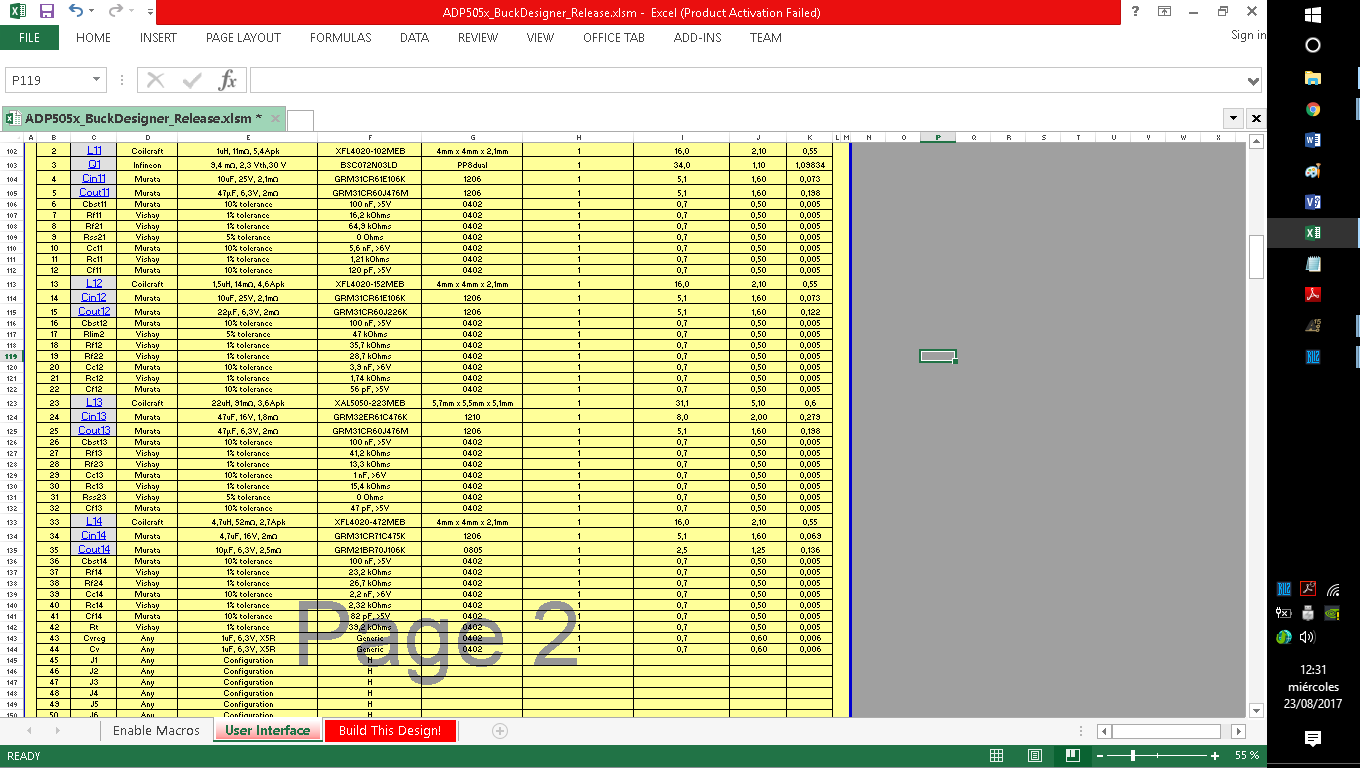
Info Componentes/Power/ADP5054/BOM.png
