OmarLopezCabrera/Tesis-SDR-LAPAC-Open-Source/Info Componentes/Power/ADP5054/Diagrama.png

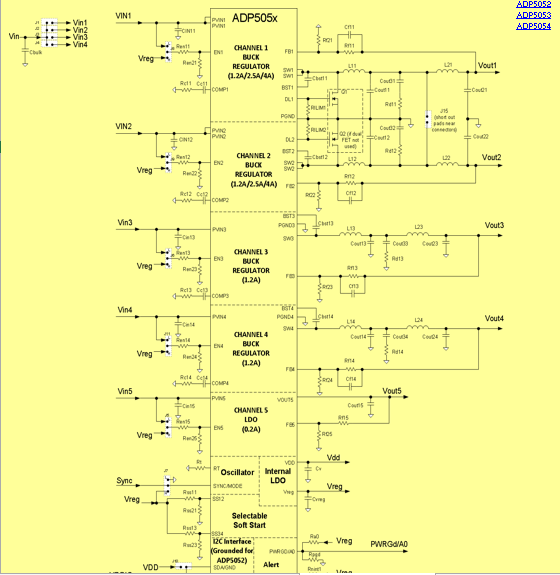
Info Componentes/Power/ADP5054/Diagrama.png
