OmarLopezCabrera/Tesis-SDR-LAPAC-Open-Source/Info Componentes/Power/ADP5054/PCB2.png

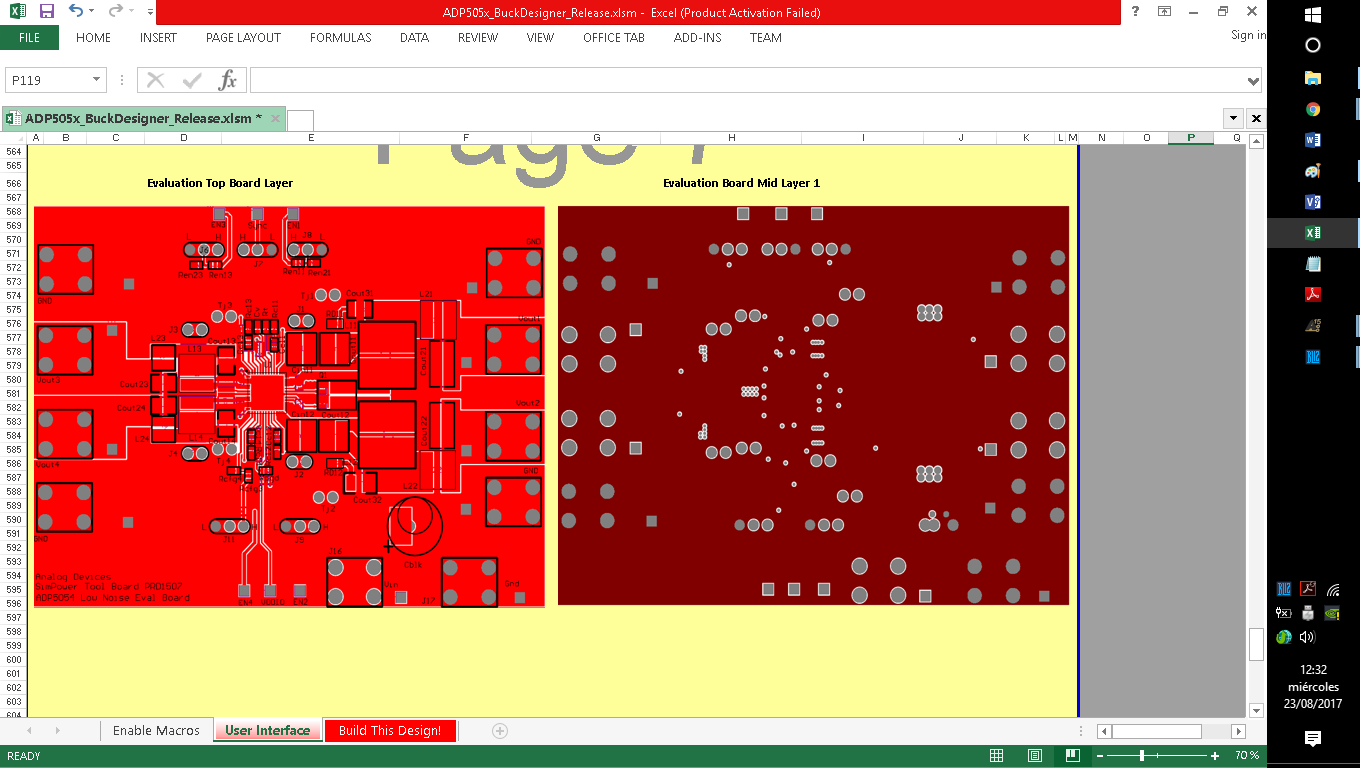
Info Componentes/Power/ADP5054/PCB2.png
