OmarLopezCabrera/Tesis-SDR-LAPAC-Open-Source/Info Componentes/Power/ADP5054/PCB3.png

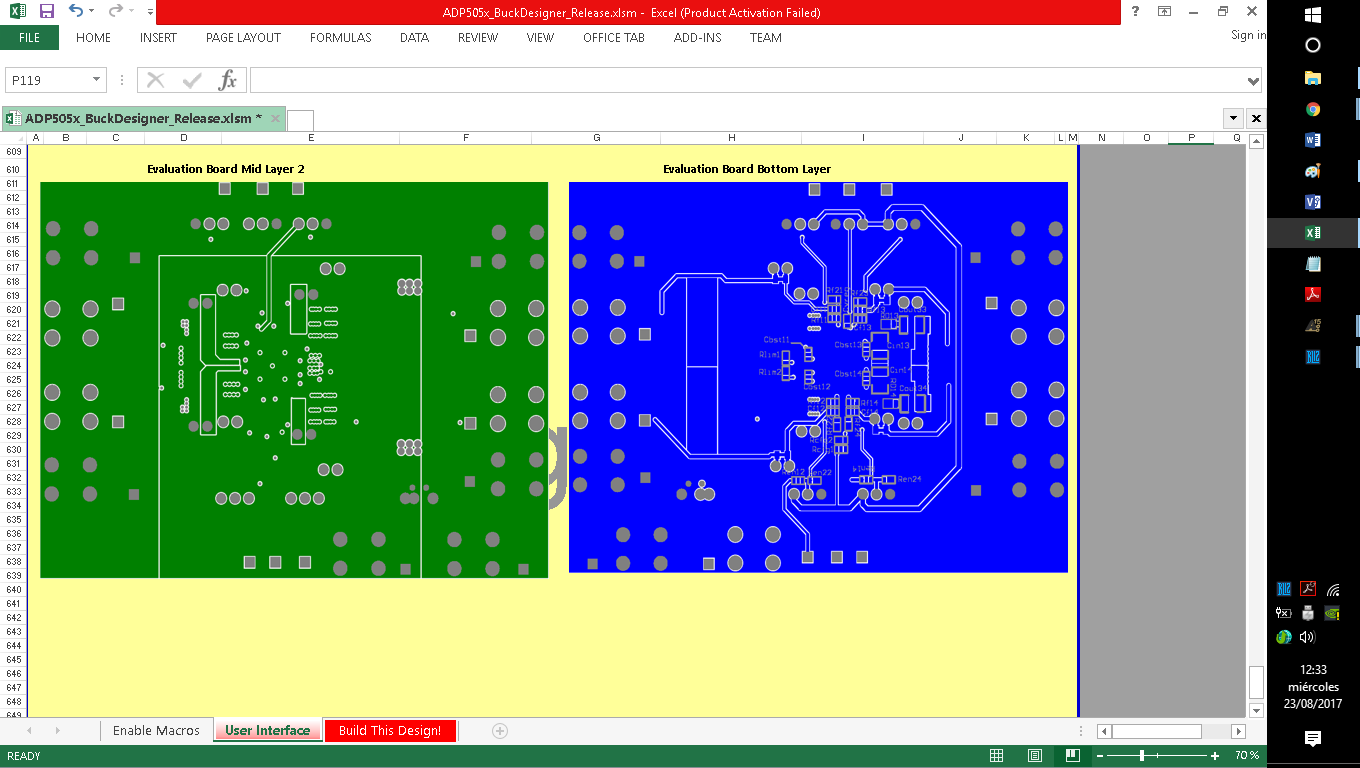
Info Componentes/Power/ADP5054/PCB3.png
