OmarLopezCabrera/Tesis-SDR-LAPAC-Open-Source/Info Componentes/AD9364/dr-1420701636.pdf

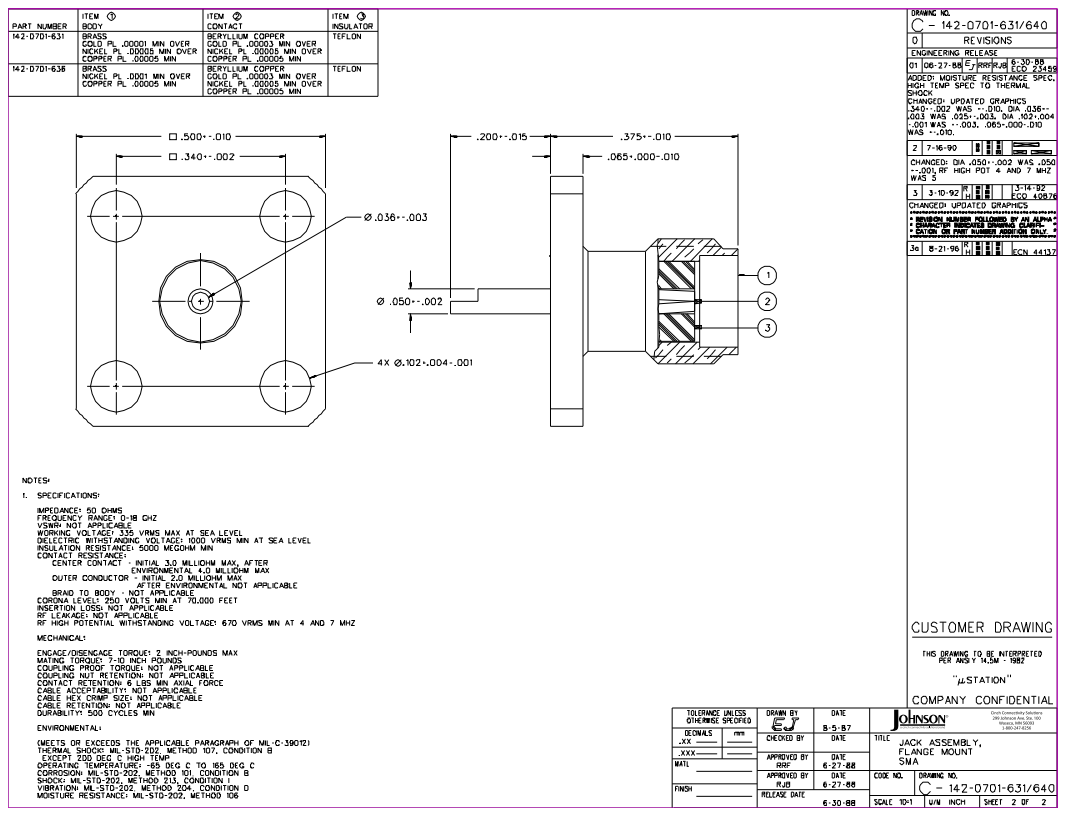
[picture p76: page 1]
UNCONTROLLED COPY
