OmarLopezCabrera/Tesis-SDR-LAPAC-Open-Source/Info Componentes/AD9364/RF/98-pl313(landPattern).pdf

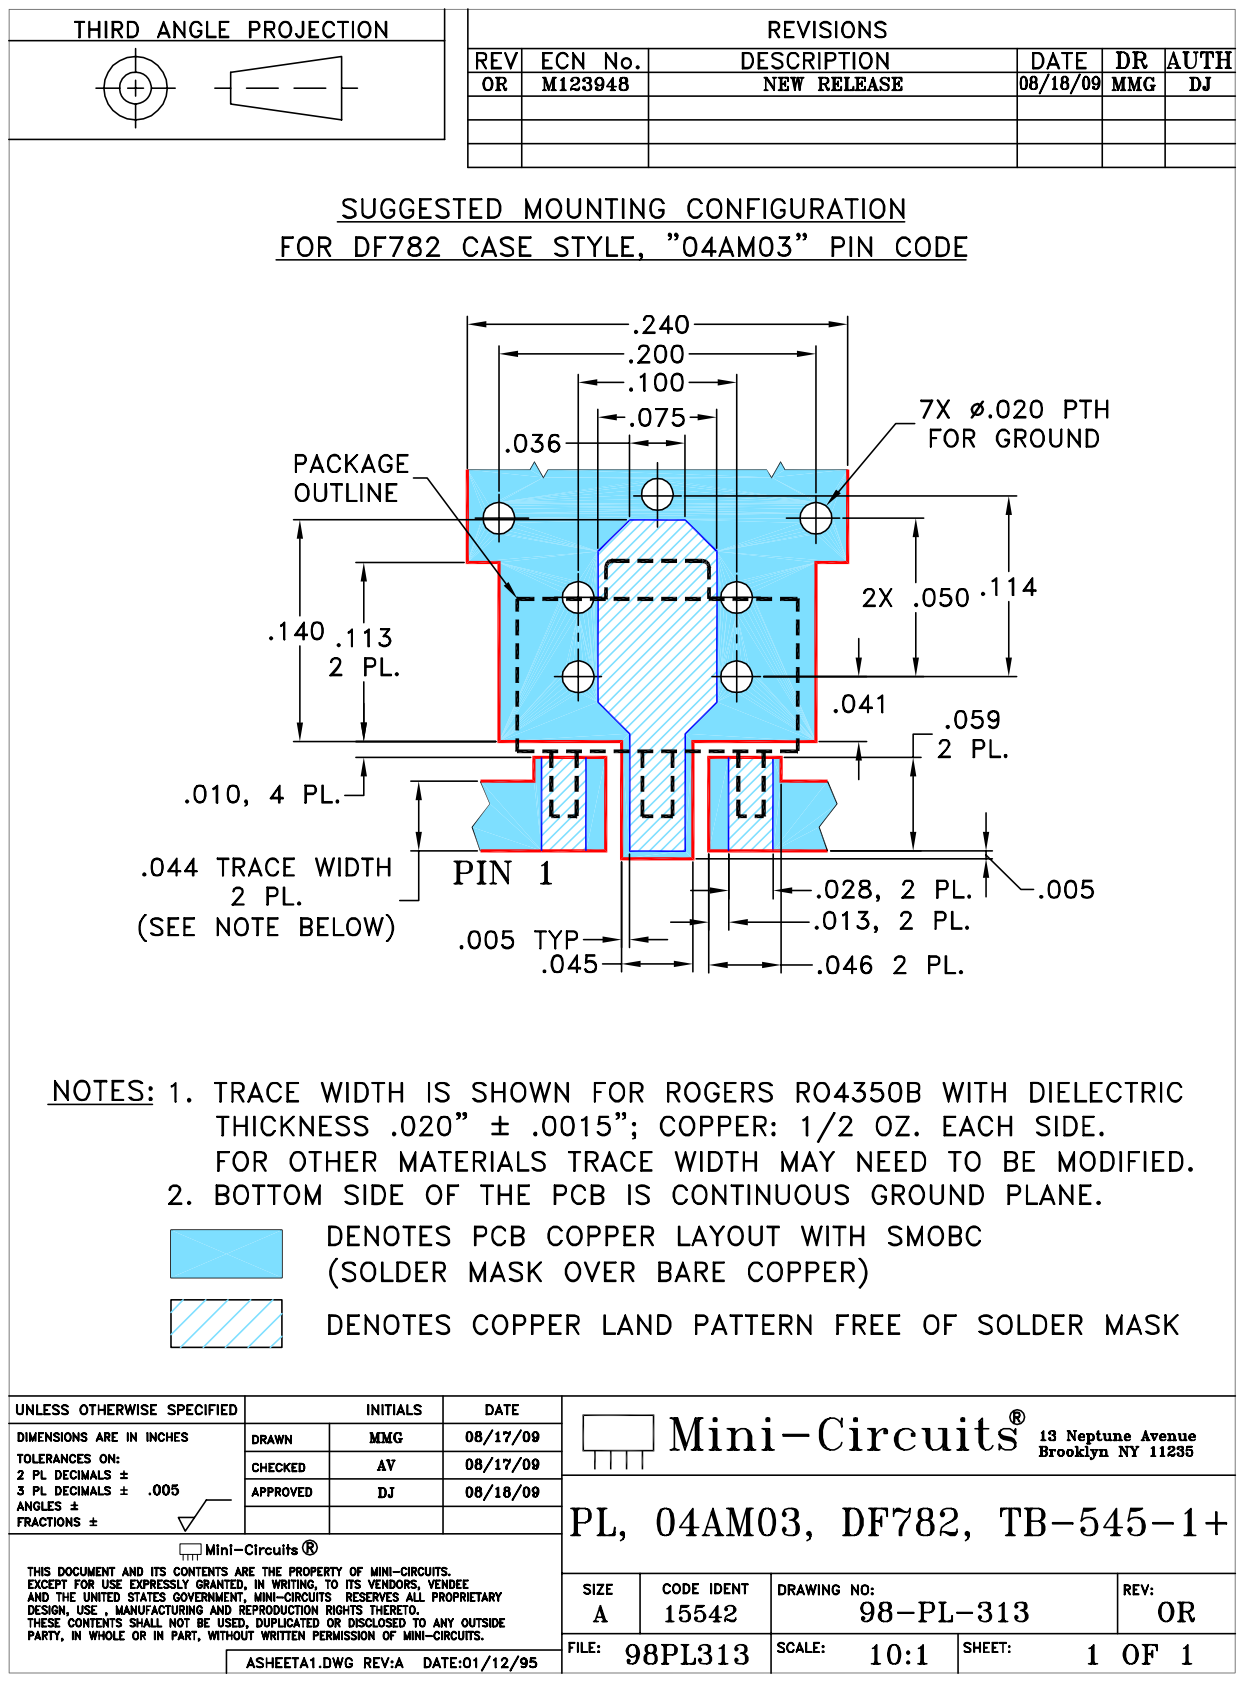
[picture p77: page 1]
