OmarLopezCabrera/Tesis-SDR-LAPAC-Open-Source/Simulaciones/Power/Simulacion_Power.asc

C1: cap; 0.0039µ; V=100 Irms=0 Rser=0 Lser=0 mfg="Murata" pn="GCM155R72A392JA37" type="X7R"
C2: cap; 0.1µ; V=25 Irms=0 Rser=0 Lser=0 mfg="Murata" pn="GCM155R71E104KE02" type="X7R"
C3: cap; 100µ; V=2.5 Irms=0 Rser=0 Lser=0 mfg="Murata" pn="GRM21BR60E107ME15" type="X5R"
C4: cap; 220p; V=50 Irms=0 Rser=0 Lser=0 mfg="Murata" pn="GCM155R71H221JA37" type="X7R"
C5: cap; 0.0033µ; V=50 Irms=0 Rser=0 Lser=0 mfg="Murata" pn="GCM155R71H332JA37" type="X7R"
C6: cap; 0.1µ; V=10 Irms=0 Rser=0 Lser=0 mfg="Murata" pn="GCM155R71A104KA55" type="X7R"
C7: cap; 100µ; V=2.5 Irms=0 Rser=0 Lser=0 mfg="Murata" pn="GRM21BR60E107ME15" type="X5R"
C8: cap; 100p; V=50 Irms=0 Rser=0 Lser=0 mfg="Murata" pn="GCM1555C1H101JA16" type="C0G"
C9: cap; 0.0033µ; V=50 Irms=0 Rser=0 Lser=0 mfg="Murata" pn="GCM155R71H332JA37" type="X7R"
C10: cap; 0.1µ; V=25 Irms=0 Rser=0 Lser=0 mfg="Murata" pn="GCM155R71E104KE02" type="X7R"
C11: cap; 10µ; V=2.5 Irms=0 Rser=0 Lser=0 mfg="Murata" pn="GRM155R60E106ME16" type="X5R"
C12: cap; 82p; V=50 Irms=0 Rser=0 Lser=0 mfg="Murata" pn="GCM1555C1H820JA16" type="C0G"
C13: cap; 0.0047µ; V=50 Irms=0 Rser=0 Lser=0 mfg="Murata" pn="GCM155R71H472JA37" type="X7R"
C14: cap; 0.1µ; V=10 Irms=0 Rser=0 Lser=0 mfg="Murata" pn="GCM155R71A104KA55" type="X7R"
C15: cap; 22µ; V=2.5 Irms=0 Rser=0 Lser=0 mfg="Murata" pn="GRM188R60E226ME16" type="X5R"
C16: cap; 180p; V=25 Irms=0 Rser=0 Lser=0 mfg="Murata" pn="GRM0335C1E181JA01" type="C0G"
C17: cap; 22µ; V=2.5 Irms=0 Rser=0 Lser=0 mfg="Murata" pn="GRM188R60E226ME16" type="X5R"
C18: cap; 0.1µ
C19: cap; 10µ
C20: cap; 10µ
C21: cap; 0.1µ
C22: cap; 0.1µ
C23: cap; 1µ
C24: cap; 47µ
C25: cap; 0.1µ
C26: cap; 0.1µ
D1: schottky; RB056L-40
L1: ind; 1.5µ; Ipk=4.6 Rser=0.0144 Rpar=141.3 Cpar=0 mfg="Coilcraft" pn="XFL4020-152"
L2: ind; 1.5µ; Ipk=4.6 Rser=0.0144 Rpar=141.3 Cpar=0 mfg="Coilcraft" pn="XFL4020-152"
L3: ind; 15µ; Ipk=3.7 Rser=0.0697 Rpar=1413 Cpar=0 mfg="Coilcraft" pn="XAL5050-153"
L4: ind; 6.8µ; Ipk=14.13 Rser=0.0132 Rpar=640.56 Cpar=0 mfg="Coilcraft" pn="XAL8080-682"
L5: ind; 470n; Ipk=3.4 Rser=0.03 Rpar=0 Cpar=0 mfg="Murata" pn="LQH32PNR47NN0"
L6: ind; 2.2µ; Ipk=3.7 Rser=0.02135 Rpar=207.24 Cpar=0 mfg="Coilcraft" pn="XFL4020-222"
M1: nmos; BSC072N03LD
M2: nmos; BSC072N03LD
M4: pmos
R1: res; 68.1K; tol=1 pwr=0.1
R2: res; 4.42K; tol=1 pwr=0.1
R3: res; 16.2K; tol=1 pwr=0.1
R4: res; 64.9K; tol=1 pwr=0.1
R5: res; 68.1K; tol=1 pwr=0.1
R6: res; 3.32K; tol=1 pwr=0.1
R7: res; 35.7K; tol=1 pwr=0.1
R8: res; 28.7k
R9: res; 68.1K; tol=1 pwr=0.1
R10: res; 2.37K; tol=1 pwr=0.1
R11: res; 41.2K; tol=1 pwr=0.1
R12: res; 13.3k
R13: res; 68.1K; tol=1 pwr=0.1
R14: res; 1.69K; tol=1 pwr=0.1
R15: res; 19.6K; tol=1 pwr=0.1
R16: res; 28.7k
R17: res; 470K
R18: res; 10
R19: res; 20k
R20: res; 10k
R21: res; 3K
R22: res; 2K
U1: ADP5054_chan1_2
U2: ADP5054_chan1_2
U3: ADP5050_chan3_4
U4: ADP5050_chan3_4
U5: LTC4412
U6: ADP2164
V3: voltage; 5V
V4: voltage; 12V
Named nets: Vsys, 0, 1V, 1.8V, 3.3V, 1.35V, VIN, 1.8VAD9346
.tran 0 10 0 1 steady startup nodiscard uic
