OmarLopezCabrera/Tesis-SDR-LAPAC-Open-Source/(list of files, drawings)

Other design files:
Proyecto Altium/AD9364_Interface.SchDoc
Proyecto Altium/AD9364_RF.SchDoc
Proyecto Altium/FPGA.SchDoc
Proyecto Altium/GPIO.SchDoc
Proyecto Altium/Intro.SchDoc
Proyecto Altium/Memory.SchDoc
Proyecto Altium/Power.SchDoc
Proyecto Altium/SDR_LAPAC1/24LC256.PcbLib
Proyecto Altium/SDR_LAPAC1/AD9364.PcbLib
Proyecto Altium/SDR_LAPAC1/ADP1755A.PcbLib
Proyecto Altium/SDR_LAPAC1/ADP2164.PcbLib
Proyecto Altium/SDR_LAPAC1/adp5054.PcbLib
Proyecto Altium/SDR_LAPAC1/BLM15BA750SN1D.PcbLib
Proyecto Altium/SDR_LAPAC1/ButtonE-Switch.PcbLib
Proyecto Altium/SDR_LAPAC1/con-coax.PCBLIB
Proyecto Altium/SDR_LAPAC1/FA-20H 40.0000MF10Z-K3.PcbLib
Proyecto Altium/SDR_LAPAC1/FUSE.PcbLib
Proyecto Altium/SDR_LAPAC1/header2x7.PcbLib
Proyecto Altium/SDR_LAPAC1/LiteOnLed.PcbLib
Proyecto Altium/SDR_LAPAC1/LTC4412.PcbLib
Proyecto Altium/SDR_LAPAC1/MurataCapacitor.PcbLib
Proyecto Altium/SDR_LAPAC1/PCB_SDR.PcbLib
Proyecto Altium/SDR_LAPAC1/Res0402ERJ.PcbLib
Proyecto Altium/SDR_LAPAC1/SDR_LAPAC.SCHLIB
Proyecto Altium/SDR_LAPAC1/SIMIDseries.PcbLib
Proyecto Altium/SDR_LAPAC1/SiT8008AI-72-18E-100.000000G.PcbLib
Proyecto Altium/SDR_LAPAC1/T520V_CAP_330.PcbLib
Proyecto Altium/SDR_LAPAC1/TCM1-63AX+.PcbLib
Proyecto Altium/SDR_LAPAC1/TPS76801QDR.PcbLib
Proyecto Altium/SDR_LAPAC1/WE-TVS-SUPER SPEED.PcbLib
Proyecto Altium/SDR_LAPAC1/Xilinx Artix-7.PcbLib
Proyecto Altium/SDR_LAPAC.PrjPcb
Proyecto Altium/USB3.0.SchDoc
Proyecto Altium/USB3.0.SchLib
