OmarLopezCabrera/Tesis-SDR-LAPAC-Open-Source/(commit log)

2019-07-04 Add files via upload
    Cambio esquemático sección DDR3 y ruteo de la misma
2019-07-04 Add files via upload
    Cambio ruteo y esquemático DDR3
    [FPGA.SchDoc, SDR_LAPAC.PrjPcb]
2019-07-06 Add files via upload
    -Ajustes largos DDR3
    -Footprint Balun
    -Cambios en polígonos GND sección RF
